SpellcasterMom/test/docs/Компактный терминал на ESP32_ инженерная презентация.png

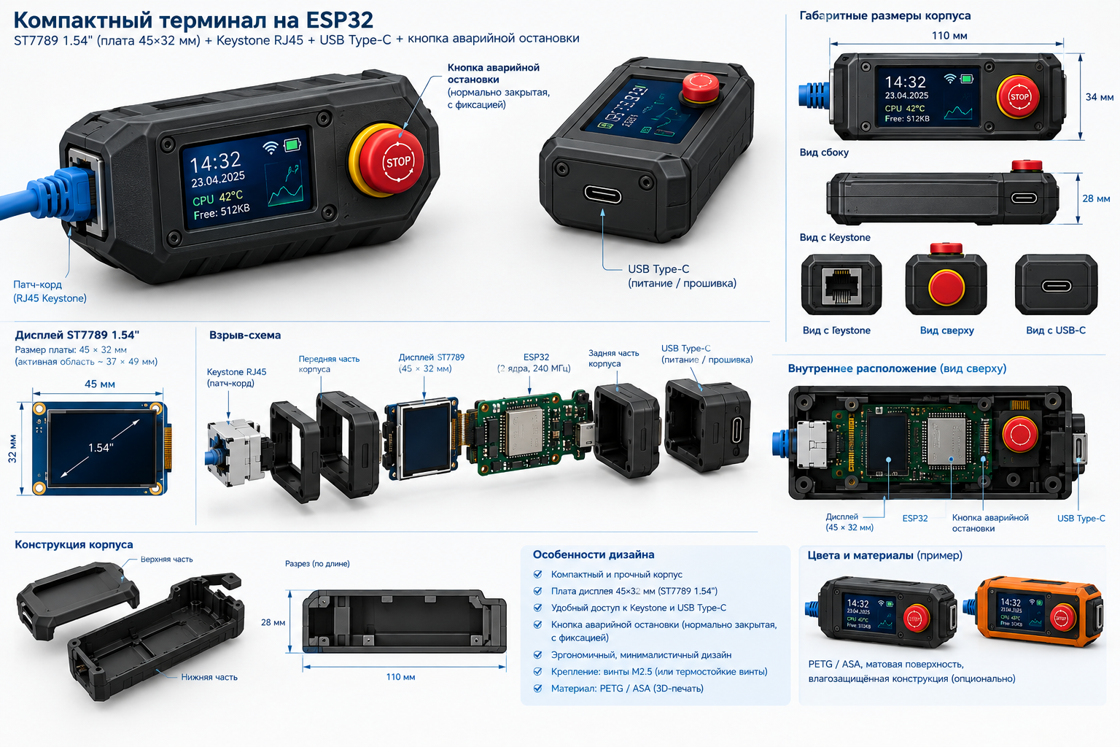
docs/Компактный терминал на ESP32_ инженерная презентация.png
