SpellcasterMom/test/agent.md

# agent.md — рабочие соглашения (проект CLAW, 6DOF)

## Гит
- Работа в ветках, в `master` только принятое на железе; слияние — по команде.
- Несколько машин пушат concurrently: всегда `fetch` перед `push`, чужие коммиты смотреть (`show`/`diff`), мёржить, не перетирать.
- Remote `github` (SpellcasterMom/test) — только по явной команде, иначе молчит.
- Коммиты короткие, по делу; `Last modify` в шапке каждого тронутого файла — обновлять.
- Бамп `FW_VERSION` всегда тянет `FW_VERSION_STR` (минорную тоже).

## Шапки файлов
- `Project / Codename: CLAW / Author / Alma Mater (два слова!) / Group / Mentor / Date / Last modify`.
- «Alma Mater» — раздельно, это латынь. Исключение — только если вуз официально пишет иначе.

## Зависимости
- **Adafruit — нет** (тяжёлые, Unified Sensor не тащим). Лёгкие (pololu, sparkfun) — только после проверки.
- API чужих либ сверять с исходниками до написания кода (адреса, `Wire.begin` внутри, залипающие статусы, unbounded циклы).
- При сомнениях — голые регистры через Wire (пример: `imu_logger.cpp`).

## I2C
- Шина общая (сервы + датчики): все транзакции под `i2cMutex`, только bounded ожидания (никаких `portMAX_DELAY` на шине), `Wire.setTimeout(20)`.
- Счётчики fails/recovers + самовосстановление (`Wire.end/begin` + переинит регистров).
- Физика: подтяжки 4.7к, шлейф ≤20 см, 400 кГц только на хорошей шине (иначе 100 кГц костылём с пометкой).

## Диагностика
- Boot-лог с маркерами; последняя строка = место останова.
- M115: RESIDUAL — истина; скрипты принимают `OK` и `OK:*`.
- Двойник `tools/twin/` предсказывает сверху, валидирован до 0.1° (трекинг-модель).
- Ворота 10 мм / 15° — святое; отказ лучше прыжка в мусор.

## Доки/тексты
- Формулы в MATH.md нумеруются сквозно, ссылки — по номерам.
- «расхождение», не «невязка»; «ограничение», не «рубеж».
- Дипломный стиль: формулы + «где ...» под каждой; читатель умный, но с проектом не знаком (§0).

## Статус: направления P1–P3 (ПАУЗА, продолжение отсюда)

- Ветка `fix-servo-invert-p1p2p3` влита в master (FW9/1.7, флаги F,T,F). Я на `fix-math-s6style`.
- Прошивка в контроллере НЕИЗВЕСТНА (достоверно шили FW8; шился ли FW9 — ?). Маршрут .2.56 мёртв — ждать новый IP.
- Зеркало: `servo=(min+max)−(q+off)`; знак: DH+ ⟺ (флаг ВЫКЛ∧прямое)∨(флаг ВКЛ∧зеркальное). M114 — эхо модели, не физика.
- M502-тесты (флаги T,F,T достоверны; эталоны: P1+15→(−18,+32) влево, P2+15→(−100,+30), P3+15→(−57,+32)): P1 DH−→железо прямое→флаг F; P2 DH−→зеркальное→флаг T; P3 только X, вертикали нет — СПОРНО (визуал 180°: ось неизвестна).
- Слова: CW/CCW сверху, вверх/вниз, на меня/от меня (точка −1000,0,0) — надёжно; влево/вправо, глубина — нет.
- Продолжение: 1) `M115` (FW:x.y!) → 2) `M502` → 3) `G28`+`M105` → 4) P3 ±15 с ОБОИМИ словами → 5) визуал креплений P1/P2 + ось 180° у P3 → 6) флаги → бамп FW → прошить → все DH+ → master. Boot-лог с миграцией — приложить.
