SpellcasterMom/test/docs/MATH.md

# Математика кинематики, планирования и ограничений
### Пояснительная записка (как в дипломе)

## 1. Введение

Объект проектирования — настольный шестиосевой манипулятор: основание с поворотной
башней, плечо, локоть и трёхосевой запястный узел с захватом.

Цель проекта показать умения и навыки разработки и проектирования, полученные во
время обучения в Севастопольском Государственном Университете.

Ввиду жестких ограничений по времени и финансам проект создан
исключительно для демонстрации работы шестиосевого манипулятора.

Электроника — ESP32,
приводы — 7 серво машинок управляемых через PCA9685 (6 осей + захват), обратная связь
по положению отсутствует (open loop по сервам — поэтому вся
точность обязана сходиться в расчёте, глава 3).

Прошивка построена на использовании подмножества G-code «фрезерного»
диалекта: `G0`/`G1` — движение кончика (TCP) в миллиметрах,
`M104` — прямые углы суставов, `M108` — захват в процентах,
`M115` — полная диагностика решения (цель, кандидаты, факт,
расхождения — главный инструмент отладки и приёмки).
Связь с управляющим устройством — по последовательному порту (USB-CDC/UART). 
Ориентация задаётся углами Эйлера ZYX $(A, B, C)$; внутри
расчёта эйлеров нет — только матрицы поворота (почему, см. §3.6).

Три сквозных принципа, на которых всё держится и которые надо учитывать:
1. **Математические углы.** Везде в расчёте используются «чистые» углы
   $q$: ноль — "красивая" поза (плечо вертикально), лимиты —
   симметричные. Перевод в физический мир серв (сдвиги нулей,
   инверсии, микросекунды ШИМ) — отдельная последняя ступень,
   глава 7. Путать эти два мира — источник половины исторических
   багов (см. §7 и §3.4).
2. **Честный отказ.** Неточного движения в прошивке нет как класса:
   любое движение либо сошлось ($\le$ 10 мм / 15°) и безопасно,
   либо не выполняется с диагностируемой причиной в `M115`.
   Пороги и их обоснование — §3.7, философия — §8.
3. **Двойник.** Параллельно с прошивкой есть набор программ `tools/twin/` —
   та же математика на Python (те же сиды, тот же DLS, те же
   пороги). Все числа в записке вида «двойник X — железо Y»
   получены прогоном одного и того же теста на прошивке и двойнике;
   расхождение в десятых — критерий «модель верна».

Система координат: **+X — вперёд, +Y — влево, +Z — вверх**.
Стол — плоскость XY ($z = 0$), origin — центр основания.
Углы суставов $q_1 \dots q_6$ — в градусах, «математические»
(нуль плеча $q_2 = 0$ — вертикаль вверх, см. §3.3).
Сустав 7 ($q_7$) — захват, градусы сервы $7 \dots 38$ (закрыт..открыт,
замер владельца 15.10.2026); проценты `M108` маппятся: $0\% \to 7°$,
$100\% \to 38°$.

Обозначения: $T_{0k}$ — однородная матрица $4 \times 4$ кадра $k$
в базе, $R_{0k}$ — её поворотный блок $3 \times 3$,
$p_k$ — позиция сустава $k$. $\operatorname{atan2}$ — везде
двухаргументный арктангенс (возвращает угол с учётом квадранта,
без разрывов на $\pm 90°$, в отличие от $\arctan$).

---

## Оглавление

- §1. Введение
- §2. Расчет прямой кинематики (FK): цепочка Денавита–Хартенберга
  - 2.1. Матрица однородного преобразования DH
  - 2.2. Параметры цепи (чертёж `docs/robot1.jpg`)
  - 2.3. Цепочка и TCP
- §3. Расчет обратной кинематики (IK): геометрия-сид + матричный DLS
  - 3.1. Этапы расчёта задачи обратной кинематики
  - 3.2. Перенос цели с TCP на запястье
  - 3.3. Геометрия руки: суставы $q_1, q_2, q_3$ (вывод)
  - 3.4. Зажатый сид и компенсация запястья
  - 3.5. Ориентация: суставы $q_4, q_5, q_6$ (сид)
  - 3.6. Численная доводка: Левенберг–Марквардт (DLS)
  - 3.7. Выбор решения: min-residual со штрафами
  - 3.8. Две метрики ориентации — не путать!
  - 3.9. Ворота на кандидате vs дрейф трекинга — не путать!
- §4. Декартово движение (G1/G0): прямая TCP + slerp
  - 4.1. Почему не joint-интерполяция
  - 4.2. Интерполяция позы: lerp + slerp (вывод)
  - 4.3. Трекинг и safety каждого шага
  - 4.4. Время и профиль скорости
- §5. Планировщик объезда (detour): две фазы
  - 5.1. Фаза 1 — via-точки у граней коробов (геометрия)
  - 5.2. Фаза 2 — RRT в joint-space (теория и параметры)
- §6. Проверка ограничений (safety): четыре ограничения
  - 6.1. Ограничение 1 — минимальная высота
  - 6.2. Ограничение 2 — короб workspace
  - 6.3. Ограничение 3 — цилиндр достижимости
  - 6.4. Ограничение 4 — запретные боксы
  - 6.5. Проверка траектории и плотность сэмплирования
  - 6.6. Самопересечения звеньев — капсулы (в работе)
- §7. Сервопривод: цепочка math → микросекунды
  - 7.1. Два мира: математика и железо
  - 7.2. Сдвиг нуля (offset) и таблица приводов
  - 7.3. Коррекция хода и инверсия направления
  - 7.4. Ограничение и ШИМ: разрешение тракта
  - 7.5. Захват P7 и сквозной пример
- §8. Валидация: двойник и железо
  - 8.1. Метод: предсказание — эксперимент — сравнение
  - 8.2. Нулевая поза и воспроизводимость
  - 8.3. Endpoint-демо и наклонный круг
  - 8.4. Отказы: честные и воспроизводимые
  - 8.5. Свип 168 точек с препятствиями
  - 8.6. Границы применимости и открытые пункты
- §9. IMU: фьюжн наклона, калибровка, логгер
  - 9.0. Кадры и единицы: что измеряем
  - 9.1. Комплементарный фьюжн
  - 9.2. Калибровка нуля гироскопа
  - 9.3. Кольцо последнего движения
  - 9.4. Калибровка монтажа (открытый пункт)

---

## 2. Расчет прямой кинематики (FK): цепочка Денавита–Хартенберга

### 2.1. Матрица однородного преобразования DH

Переход между соседними системами координат по соглашению
Денавита–Хартенберга задаётся композицией четырёх элементарных
движений: поворот на угол $\theta$ вокруг оси $Z$, сдвиг
на $d$ вдоль оси $Z$, сдвиг на $a$ вдоль оси $X$, поворот
на угол $\alpha$ вокруг оси $X$:

$$
T = \mathrm{Rot}_z(\theta)\,\mathrm{Tr}_z(d)\,
\mathrm{Tr}_x(a)\,\mathrm{Rot}_x(\alpha).
$$

Раскрытие произведения даёт формулу (1), реализованную
в коде как `FKSolver::dhTransform`:

$$
T(a, \alpha, d, \theta) = \begin{pmatrix}
\cos\theta & -\sin\theta\cos\alpha & \sin\theta\sin\alpha & a\cos\theta \\\\
\sin\theta & \cos\theta\cos\alpha & -\cos\theta\sin\alpha & a\sin\theta \\\\
0 & \sin\alpha & \cos\alpha & d \\\\
0 & 0 & 0 & 1
\end{pmatrix}
\tag{1}
$$

Полный угол каждого сустава: $\theta_i = q_i + \theta_{off,i}$,
где $\theta_{off}$ — заводской сдвиг нулевого положения
(например, $+90°$ у плеча, см. таблицу ниже).

### 2.2. Параметры цепи (чертёж `docs/robot1.jpg`)

| $i$ | $a$ | $\alpha$ | $d$ | $\theta_{off}$ | Назначение звена |
|---|---|---|---|---|---|
| 1 | 0 | +90° | 134 | 0 | база → плечо |
| 2 | 165 | 0 | 0 | +90° | плечо → локоть |
| 3 | 161 | 0 | 0 | 0 | локоть → J4 |
| 4 | 0 | −90° | 0 | −90° | J4 (оси J4/J5 пересекаются) |
| 5 | 53 | +90° | 54 | +90° | J5 → J6 |
| 6 | 0 | 0 | 27 | 0 | J6 → фланец |

Конструктивная особенность: запястье не является сферическим
(расстояние J4→фланец ≈ 107 мм по чертежу); сустав J6 —
вращение вокруг оси инструмента (экспериментально подтверждено:
поворот P6 вращает захват на месте, TCP неподвижен). Палец
захвата длиной $L = 105$ мм продолжает фланец (в DH: переход
J6→фланец 27 мм входит как параметр $d$ звена 6).

### 2.3. Цепочка и TCP

$$
T_{06} = T_1 T_2 \dots T_6, \qquad
\mathbf{n} = \text{третий столбец } R_{06}\ (\text{направление пальца}),
$$

$$
p_{TCP} = p_6 + L \cdot \mathbf{n}. \tag{2}
$$

где $p_{TCP}$ — позиция кончика пальца захвата (задаваемая
в G-code точка), $p_6$ — позиция фланца (конец цепочки, сустав 6),
$L = 105$ мм — длина пальца захвата, $\mathbf{n}$ — единичный
вектор вдоль пальца.

Направления осей суставов в нулевой конфигурации:
J1 — вдоль $Z$, J2 = J3 = J4 — вдоль $-Y$, J5 — вдоль $+Z$,
**J6 — вдоль $+X$**. Нулевая конфигурация $q = 0$:

$$
p_{TCP}(0) = (132,\, 53,\, 514),\quad \text{инструмент } +X.
$$

Контрольная подстановка: плечо вертикально при $q_2 = 0$,
поэтому цепочка J1(134) → +165 → +161 даёт высоту
$z = 134 + 165 + 161 = 460$ на оси; далее запястье со сдвигом
$d_5 = 54$ вдоль собственной оси и фланцем 27 мм выводит TCP в
$(132, 53, 514)$. Значение измерено линейкой на физическом
манипуляторе и принято за калибровочный эталон всей модели.

---

## 3. Расчет обратной кинематики (IK): геометрия-сид + матричный DLS

### 3.1. Этапы расчёта задачи обратной кинематики

Задача: по цели $(p^*, R^*)$ найти $q$ в лимитах
($\pm135°$ для всех суставов P1–P6), где $p^*$ — целевая позиция
кончика пальца (TCP) в миллиметрах $(x, y, z)$ в базовой системе
координат, $R^*$ — целевая матрица поворота инструмента $3 \times 3$
(куда смотрит палец и как он повёрнут вокруг своей оси),
$q = (q_1 \dots q_6)$ — искомые углы суставов в градусах.

Геометрия §3.2–§3.5 — это только **стартовые точки** (сиды):
приближённый аналитический ответ «куда примерно смотрит рука».
Точное решение наводит **матричная** доводка §3.6: внутри DLS
нет ни эйлеров, ни проекций $(r,s)$ — только FK-цепочка матриц,
целевая матрица $R^*$ и матрица ошибки $R_e = R^* R(q)^T$.
Геометрия быстро даёт глобальную структуру (ветвь локтя,
разворот базы), матрицы — точные миллиметры и градусы
с учётом несферического запястья.

### 3.2. Перенос цели с TCP на запястье

Геометрия двухзвенника решает позицию **запястья**, а пользователь
задаёт TCP, поэтому сначала:

$$
w = p^* - L \cdot \mathbf{n}^*, \qquad
\mathbf{n}^* = \text{3-й столбец } R^*. \tag{3}
$$

где $w$ — позиция запястья (то, что реально решает геометрия),
$\mathbf{n}^*$ — целевое направление пальца (третий столбец
целевой матрицы поворота $R^*$).

Без этой поправки ошибка была ≈ 20 мм (решали для запястья,
показывали TCP) — отловлено сравнением M114 с линейкой.

### 3.3. Геометрия руки: суставы $q_1, q_2, q_3$ (вывод)

**База.** Проекция цели на плоскость XY; угол —
однозначно через $\operatorname{atan2}$ (покрывает все 4 квадранта,
особенность только в точке $(0,0)$ — рука строго над осью):

$$
q_1 = \operatorname{atan2}(w_y, w_x). \tag{4}
$$

**Плоскость руки.** После поворота базы вся рука лежит
в вертикальной полуплоскости. Вводим координаты в ней
($d_0 = 134$ — высота плеча, $a_0 = 0$):

$$
r = \sqrt{w_x^2 + w_y^2} - a_0, \qquad
s = w_z - d_0, \qquad
\rho = \sqrt{r^2 + s^2}. \tag{5}
$$

**Достижимость.** Треугольник со сторонами $L_1 = 165$,
$L_2 = 161$ и $\rho$ существует тогда и только тогда, когда

$$
|L_1 - L_2| \le \rho \le L_1 + L_2
\quad\Longleftrightarrow\quad
4 \le \rho \le 326\ \text{мм}. \tag{6}
$$

Внутренняя граница 4 мм — почти вырожденный треугольник
(рука сложена в себя); внешняя 326 мм — полное вытяжение.
Вне кольца — геометрического решения нет (но сид всё равно
строится, см. §3.4).

**Локоть.** По теореме косинусов для угла при вершине локтя:

$$
\rho^2 = L_1^2 + L_2^2 - 2L_1L_2\cos(\pi - |q_3|)
= L_1^2 + L_2^2 + 2L_1L_2\cos q_3,
$$

откуда (знак минус — ветвь «elbow down», $q_3 < 0$):

$$
\cos q_3 = \frac{r^2 + s^2 - L_1^2 - L_2^2}{2L_1L_2},
\qquad q_3 = -\arccos(\cdot). \tag{7}
$$

Аргумент clamp'ится в $[-1, 1]$ от численного дребезга.

**Плечо.** Угол на цель минус внутренний угол треугольника.
Второе слагаемое (8) — та же формула через $\operatorname{atan2}$
(устойчива при $C \approx 0$, т.е. рука перпендикулярна плечу):

$$
q_2^{DH} = \operatorname{atan2}(s, r)
- \operatorname{atan2}\!\big(L_2 \sin q_3,\; L_1 + L_2 \cos q_3\big).
\tag{8}
$$

Здесь $C = L_1 + L_2\cos q_3$ — проекция двухзвенника
на ось руки, $S = L_2\sin q_3$ — поперечная. Геометрический
смысл: $\operatorname{atan2}(s,r)$ — направление на цель,
$\operatorname{atan2}(S,C)$ — поправка на излом в локте.

**Нуль плеча.** Геометрия считает от горизонтали DH-кадра,
а математический нуль — вертикаль:

$$
q_2 = q_2^{DH} - \theta_{off,2}, \qquad \theta_{off,2} = +90°.
\tag{9}
$$

Все три угла — в градусы ($q_1$ тоже: $\times 180/\pi$).

### 3.4. Зажатый сид и компенсация запястья

**Зажатый сид** (`solvePositionClamped`): вместо отказа при
$\rho$ вне кольца (6) точка $(r, s)$ радиально масштабируется
в кольцо $[|L_1-L_2|+\varepsilon, L_1+L_2-\varepsilon]$.
DLS получает старт рядом с целью, а не в произвольной
удалётненной точке. Двойник:
`solve_position(clamped)`.

**Компенсация несферического запястья** (`seedArm`): чистая
геометрия кладёт J4 в точку фланца $O_6$ — сид уходит мимо
на длину J4→O6 (≈ 107 мм). Fixed-point, 3 итерации:

$$
j^{(k+1)} = w - \big(O_6(q^{(k)}) - J_4(q^{(k)})\big),
\qquad j^{(0)} = w, \tag{10}
$$

где $j^{(k)}$ — цель $k$-й итерации (точка, в которую кладём J4),
$O_6(q)$ — позиция фланца при углах $q$, $J_4(q)$ — позиция
сустава J4 (конца двухзвенника) при тех же углах; разность
$O_6 - J_4$ — текущий вылет запястья, который вычитаем из цели.

каждая итерация — §3.3 на новой цели $j$ (строгий или зажатый
вариант). Смысл: требуем, чтобы именно J4 (конец двухзвенника),
а не фланец, лёг в цель с поправкой на вылет запястья.
Отображение сжимающее, пока запястье коротко против
$L_1 + L_2$ (107 против 326 — запас тройной), трёх итераций
хватает с запасом.

**Вторая ветвь** «elbow up»: $q_3 := -q_3$ (в градусах! для
$\sin/\cos$ — перевод в радианы; старая ошибка «градусы в sin»
давала неверное значение $q_2$ — отловлена ревью двойника):

$$
q_2^{up} = \operatorname{atan2}(s, r)
- \operatorname{atan2}\!\big(L_2\sin q_3^{up},\, L_1 + L_2\cos q_3^{up}\big)
- \theta_{off,2}, \tag{11}
$$

на той же компенсированной цели $j$.

### 3.5. Ориентация: суставы $q_4, q_5, q_6$ (сид)

$T_{03}$ — через общий FK-движок (учитывает $\theta_{off}$;
вручную собранные $T_{01}T_{12}T_{23}$ их игнорировали
и дублировали FK — устранено). Далее:

$$
R_{36} = R_{03}^T \cdot R^*, \qquad (R_{03}^{-1} = R_{03}^T).
\tag{12}
$$

Декомпозиция ZYX ($R = R_zR_yR_x$, вывод — приравниванием
элементов матрицы (16) поэлементно):

$$
q_4 = \arcsin(-R_{20}), \quad
q_5 = \operatorname{atan2}(R_{21}, R_{22}), \quad
q_6 = \operatorname{atan2}(R_{10}, R_{00}). \tag{13}
$$

Замок кардана ($|R_{20}| > 0.9999$, pitch ≈ ±90°): строки
$R_{21}, R_{22}$ и $R_{10}, R_{00}$ вырождаются (деления $0/0$
в пределе), поэтому одна степень свободы фиксируется
($q_6 := 0$), вторая доопределяется через surviving
$\operatorname{atan2}$. Решение существует, но не единственно —
для стартовой точки достаточно, точность наводит §3.6.

### 3.6. Численная доводка: Левенберг–Марквардт (DLS)

**Постановка.** Минимизируется взвешенная сумма квадратов
расхождения $\Phi(q) = \frac{1}{2}\|e(q)\|^2$, где $e \in \mathbb{R}^6$
(половина компонент — миллиметры позиции, половина —
«градусы × вес» ориентации, см. (15); множитель $\frac12$
убирается при дифференцировании). Метод Ньютона для суммы
квадратов (Гаусс–Ньютон) линеаризует расхождение вокруг текущей
точки, $e(q + \Delta q) \approx e + J\Delta q$, и решает
нормальную систему $J^TJ\,\Delta q = -J^Te$.
Чистый метод Гаусса–Ньютона отказывает двояко: во-первых,
квадратичная модель достоверна лишь вблизи текущей точки,
и полный ньютоновский шаг регулярно перелетает через минимум;
во-вторых, у кинематических сингулярностей (суставы на одной
линии, рука в полном вытягивании) якобиан вырождается
и нормальная система не имеет устойчивого решения.
Оба отказа лечатся демпфированием Левенберга–Марквардта —
штрафом $\lambda^2\|\Delta q\|^2$ за длину шага:

$$
(JJ^T + \lambda^2 I)\, y = e, \qquad \Delta q = -J^T y,
\tag{14}
$$

где $J$ — якобиан $6 \times 6$ ($\partial e_i / \partial q_j$,
см. (16)), $\lambda$ — демпфирование (больше — мельче и осторожнее
шаг), $I$ — единичная матрица, $y$ — вспомогательный вектор
(решение линейной системы), $\Delta q$ — шаг по суставам в радианах.

эквивалентная форма через $JJ^T$ ($6 \times 6$ вместо $J^TJ$ —
та же размерность здесь; эквивалентность — тождество проталкивания
$(J^TJ + \lambda^2I)^{-1}J^T = J^T(JJ^T + \lambda^2I)^{-1}$,
выбрана форма с взвешенными строками расхождения). Предельные режимы
показывают смысл $\lambda$ как интерполяции между методами:
при $\lambda \to 0$ — шаг Гаусса–Ньютона (быстрая сходимость
вблизи цели), при $\lambda \to \infty$ — шаг градиентного спуска
$\Delta q \approx -\frac{1}{\lambda^2}J^Te$ (короткий и безопасный
вдали от цели). Адаптация $\lambda$ (расписание ниже) перемещается
между режимами автоматически.

Расписание $\lambda$ (параметры кода `NLS_LAMBDA = 0.3` старт):
успешная итерация — $\lambda \times 0{.}5$ (пол $10^{-3}$,
дальше только точнее); неуспешная — $\lambda \times 4$
(потолок $10^4$); 15 неуспехов подряд — останов (точка признана
безнадёжной для данного сида, возвращается лучшее найденное).
Смысл чисел: множитель 4 быстро душит расходящийся шаг,
а 15 застоев отделяют «медленно, но идёт» от «стоит на месте».

**Вектор расхождения.** Позиция — напрямую в миллиметрах:

$$
e_{1..3} = p^* - p(q).
$$

Ориентация — axis-angle ошибки с весом $W = 30$:

$$
R_e = R^* R(q)^T, \quad
\theta_e = \arccos\!\left(\tfrac{\operatorname{tr} R_e - 1}{2}\right),
\tag{15}
$$

$$
e_{4..6} = W \cdot \theta_e \cdot \mathbf{u}, \quad
(R_e - R_e^T)^\vee = 2\sin\theta_e \, \mathbf{u}.
$$

Вывод оси: для любого поворота $R(\mathbf{u}, \theta)$ верно
$R - R^T = 2\sin\theta\,[\mathbf{u}]_\times$, компоненты
кососимметричной части — это $(2\sin\theta\,u_x,
2\sin\theta\,u_y, 2\sin\theta\,u_z)$, т.е. $a_x = R_{21}-R_{12}$
и т.д. Нормировка $a/\|a\|$ даёт $\mathbf{u}$, домножение
на $\theta_e$ — вектор $\theta_e\mathbf{u}$.

Почему вес 30: $1° = 0.0175$ рад $\times 30 \approx 0{.}52$
«условных мм» — градус ориентации стоит полмиллиметра позиции
(комментарий в коде: «1° ≈ 0.5 усл.мм»). Баланс подобран так,
чтобы DLS не жертвовал сантиметрами ради градуса и наоборот.

Почему axis-angle, а не разность эйлеров: эйлерова разность
имеет разрывы свёртки $\pm180°$ (прыжок метрики при непрерывном
движении → ложный всплеск якобиана → «большой градиент»).
Хуже того, свёртка через синус ($0{.}5\sum\mathrm{cross}$)
при $\theta_e \to 180°$ показывает **ноль** и тянет решатель
к ложному минимуму «вверх ногами». Axis-angle непрерывен
всюду, кроме точки $\theta_e = \pi$ (там ось вырождена —
закрыта запасной осью $X$: приближённо, но сохраняет градиент
и не даёт ложный ноль»).

**Якобиан** — численный: столбец $j$ —

$$
J_{ij} = \frac{e_i(q + \delta \mathbf{b}_j) - e_i(q)}{\delta},
\qquad \delta = 10^{-4}\ \text{рад}. \tag{16}
$$

где $\mathbf{b}_j$ — $j$-й базисный вектор (единица в позиции $j$,
нули иначе: возмущаем только сустав $j$), $\delta$ — шаг численного
дифференцирования в радианах.

Цена итерации: 7 вычислений $e$ (база + 6 возмущений),
каждое — полный FK, плюс решение системы $6 \times 6$ методом
Гаусса (~$6^3/3$ операций). Итого worst case: ~700 FK-вычислений
и 100 решений СЛАУ на доводку — единицы миллисекунд на ESP32,
т.е. метод укладывается в такт интерполятора 20 мс с запасом.
Аналитический якобиан ($J_v$ через
$z_{k-1} \times (p - p_{k-1})$) был бы в 7 раз дешевле,
но численный не расходится с FK по определению —
осознанная плата за неубиваемость (и она же даёт
зеркало 1:1 с двойником).

**Знак минус** в (14) обязателен: минимизируется
$\|e + J\Delta q\|^2 + \lambda^2\|\Delta q\|^2$, т.е.
$(J^TJ + \lambda^2I)\Delta q = -J^Te$. Без минуса — подъём
вместо спуска: все шаги бракуются line search и итогом
всегда остаётся сид (реальный отловленный баг, M115
показывал `seed = best` во всех строках).

**Active-set на лимитах.** Сустав, стоящий на лимите
($\pm\varepsilon = 10^{-4}$) и толкающий наружу, исключается
из задачи (обнуляется столбец $J$), направление пересчитывается
(до 6 раундов). Иначе зажатое направление душит спуск
по свободным суставам: проекция градиента на допустимый
ортант — классика constrained optimization, здесь —
напрямую, без QP-солвера (6 суставов позволяют).

**Line search.** Backtracking: полный шаг, половинки, …
до 10 попыток — берётся первый, строго уменьшивший $\|e\|$.
Иначе $\lambda \times 4$ (потолок $10^4$), после 15 застоев —
стоп. При успехе $\lambda \times 0{.}5$ (пол $10^{-3}$).
Ограничение шага: $|\Delta q_k| \le 0{.}2$ рад/итерацию.

**Возврат.** Лучшее $q$ за все итерации (не последнее —
при несходимости последнее может быть хуже). Пробные точки
дополнительно зажимаются в лимиты сервоприводов (выход
за пределы физически невозможен даже промежуточно).
Допуски: 1 мм / 1°, лимит 100 итераций. Захват ($q_7$) не трогается.

**Чтение сходимости по M115 (разбор живого примера).**
Диагностика сида: `seed=107.6mm/98.5deg` (расхождение
старта) → `dq0` (норма первого шага) → `n1` (расхождение после
него) → `fail/53it` (итог). Эталонная расшифровка на строке
T1 [0] (`seed=101.7/79.0, dq0=0.486, n1=121.1, fail/50it`):
норма первого шага 0.486 рад — здоровый начальный шаг
(не ноль — градиент есть, не единица — без перелёта);
$n_1 = 121.1 > seed = 101.7$ — полный шаг Гаусса–Ньютона
перелетел (классика), backtracking его уполовинил,
$\lambda$ выросла; дальше — 50 итераций шлифовки,
сошедшихся не в допуски, но в лучшее найденное.
По этой цепочке видно, где умерла сходимость:
`seed = best` во всех строках — нулевой прогресс
(подпись отменённого минуса — регрессионный маркер,
см. выше); `n1 < seed`, но `fail` — прогресс был,
но допуски не взяты (точка на грани достижимости).

### 3.7. Выбор решения: min-residual со штрафами

Кандидаты (до 4): elbow down/up + «нули» (сильная ветвь
верхней полусферы; для цели «нули» — 0 итераций) + доводка
от текущей позы (трекинг при стриминге: DLS из current
сходится за ~2 итерации — двойник 40/40 из ±10°).

Каждая оценивается честным FK (`diagEvalSol`): $dPos$ —
евклидово до TCP (мм), $dOri$ — **угол между осями инструмента**
(см. §3.8), $safe$ — `checkAllLinks`, $minZ$ — минимум $z$
суставов J2..J6 (без J0/J1: база и плечо всегда высоко,
признак низко висящей ветви несут локоть и ниже).

Чистый минимум расхождения не годится: он выбирает самую точную
ветвь, не глядя, как рука туда попадёт, — отсюда перебросы
на 250° ради долей миллиметра и любовь к низким скрюченным
конфигурациям. Поэтому к точности добавляются два штрафа —
за дальность прыжка и за низость ветви:

Оценка:

$$
\mathrm{score} = dPos + dOri + 0{.}02 \cdot \Delta q_{max} + hPen,
\tag{17}
$$

$$
hPen = \min\!\big(0{.}15 \cdot \max(0, 150 - z_{min}),\; 15\big),
$$

- $\Delta q_{max}$ — максимальный прыжок сустава от текущей
  позы; коэффициент $0{.}02$ — это штраф за дальность прыжка
  (continuity-штраф: прыжок 50° окупается лишь
  при +1 мм/1° точности, потому что каждый градус прыжка —
  это риск хлыста и лишнее время хода; чистый min-residual выбирал ветвь
  в 250° ради 0.3 мм — резкие перебросы без необходимости,
  отловлено двойником на круге);
- $hPen$ — высотный штраф (штраф за низость ветви: ниже $z = 150$
  предпочитаем верхние   ветви, потому что верхняя конфигурация
  дальше от стола, колонны и собственных деталей — небольшой
  проигрыш в точности окупается запасом безопасности, тогда как
  столкновение недопустимо ни при какой точности);
  низко висящая ветвь с локтем на $z = 17$ проигрывает высокой
  ветви; срезка 15 делает честно-низкую работу нейтральной
  (штраф у всех максимальный и одинаковый — решает расхождение).

Из опыта отладки: «первый безопасный» систематически брал
худший вариант (M115: [0] 2.7 мм/23.8° вместо [1] 2.2 мм/0.0°) —
поэтому полный перебор с оценкой, а не выход по первому годному.

**Порог годности** (ворота движения):

$$
dPos \le 10\ \text{мм} \quad \text{и} \quad dOri \le 20°.
\tag{18}
$$

Лучший безопасный кандидат хуже порога — уже не заданное
движение (например, 127 мм мимо из-за отбраковки точных,
но опасных). Отказ `ERROR: No accurate safe IK` с лучшим
достигнутым расхождением. Рабочие ходы идут с $dPos < 1$ мм
(двойник + железо). Философия: лучше честно стоять,
чем выполнять недостоверное движение.

### 3.8. Две метрики ориентации — не путать!

Внутри DLS (§3.6) минимизируется **полное** axis-angle-расхождение
(15) — все три вращательные степени, включая roll вокруг
пальца. А в отборе (17), пороге (18) и M115 $dOri$ — **угол
между осями инструмента**:

$$
dOri = \arccos(\mathbf{n}(q) \cdot \mathbf{n}^*).
\tag{19}
$$

Обоснование: ось пальца — то, что ставит точку и сверлит;
roll вокруг неё обычно не критичен (P6 крутит захват
на месте). DLS при этом всё равно тянет полную ориентацию,
так что расхождение метрик — только в воротах, не в движении.
Для задач, где roll важен (захват плоского предмета),
ворота (18) надо ужесточать отдельно — открытый пункт.

### 3.9. Ворота на кандидате vs дрейф трекинга — не путать!

Ворота (18) проверяются на **кандидате** (решение IK для конца),
а едет декарт трекингом по шагам — конечный факт может уплыть
дальше кандидата. Живой кейс: точки 17/18 наклонного круга —
кандидат прошёл (≤15°), факт 19.0/19.2°. Это не баг ворот,
это их граница: ворота гарантируют качество старта решения,
а не финиша трекинга. Диагностика честная в обе стороны:
`RESIDUAL` показывает факт, `INTERP: NONE no motion (refused)`
после отказа — что прошлого следа не осталось (раньше M115
показывал INTERP прошлого удачного хода — починено).

---

## 4. Декартово движение (G1/G0): прямая TCP + slerp

### 4.1. Почему не joint-интерполяция

Линейное движение в суставах ($q(t) = q_0 + t(q_1 - q_0)$)
даёт дугу TCP в декартовых координатах — для прямолинейных
операций (сварка, вставка, проход над столом) неприменимо.
Поэтому задаётся обратное: прямая фиксируется в декарте,
а углы суставов на каждом шаге восстанавливаются
IK-трекингом (§4.3).

### 4.2. Интерполяция позы: lerp + slerp (вывод)

Позиция — линейная с профилем $e(t)$ (§4.4):

$$
p(t) = p_0 + e(t)\,(p_1 - p_0). \tag{20}
$$

где $p_0$, $p_1$ — стартовая и целевая позиции TCP (мм),
$t \in [0, 1]$ — безразмерное время шага, $e(t)$ — профиль
скорости (0 → 1, см. (25) в §4.4).

Ориентация — slerp (spherical linear interpolation):
поворот с постоянной угловой скоростью от стартовой матрицы
$R_0$ к целевой $R_1$. Относительный поворот между ними:

$$
R_d = R_0^T R_1, \quad
\theta = \arccos\!\left(\tfrac{\operatorname{tr} R_d - 1}{2}\right),
\tag{21}
$$

где $R_d$ — относительный поворот (величина доворота
и его направление от старта к цели), $\theta$ — его угол,
$\operatorname{tr}$ — след матрицы (сумма диагонали).
Ось $\mathbf{u}$ извлекается из кососимметричной части
тем же выделением оси, что в (15). Тогда:

$$
R(t) = R_0 \cdot \mathrm{Rot}(\mathbf{u},\, \theta \cdot e(t)).
\tag{22}
$$

где $\mathrm{Rot}(\mathbf{u}, \alpha)$ — поворот на угол $\alpha$
вокруг единичной оси $\mathbf{u}$ (формула Родрига (23) ниже).

Постоянство угловой скорости следует из конструкции:
угол от $R_0$ до $R(t)$ равен $\theta \cdot e(t)$ — при линейном
$e(t) = t$ движение равномерно, $\dot{\phi} = \theta/T$.
Матрица поворота вокруг оси задаётся формулой Родрига (23).
Вывод формулы: разложение экспоненты генератора поворота
$R = e^{\phi[\mathbf{u}]_\times}$ в ряд с учётом тождества
$[\mathbf{u}]_\times^3 = -[\mathbf{u}]_\times$ даёт
$R = I + \sin\phi\,[\mathbf{u}]_\times
+ (1 - \cos\phi)\,[\mathbf{u}]_\times^2$.
Покомпонентно ($c = \cos a$, $s = \sin a$, $a = \theta e(t)$ —
текущий угол доворота, $(x, y, z)$ — компоненты единичной оси
$\mathbf{u}$):

$$
\mathrm{Rot} = \begin{pmatrix}
c+x^2(1-c) & xy(1-c)-zs & xz(1-c)+ys \\\\
yx(1-c)+zs & c+y^2(1-c) & yz(1-c)-xs \\\\
zx(1-c)-ys & zy(1-c)+xs & c+z^2(1-c)
\end{pmatrix}
\tag{23}
$$

— ровно эта матрица собирается в коде из $ca, sa, x, y, z$.

Вырождение $\theta \approx 180°$: ось, извлекаемая
из $(R_d - R_d^T)$, обращается в нуль. Резервный вариант —
столбец максимальной диагонали $(R_d + I)/2$: для поворота
на $\pi$ справедливо $R_d + I = 2\mathbf{u}\mathbf{u}^T$,
т.е. диагональные элементы равны $2u_i^2$, а внедиагональные —
$2u_iu_j$. Вычисляется $\max(xx, yy, zz)$, ось восстанавливается
с корректным знаком через смешанные элементы. Без этой ветви
разворот «через спину» приводил к неопределённости оси (NaN)
и останову движения.

Матрица цели шага $R_t$ (из slerp (22)) передаётся
**напрямую** в матричный доводчик `refineSolutionM` —
промежуточного перевода в углы Эйлера нет. Это осознанно:
углы Эйлера $(A, B, C)$ имеют разрыв свёртки на $\pm180°$ —
значения $+179°$ и $-179°$ физически различаются на $2°$,
а численно — на $358°$. Линейная интерполяция самих углов
(от $A_0$ к $A_1$ напрямую числами) в такой ситуации повела бы
инструмент длинным путём через весь оборот либо дала скачок.
У матриц поворота разрыва нет (пространство поворотов непрерывно),
поэтому slerp всегда идёт короткой дугой и скачкообразных
изменений ориентации не возникает.

Углы Эйлера вычисляются один раз на шаг — и только потому,
что их требует интерфейс резервной геометрии `solveAll`:
на вход она принимает структуру `Pose` (позиция + тройка
эйлеров $A, B, C$). Это однократное преобразование матрица→эйлеры
безвредно: выбор среди кандидатов `solveAll` делается
по дистанции в пространстве суставов до $q_{prev}$
(углов предыдущего шага, в градусах суставов), а не по
близости эйлеровых троек, — поэтому артефакты свёртки
на выбор повлиять не могут в принципе.

Замечание о терминах (важно не путать): тройка $(A, B, C)$ —
это желаемая ориентация **инструмента целиком** (куда смотрит
палец и как он повёрнут вокруг своей оси), а не углы запястья.
Углы суставов запястья $q_4, q_5, q_6$ — это результат
разложения (§3.5): ответ на вопрос «как выставить суставы»,
а не постановка задачи.

Вырожденный случай: $\|p_1 - p_0\| < 0{.}5$ мм и $\theta < 0{.}5°$ —
движение отсутствует, сразу успех (защита от дрожания при
потоковой подаче мелких шагов).

### 4.3. Трекинг и safety каждого шага

Каждый декартов шаг — это IK **от предыдущего** $q$ (тёплый старт
метода Ньютона: сходимость за ~2 итерации, поскольку шаг мал
и стартовая точка уже находится в бассейне притяжения)
плюс проверка `checkAllLinks` (§6).
При срыве — останов на последнем корректном шаге. Команда M112,
поступившая в Serial посреди цикла, прерывает движение немедленно
(проверка в каждой итерации шага).

Грубая end-IK для оценки времени: из двух вариантов
{трекинг-refine, геометрия solveAll} берётся ближайший
к текущей конфигурации — автономный refine иногда уходит
в дальнюю ветвь и завышает время в разы (рука после этого
движется медленно, хотя геометрически путь рядом).

### 4.4. Время и профиль скорости

Длительность движения определяется самым медленным суставом:

$$
T = \max_{i=1..7} \frac{|q_i^{goal} - q_i^{start}|}{\omega_i}
\cdot \frac{100}{F}, \tag{24}
$$

$\omega_{1..3} = 45°/\text{с}$ (дефолт; $F$ — подача G-кода
в процентах, $F = 100$ — полная). Число шагов:
$N = T / 20\,\text{мс}$ (`STEP_INTERVAL_MS = 20`;
порог страгивания `MIN_STEP_DEG = 0{.}1°` — меньшие смещения
не исполняются).

Профиль — квадратичный ease-in-out:

$$
e(t) = \begin{cases}
2t^2, & t < 0{.}5, \\\\
1 - \dfrac{(2 - 2t)^2}{2}, & t \ge 0{.}5,
\end{cases}
\qquad e(0) = 0,\ e(1) = 1. \tag{25}
$$

Скорость $\dot{e}(t) = 4t$ / $4(1-t)$: старт и финиш
с нулевой скоростью (без рывка), максимум $2$ в середине —
при том же $T$ движение в 1.5 раза быстрее равномерного
($\int_0^1 e = 0{.}5$ в обоих случаях, но ease-in-out
концентрирует скорость в середине пути). Ускорение
кусочно-постоянно и равно $\pm4/T^2$ (разрыв ускорения —
только в точке $t = 0{.}5$; при наших скоростях допустимо,
механика сервоприводов дополнительно сглаживает профиль).

---

## 5. Планировщик объезда (detour): две фазы

Задача планировщика — соединить стартовую конфигурацию $q_{start}$
с целевой $q_{goal}$ цепочкой промежуточных вейпоинтов
$w_1 \dots w_m = q_{goal}$, каждое ребро которой безопасно
(проверяется §6), а инструмент при этом не проходит сквозь
запретные боксы. Архитектура двухфазная по экономическим
соображениям: сначала вычислительно недорогая геометрическая
фаза (десятки операций, закрывает типовой случай «столб
посередине»), и только если её недостаточно — затратная
сэмплинговая фаза в пространстве суставов. Исполнение цепочки — через
`moveToDetour` (каждый лег — движение §4). Зеркало алгоритма:
`tools/twin/detour.py` — те же этапы, те же пороги.

### 5.1. Фаза 1 — via-точки у граней коробов (геометрия)

Поводом для объезда служит пересечение отрезка TCP
старт→цель с активным боксом $(x_{1,2}, y_{1,2}, z_{1,2})$.
Пересечение детектируется прямолинейно — 21 равномерной пробой
$p(t) = p_0 + t(p^* - p_0)$ с тестом попадания (29) в каждой.
Если пересечения нет, фаза завершается пустой (объезжать нечего).
Иначе для каждого задетого бокса строится 7 кандидатов в обход:
шесть отступов от граней на `DET_CLEAR = 30` мм
($x_1 - 30$, $x_2 + 30$, $y_1 - 30$, $y_2 + 30$,
$z_1 - 30$, $z_2 + 30$ — по остальным осям берётся центр бокса)
плюс середина исходного отрезка (на случай, когда бокс лишь
«проколот» отрезком, а рядом свободно).

Каждый кандидат проходит тройной фильтр (все условия обязательны):
во-первых, точка обязана лежать вне **всех** активных боксов —
иначе объезд одного препятствия упрётся в соседнее;
во-вторых, IK-точность $dPos \le 5$ мм (`DET_VIA_DPOS`) —
via обязана быть точнее порога движения (18), иначе её
собственная ошибка съест запас точности всего пути;
в-третьих, `checkAllLinks` для конфигурации via чист (§6)
и ребро старт→via проходит `checkTrajectory` (10 проб,
`DET_RRT_EDGE`). Лимит фазы — 8 via-точек (`vias[8]`);
на практике хватает одной-двух.

### 5.2. Фаза 2 — RRT в joint-space (теория и параметры)

Прежде чем строить дерево, проверяется быстрый путь —
ребро старт→цель напрямую (`checkTrajectory`, 20 проб).
Он свободен в подавляющем большинстве движений (порядка 95%),
и тогда планировщик завершается сразу, без сэмплинга.

В оставшихся случаях строится RRT (Rapidly-exploring Random Tree)
в пространстве суставных углов $\mathbb{R}^6$. Поиск ведётся
именно в joint-space, а не в декарте, по соображениям стоимости:
проверка ребра — это готовый быстрый `checkAllLinks` (§6),
тогда как декартово ребро требовало бы IK на каждой пробе
(вычислительно затратно, плюс разрывы ветвей при смене
конфигурации).
Метрика дерева — евклидова в градусах $\mathbb{R}^6$;
это осознанное упрощение (градус базы даёт большее смещение
TCP, чем градус запястья), достаточное для поиска прохода —
оптимизация длины пути отдана сглаживанию ниже
(см. абзац «Сглаживание»).

Параметры роста (`detour_planner.cpp`) подобраны под ESP32:
потолок дерева — 120 узлов (`DET_RRT_NODES`), память статическая
($120 \times 7$ чисел с плавающей точкой плюс родители —
единицы килобайт, динамического выделения нет);
шаг роста — 30° (`DET_RRT_STEP`), новый узел откладывается
от ближайшего к случайной пробе по формуле
$q_{near} + (q_{rnd} - q_{near}) \cdot \min(1, 30/\|d\|)$
с зажимом в лимиты сервоприводов;
смещение к цели (goal bias) 30% — каждая третья проба
подменяется самой целью, что ускоряет сходимость в разы
против чистого равномерного сэмплинга;
генератор — LCG (линейный конгруэнтный генератор:
следующее псевдослучайное число получается из предыдущего
по формуле $x_{n+1} = 1664525\,x_n + 1013904223$)
с фиксированным сидом 12345, т.е. дерево **детерминировано** —
повтор даёт то же дерево (воспроизводимость для диплома
и отладки; оборотная сторона — зацикливание на одном
и том же неуспехе лечится сменой сида).
Ребро принимается в дерево, только если узел чист
по `checkAllLinks` и ребро от родителя проходит
`checkTrajectory` (10 проб); стыковка с целью проверяется
каждую 4-ю итерацию плюс финальной попыткой из ближайшего
к цели узла.

Теоретическое свойство метода (для записки): RRT
**вероятностно полон** — при числе узлов, стремящемся
к бесконечности, вероятность найти проход (если он существует)
стремится к единице. При нашем потолке 120 узлов практическое
прочтение скромнее: простой обход будет найден, сложную щель
метод может не найти — этот случай покрывает честный отказ
(§3.7, ворота (18)).

**Сглаживание.** Сырая цепочка «родитель→потомок»,
извлечённая из дерева, имеет пилообразную форму, поэтому
применяется жадное спрямление срезами: от текущего узла
цепочки выбирается самый дальний узел, достижимый
проверенным ребром (`checkTrajectory`, 10 проб), и далее —
от него. Сложность процедуры — $O(m^2)$ проверок рёбер
при длине цепочки $m$ (цепочки короткие — не критично),
а результат — почти минимальная по числу хопов цепочка
в построенном дереве (не глобальный оптимум,
но гладкий путь без пилы).

**Усечение и возврат.** Хвост цепочки — всегда проверенная
цель. Если цепочка целиком не помещается в выходной буфер
`wps[cap]`, стартовая точка пропускается: оборванная цепочка
без цели хуже отказа (исполнение остановилось бы
в промежуточной точке без команды). Возврат 0 означает
«обхода нет» и превращается выше в честный отказ из §3.7.

В M115 исполнение видно как `INTERP: DET n` ($n$ — число
вейпоинтов), `WPS nwp=N [...]`, `minZ=...`.

---

## 6. Проверка ограничений (safety): четыре ограничения

Для заданной конфигурации $q$ прямая кинематика даёт позиции
всех суставов, и каждое звено рассматривается как отрезок
$A \to B$ от сустава $i$ к суставу $i+1$. Проверяются звенья
с индексами 1..6, плюс виртуальное 7-е звено (J6→TCP — палец
захвата). Звено 0 (J0→J1, колонна основания) исключено сознательно:
оба его конца зафиксированы всегда, поэтому отрезок постоянен
и проверять его нечего; попутно это экономит примерно седьмую
часть времени safety-проверок и исключает ложные срабатывания
на неподвижной базе. Каждое проверяемое звено сэмплируется
в 6 равноотстоящих точках ($t = 0, 0{.}2, \dots, 1$ вдоль отрезка
по формуле линейной интерполяции), и каждая точка проходит
четыре ограничения (26)–(29) ниже. Первая же нарушенная проверка
фиксируется как причина (`lastError` → поле `FAIL` в M115
и строка состояния дисплея), остальные не проверяются.

### 6.1. Ограничение 1 — минимальная высота

$$
p_z \ge zMin_i, \tag{26}
$$

$zMin$ задаётся индивидуально для каждого звена (значения по
умолчанию: база и плечо — 0, остальным — 25 мм над столом).
История значения показательна: исходные 10 мм не обеспечивали
зазора предплечья со столом при вытянутых позах (G0 X250 Y-250 Z100),
поэтому порог повышен до 25 мм. Настраивается командой M420
(`M420 L1 Z=30` — звену 1 минимум 30 мм). Назначение ограничения —
защита от столкновения со столом, наиболее вероятного
препятствия: проверка прямая (сравнение одной координаты)
и неоспоримая.

### 6.2. Ограничение 2 — короб workspace

$$
x \in [-560, 560],\quad y \in [-560, 560],\quad
z \in [0, 700], \tag{27}
$$

$z_{min} = 0$ соответствует уровню стола. Численные границы —
не произвольные, а измеренные: двойник прогнал 4000 случайных
конфигураций и зафиксировал экстремумы ($\max R_{xy} = 539$,
$\max|X/Y| = 525$, $\max Z = 667$), короб взят с запасом поверх.
Прежние границы 250/400 происходили из неверной геометрической
модели и браковали даже нулевую позу (TCP при $z = 514$
оказывался вне короба) — поучительный пример того, как ошибка
модели превращается в систематический ложный отказ.

### 6.3. Ограничение 3 — цилиндр достижимости

$$
\mathrm{minReach} \le \sqrt{x^2+y^2} \le \mathrm{maxReach},
\qquad \text{дефолт } [0,\, 560]\ \text{мм} \tag{28}
$$

(560 = истинный вылет ≈ 539 + запас). Внешняя граница
продублирована здесь в декартовых координатах: это то же
кольцо достижимости (6), но выраженное через проверяемую точку,
а не через решение треугольника. Внутренняя граница (если её
поднять с нуля) служит грубой защитой от складывания руки
в себя — цилиндр вокруг оси основания, внутрь которого
звеньям заходить запрещено. Проверка выполняется дважды:
для точек вдоль звеньев и отдельно для самих суставов J1..J6
в `checkAllLinks` (сустав вне цилиндра бракует конфигурацию
сразу, без сэмплирования звена).

### 6.4. Ограничение 4 — запретные боксы

$$
x_1 \le x \le x_2 \;\land\;
y_1 \le y \le y_2 \;\land\;
z_1 \le z \le z_2 \tag{29}
$$

Тест представляет собой строгое произведение интервалов
(порядок границ при вводе значения не имеет: команда M410
упорядочивает их автоматически). Допускается до 10 зон,
набор сохраняется в EEPROM и переживает перезагрузку;
просмотр — командой M417.

**Конструктив колонны** — зона 0, присутствующая по умолчанию:
бокс $[-65, 65]^2 \times [0, 180]$ с маской пропуска
`skipLinks = 0x07` (биты 0,1,2: звенья стоек не проверяются
против зоны, частью которой являются по построению).
Необходимость маски принципиальна: без неё плечо, стоящее
на колонне, постоянно фиксировалось бы как столкновение
с самой колонной — ложный отказ на любом движении.
Управление маской — команда M116 (установка/снятие битов),
действующая маска видна в M115.

### 6.5. Проверка траектории и плотность сэмплирования

`checkTrajectory(q_a, q_b, N)`: линейная интерполяция
в пространстве суставов ($N = 20$ по умолчанию, $10$ в RRT)
с вызовом `checkAllLinks` в каждой промежуточной пробе.
Ограничение метода, существенное для записки: дискретное
сэмплирование принципиально не замечает препятствия тоньше
шага дискретизации (звено 165 мм при 5 интервалах даёт
33 мм между соседними пробами на звено; тонкая стенка бокса
может оказаться целиком между пробами $t_k$ и $t_{k+1}$).
Компенсирующие факторы: боксы по построению объёмны
(не плоскости); траекторные пробы добавляют ещё 20 сечений
поверх внутризвенных; критичный конструктив окружён запасом
30 мм (`DET_CLEAR`). Полноценной непрерывной проверки
столкновений (continuous collision detection) нет —
открытый пункт (см. техдолг самоколлизий в TODO);
развитием темы является капсульная модель §6.6.

### 6.6. Самопересечения звеньев — попарная дистанция (реализовано)

Статус: реализовано в `checkLinkDistances` (`safety_checker`), параметр
`minLinkDistance` (по умолчанию 20 мм). Защита от самопересечения
(кисти/предплечья с плечом/локтем): звенья моделируются отрезками
J0→J1→…→J6→TCP, виртуальное 7-е звено — отрезок J6→TCP (палец).
Проверяются все пары звёвен $(i, j)$ с $j > i+1$ (соседние делят сустав —
пропуск; базовая колонна звено 0 — по соглашению не проверяется).
Расстояние между отрезками считается аналитически
(`distSegmentSegment2`, ближайшие точки на отрезках; сравнение в
квадратах, sqrt — только для текста ошибки). Порог:
`minLinkDistance`, задаётся в `LinkSafety`, значение по умолчанию 20 мм,
0 = выключено.

Порядок монитор→запрет в зависимости от режима движения:
- **IK-путь (G0/G1):** `checkAllLinks && checkLinkDistances` — при
  нарушении порога жёсткий отказ (`lastError` с парой звеньев,
  `FAIL` в M115, движение не начинается).
- **Ручное управление (M104 / DIRECT_MODE):** жёсткие проверки safety
  (Z, рабочая зона, радиус, запретные зоны) блокируют как прежде;
  самопересечение — **только предупреждение** (`WARN: Self-collision risk`
  в Serial), движение не блокируется.

Ограничение метода: дискретное сэмплирование траектории
(`checkTrajectory`, 20 пробы) не замечает самопересечение между прбами;
continuous collision detection не реализован — открытый пункт.

---

## 7. Сервопривод: цепочка math → микросекунды

### 7.1. Два мира: математика и железо

Во всей математике (FK, IK, safety, дисплей, DLS) живёт
**математический** угол $q_{math}$: нуль — красивая поза
(плечо вертикально), лимиты — симметричные относительно нуля.
Физическая серва про этот нуль ничего не знает: у неё свой
диапазон вала, своё направление вращения и свой масштаб
импульсов. Разделение строгое: вся «грязь» железа изолирована
в одной функции `ServoController::setAngle`, а хранилище углов
`currentAngles` содержит всегда math (без offset и коррекции).
Следствие для диплома: FK, IK, safety, дисплей и DLS работают
в «чистой» системе координат и про железо не знают вообще;
компенсация люфта редукторов живёт отдельно, в интерполяторе
(`backlash_compensator`), а не в цепочке преобразования угла.

### 7.2. Сдвиг нуля (offset) и таблица приводов

Нуль математики отображается в середину хода сервы — тогда запас
хода в обе стороны максимален. Преобразование:

$$
\phi = q_{math} + \theta_{off}, \tag{30}
$$

где $\phi$ — угол вала сервы (градусы физического поворота),
$q_{math}$ — математический угол из IK/интерполятора (градусы),
$\theta_{off}$ — заводской сдвиг нуля для данного сустава (градусы).
Таблица приводов (заводские данные + `DEFAULT_SERVO_CONFIG`):

| Сустав | Серва | Физ. диапазон | $\theta_{off}$ | Скорость |
|---|---|---|---|---|
| P1–P6 | 270° (20/70/70 кг) | $[0, 270]$ | $135°$ | $45°$/с |
| P7 (захват) | $7 \dots 38°$ (MG90S, закрыт..открыт) | $[7, 38]$ | $7°$ | $90°$/с |

Так, $q_{math} = 0$ даёт $\phi = 135°$ (P1–P6);
у P7 нуль math вне диапазона — home закрыт ($7°$).

### 7.3. Коррекция хода и инверсия направления

Редукторы экземпляров различаются, поэтому после сдвига
применяется калибровочный множитель: $\phi := \phi \cdot
(correction/100)$, где $correction = 100$ означает отсутствие
коррекции (значение $105$ растягивает ход на $5\%$). Параметр
хранится в конфигурации сервы и правится M-кодом калибровки.

Зеркально установленные сервы (вал смотрит в противоположную
сторону) требуют обращения направления. Обращение выполняется
зеркалом относительно **центра** серво-диапазона, а не сменой
знака: $\phi := (\phi_{min}+\phi_{max}) - \phi$, где границы —
математические лимиты, смещённые на offset. Наивный вариант
$-\phi$ с последующим clamp ошибочен: для P1 ($q = 0$)
он даёт $-135°$, что clamp режет в $0$ вместо $135°$,
и края $\pm135°$ аналогично схлопываются в нуль
(баг был, отловлен симуляцией всех 7 серв × оба флага:
монотонность, центр, границы). При корректном зеркале центр
стоит, края меняются местами (P1: $0 \to 135$,
$+135 \to 0$, $-135 \to 270$). Предварительные флаги по первым
M502-тестам направлений и осмотру посадок: P1 — прямая,
P2 — зеркальная, P3 — прямая (разворот P3 на $180°$ —
вокруг собственной оси, направление сохраняет).
Статус: вопрос открыт, разбираемся отдельно (см. TODO).

### 7.4. Ограничение и ШИМ: разрешение тракта

Угол ограничивается серво-диапазоном (границы math, смещённые
на offset — проверка, что команда физически исполнима),
затем линейно отображается в длительность импульса:

$$
U = U_{min} + \frac{(\phi - \phi_{min})(U_{max} - U_{min})}
{\phi_{max} - \phi_{min}}, \tag{31}
$$

где $U$ — длительность импульса (мкс), $U_{min} = 500$,
$U_{max} = 2500$, $\phi_{min}, \phi_{max}$ — границы
серво-диапазона (градусы). Драйвер PCA9685 (библиотека janelia)
принимает микросекунды напрямую, пересчёт в тики не нужен.
Разрешающая способность тракта: полный ход $2000$ мкс
на $270°$ даёт $2000/270 \approx 7{.}4$ мкс/градус, а 12-битный
ШИМ PCA9685 квантует с шагом $\approx 1{.}1$ мкс — запас
по квантованию примерно семикратный, дискретность незаметна.
Кадр сервоприводов — стандартные $50$ Гц (`setToServoFrequency`).

### 7.5. Захват P7 и сквозной пример

P7 особенный: math-диапазон $7 \dots 38$ — это градусы сервы
($\theta_{off} = 0$; закрыт $7°$, открыт $38°$ — замер владельца),
а проценты `M108`/`G0-J` маппятся: `M108 S=95` — это $95\%$,
math-угол $7 + 0.31 \cdot 95 = 36.45°$. Раствор губок
в миллиметрах определяется дальше рычагами захвата
и требует отдельной калибровки (открытый пункт).

Сквозной числовой пример (P1, $q_{math} = +30$, без коррекции,
без инверсии): сдвиг даёт $\phi = 165°$; clamp $[0, 270]$
пропускает; ШИМ $U = 500 + 165 \cdot 2000/270 = 1722$ мкс.
Зеркальный вариант (P2, те же $+30°$): $\phi = 165°$,
зеркало $(0+270) - 165 = 105°$, ШИМ
$U = 500 + 105 \cdot 2000/270 = 1278$ мкс — то же командное
значение ведёт зеркальную серву в симметричную точку,
что и проверяется M502-тестами направлений на железе.

---

## 8. Валидация: двойник и железо

### 8.1. Метод: предсказание — эксперимент — сравнение

Проверка идёт тройками: модель предсказывает число, железо даёт
число, сравниваем. Предсказывает двойник `tools/twin/` — та же
математика на Python (тот же DLS с теми же константами
$\lambda = 0.3$, $\delta = 10^{-4}$, те же сиды, те же ворота
10 мм / 15°): `fk.py`, `ik.py`/`solve.py`, `detour.py`, свипы.
Честные границы метода: двойник зеркалит **математику**
(кинематику, выбор, ворота), но не механику — люфты редукторов,
провисание звеньев под нагрузкой, динамику сервоприводов
и время он не моделирует. Поэтому совпадение в десятых —
критерий «модель верна», а расхождение в единицах —
сигнал смотреть механику, а не формулы. Метрики сравнения:
$dPos$/$dOri$ факта против предсказания, номер выбранной ветви,
факт отказа против прогноза отказа.

### 8.2. Нулевая поза и воспроизводимость

Якорь всей калибровки — нули: $q = 0$ даёт
$p_{TCP} = (132, 53, 514)$, инструмент +X. Проверено рулеткой
на железе (допуск ±2–3 мм — люфт редукторов и погрешность
замера, не модели). Детерминизм решателя: цель T1 (200, 200, 200)
в разные дни даёт побайтово тот же ответ (0.5/12.2°, ветвь [0],
сустав P4 на ограничении +90°) — в решателе нет случайности,
повторяемость полная.

### 8.3. Endpoint-демо и наклонный круг

Endpoint-демо (12 шагов стоящего TCP с доворотом инструмента):
все шаги в допусках, двойник предсказал каждый. Наклонный круг
r=100 (24 точки, инструмент строго +X): двойник предсказал
проход, железо прошло — но с находкой: на дуге 14–21 ориентация
деградирует 4.1° → 19.3° (трекинг держит ветвь, запястье подходит
к лимитам), три отказа (точки 16/19/20) и два прохода за воротами
(17/18, факт 19.0/19.2° при кандидате ≤15° — см. §3.9).
Вывод задачей: tilt-профиль (свои A/B/C на каждую точку,
подобраны трекинг-моделью). Прогноз модели: 0 отказов, пик 9.4°;
железо: **24/24 OK, пик 0.3°**. Модель даёт верхнюю оценку
(у прошивки полный набор кандидатов против жадного грида
модели), железо лучше — допустимое направление ошибки.
Побочный результат: трекинг-модель двойника (доводка
от предыдущей позы, как прошивка) совпала с железом
до 0.1° на всех 24 точках — валидированный предиктор
поведения (предсказывает не только факт, но и отказы:
5 прогнозных против 3+2 фактических).

### 8.4. Отказы: честные и воспроизводимые

Точка (100, 100, 100)+X: шотган 60 случайных сидов, лучший
2.2 мм / 15.5° без сходимости — недостижима физически
(локоть складывается за лимит ±135° при ориентации +X),
прошивка и двойник отказывают согласованно. Стена
«едет/отказ» для низких близких точек локализована:
(150, 150, 150) проходит (0.6/6.3°), (120, 120, 120)
отказывает (2.2/16.5°) — переход в полосе ~30 мм.
Принцип, подтверждённый всеми отказами: неточного движения
нет как класса — либо в воротах, либо стояние с причиной
в `failReason`, никогда — уход в неверную позу.

### 8.5. Свип 168 точек с препятствиями

Цилиндрическая сетка (12 углов × 5 радиусов × 5 высот)
с двумя ящиками-препятствиями (только рантайм, ребут смывает):
слой z=40 мёртв (2/44 — локоть не складывается на высоте 40 мм),
z=140 пограничный (26/61 — режет в основном ориентация),
z=240 рабочий (36/60). Принятых решений под столом — **ноль**
(уходящие вниз ветви находятся решателем и режутся safety —
проверено перебором выбранных кандидатов, а не слов).
Планировщик объезда сработал вживую: `WPS: 3` с верхней точкой
(35.9, 288.1, 338.2) — перелёт через ящик. Побочный приём,
доказанный на цели W1: та же цель из окрестности ветви [1]
даёт `CHOSEN [1]` 0.1/0.1 вместо 0.2/4.3 через [0] —
предпозиционирование (подход рядом + точный ход) как штатная
техника взятия точной ветви.

### 8.6. Границы применимости и открытые пункты

Модель не покрывает: динамику сервоприводов (считаем мгновенным
исполнением углов), люфты (компенсация M400 задаётся руками —
измерение гироскопом в TODO), провисание под нагрузкой,
точность энкодеров (их нет — open loop, вся точность обязана
сходиться в расчёте, см. §0). Открыто на момент записки:
рулетка дальних точек (физический вердикт DH и пальцу),
статистика T2/T3, направления P5/P6 (картирование джогами
с рулеткой/M114 — протокол: M502-якорь флагов, G28, джог ±15°,
сравнение знака с моделью).

**Методологический итог** (для заключения записки):
система построена на принципе отказа от выполнения
недостоверного движения: четыре независимых ограничения
(§3.7, §4.3, §5.2, §6) гарантируют, что любое движение
либо точно ($\le$ 10 мм / 15°) и безопасно, либо
не выполняется с диагностируемой причиной в M115.

---

## 9. IMU: фьюжн наклона, калибровка, логгер

Датчик BMI160 (гироскоп + акселерометр в одном чипе, та же I2C):
опрашивается задачей Core 1 на 200 Гц голыми регистрами
(сторонние либы под RTOS чудили — unbounded циклы и повторный
`Wire.begin`, выкинуты). Применение: сверка ориентации с FK,
guard соударений, АЧХ/люфты (TODO, пункты в–е).

### 9.0. Кадры и единицы: что измеряем

Датчик живёт в **своей** системе координат $S$ (оси нарисованы
на плате BMI160), робот — в базовой $B$ (+X вперёд, +Y влево,
+Z вверх). Связывает их матрица монтажа $R_{mount}$ (как плата
прикручена к звену). Пока считаем оси совпадающими, честная
калибровка $R_{mount}$ — открытый пункт §9.4: без неё tilt —
это наклон платы, а не звена.

Сырые отсчёты — целые counts: акселерометр int16 (знак по направлению
оси), гироскоп int16 (знак по правилу правого винта вокруг оси).
Перевод в физику — умножением на масштаб из даташита:

- акселерометр: $a[\text{мг}] = counts \times 3.902$ (режим full-res
  при range 16g; без full-res было бы 10 бит и 31.2 мг/LSB —
  ловушка, в которую чуть не попались: масштаб проверен
  железом, $a_z = 256 \Rightarrow 0.999g$);
- гироскоп: $\omega[\text{mdps}] = counts \times 8.75$ (range 250 dps).

### 9.1. Комплементарный фьюжн

Задача: угол наклона без дрейфа. Гироскоп даёт угловую скорость:
угол — её интеграл, а интеграл копирует ошибку нуля (дрейф).
Акселерометр даёт абсолют (проекция гравитации $g$ на оси),
но только в покое — в движении к гравитации примешивается
ускорение руки. Решение — взаимодополняющие фильтры:
Гироскоп ведёт в короткую (интегрирование), акселерометр тянет
к абсолюту в долгую (поправка). Наклон по акселерометру —
из геометрии проекции: крен — арктангенс боковой
составляющей на вертикальную, тангаж — продольной
на модуль горизонтальной проекции:

$$
roll_{acc} = \operatorname{atan2}(a_y, a_z), \qquad
pitch_{acc} = \operatorname{atan2}(-a_x, \sqrt{a_y^2 + a_z^2}).
\tag{33}
$$

где $a_x, a_y, a_z$ — ускорение в милли-g (знаки: ось смотрит
вверх — плюс; минус у $a_x$ — чтобы нос вниз давал плюс
тангажа, как принято). Слияние с проинтегрированным гироскопом:

$$
tilt = \alpha \cdot (tilt + \omega \cdot dt) + (1 - \alpha) \cdot tilt_{acc},
\tag{32}
$$

где $tilt$ — оценка наклона (град, хранится между тиками),
$\omega$ — угловая скорость гироскопа за вычетом bias (град/с),
$tilt_{acc}$ — наклон по акселерометру (35) (град),
$dt = 0.005$ с (тик 200 Гц), $\alpha = 0.99$.
Вес связан с постоянной времени $\tau = \alpha \cdot dt / (1-\alpha)
\approx 0.5$ с: возмущения быстрее полусекунды отрабатывает
гироскоп, медленнее — подтягивает акселерометр. Зачем вообще акселерометр:
без него ошибка нуля $b$ интегрируется в уход

$$
e(t) = b \cdot t,
\tag{34}
$$

где $e$ — накопленная ошибка угла, $b$ — bias (типично 0.15 dps:
за минуту стояния убежит на 9° — поэтому фьюжн обязателен,
а не опционален). Замена на EKF — внутри одной функции
`imuFuse()`, остальное (кольцо, M119, guard) не заметит.

### 9.2. Калибровка нуля гироскопа

Нуль плывёт с температурой — калибруемся каждый boot,
в RAM (не в EEPROM). Рука стоит в home (поза не важна:
гироскоп меряет угловую скорость, в покое она нуль
в любой позе), отстойка механики 1.5 с, дальше среднее:

$$
bias = \frac{1}{N}\sum_{k=21}^{N+20} g_k, \qquad N = 400,
\tag{35}
$$

где $g_k$ — сырые counts гироскопа, первые 20 сэмплов мимо
(переходный после включения). Замеренные bias живого экземпляра:
−0.04…−0.26 dps (стабильны от boot к boot); единицы dps —
признак того, что руку тронули во время `CALIB`. Почему не храним
в EEPROM: нуль плывёт с температурой (десятки mdps на градус
у MEMS), вчерашний bias сегодня врёт — калибруемся каждый раз.

### 9.3. Кольцо последнего движения

Пока интерполятор в движении (`isMoving`), каждый тик пишется
сэмпл; сброс — только при паузе между движениями > 1 с
(вейпоинты одного G0 идут вплотную и запись не рвут);
первый сэмпл метится стартом, хопы вейпоинтов — флагом.
Объём при 200 Гц (замерено ~166 Гц из-за contention с сервами):

$$
1024 \times 18\,\text{Б} \approx 18\,\text{КБ} \approx 5\,\text{с записи},
\tag{36}
$$

где сэмпл — `millis` + 6×int16 counts + флаги (f=1 старт,
f=2 вейпоинт). Раскладка сэмпла (18 байт, порядок как в дампе):

| Поле | Тип | Что означает |
|---|---|---|
| `t` | uint32 | `millis()` взятия (единая шкала с прошивкой — синхронизация с траекторией бесплатна) |
| `ax ay az` | int16 ×3 | акселерометр, counts (знак по оси) |
| `gx gy gz` | int16 ×3 | гироскоп, counts, bias НЕ вычтен (вычитает хост по `#BIAS`) |
| `f` | uint16 | 0 = обычный, 1 = первый сэмпл записи, 2 = хоп вейпоинта внутри одного G0 |

В кольце сырые counts; перевод в единицы —
на хосте по `#SCALE`-строке дампа (акселерометр 3.902 мг/LSB —
full-res 16g, без него было бы 31 мг; гироскоп 8.75 mdps/LSB).
Пики за движение считаются на лету (для будущего guard'а):
максимум модуля ускорения (в g) и максимум джерка —
скорости изменения ускорения:

$$
jerk = \frac{|a_t - a_{t-1}|}{\Delta t},
\tag{37}
$$

где $a$ — вектор ускорения (g), $\Delta t = 0.005$ с.
Замерено: покой — 1.03g / 7.4 g/s (пол: гравитация + шум);
взмах рукой — 3.35g / 468 g/s. Отсюда сразу видно, почему
черновой порог удара 2.5g неприменим (ручной взмах его
пробивает): порог калибруется по реальным ходам руки,
а не по рукам. Выдача: `M119` (живые + пики + счётчики шины)
и `M119 S=1 [D=n]` (дамп `#IMU` + `OK`; децимация D —
каждый N-й; полный дамп ~60 КБ: ~0.6 с на 921600,
~5 с на 115200 — поэтому бодрейт и поднимали).
Шина общая с сервами: все транзакции под `i2cMutex`,
только bounded ожидания (никаких `portMAX_DELAY` на шине),
счётчики fails/recovers и самовосстановление
(`Wire.end/begin` + переинит регистров).

### 9.4. Калибровка монтажа (открытый пункт)

Всё выше — в кадре платы $S$. Чтобы tilt стал углом звена,
нужна матрица монтажа $R_{mount}$ (как плата прикручена).
Калибровка — по известным позам: ставим руку в 2–3 точные
позиции (нули + наклоны), читаем tilt платы и ориентацию
звена из FK, решаем $R_{mount}$ ортогональным Прокрустом
(минимум $\|R_{mount} R_{FK} - R_{IMU}\|_F$). Пока не сделано:
tilt из `M119` — это наклон платы; на фланец переносится
вручную. Сюда же ляжет 9-DOF yaw по магнитометру, когда
до него дойдёт очередь.
