SpellcasterMom/test/docs/FLOW.md

# Как работает прошивка 6DOF — блок-схемы

Рамка: `+X` вперёд, `+Y` влево, `+Z` вверх. Стол = XY (`z=0`).
Порог годности IK: **10 мм / 15°**. Палец захвата 105 мм.

## 1. Тракт команды G0 (декарт)

```mermaid
flowchart TD
    S["Serial: G0 X.. Y.. Z.. A.. B.. C.. J.. F.."] --> P["GCodeParser<br/>params + флаги hasPosition/hasGripper"]
    P --> D["Диспетчер COMMANDS[]<br/>имя → handler"]
    D --> H["handleG0 / handleG1"]
    H --> ARC["Подъём-дуга: отрезок старт→цель<br/>+ синус-горб h=120, n=24"]
    ARC --> SOL["solve_all на каждом сэмпле<br/>2 гео-сида + нули → refine DLS"]
    SOL --> TH{"dPos ≤ 10 мм<br/>и dOri ≤ 15°?"}
    TH -- "нет" --> FAIL["ERROR: No accurate safe IK<br/>best dPos/dOri в M115"]
    TH -- "да" --> SF["SafetyChecker<br/>короб, zMin звеньев, бокс колонны"]
    SF -- "нарушение" --> FAIL
    SF -- "чисто" --> DET["DetourPlanner<br/>плохие сэмплы → WPS nwp"]
    DET --> MOV["Interpolator.moveToDetour<br/>lerp + slerp, IK на каждом шаге"]
    MOV --> SRV["ServoController.setAngle<br/>math → ШИМ → PCA9685"]
    SRV --> OK["OK + M115: INTERP DET nwp/minZ/WPS"]

    H -. "M104 P7=.." .-> DIR["moveTo напрямую<br/>без IK"]
    DIR --> SRV
    H -. "M108 S=.." .-> GR["Сустав 6 = S%<br/>через interpolator"]
    GR --> SRV
```

Параллельно крутится задача дисплея: TCP XYZ + Roll/Pitch/Yaw, ABS над PCA,
последняя команда в статус-баре. Диагностика — всегда `M115`.

## 2. Ядро IK: solve_all + refine

```mermaid
flowchart TD
    T["Цель: TCP + Эйлер A/B/C"] --> W["Точка запястья<br/>TCP − toolDir × 105"]
    W --> SEED["Сиды: локоть вниз / локоть вверх<br/>+ нули (верхняя полусфера)"]
    SEED --> GEO["Геометрия плеча: q1,q2,q3<br/>по треугольнику 165/161"]
    GEO --> WR["Ориентация: q4,q5,q6<br/>R36 = R03ᵀ × R06 → разложение"]
    WR --> DLS["refine: DLS-итерации<br/>clamp ±135°"]
    DLS --> FK["FK-проверка: dPos + ось-ошибка"]
    FK --> SORT["Сортировка по min-residual<br/>+ штраф за дальность от текущей позы"]
    SORT --> BEST["Лучшее решение → порог 10/15"]
```

## 3. Отказ — это штатно

Неточного решения НЕТ в прошивке специально: лучше честный
`ERROR` + цифры в M115, чем прыжок в мусор. Частые причины:

- точка слишком близко к телу (локоть складывается за ±135°);
- середина дуги проходит через бокс колонны `[-65,65]²×[0,180]`;
- ориентация по умолчанию `+X (90,0,90)` не вытягивается — задать A/B/C явно.

## 4. Блендинг G1 (флаг Q1, без останова на стыке)

Одиночный `G1` тормозит в конце (`easeInOut` → 0). Для непрерывного
движения (круг из 24 точек) все точки кроме последней шлются с `Q1`:
отрезок не тормозит в конце, следующий стартует с ходу (трапеция
с косинусными рампами 15%, стык C1-непрерывен по скорости).

Правила:

- `G1 ... Q1` = «в конце не останавливаться»; без Q — стоп как раньше.
- Первый отрезок цепочки — только из близкой позы: декартов трекинг
  не стартует через reconfig >45°/шаг (сложенный парк в 70–200° от
  любого сида — `ik-lost` на первом шаге). Вход — joint-путём
  (`G28 H1` → `G28`, штатный путь каждого boot), дальше декарт.
- Стартовый `solveAll` + диагностика сидов пропускаются только внутри
  цепочки (прошлый `G1(Q1)` доехал). Первый отрезок валидируется полностью.
- Оценка времени отрезка в цепочке — урезанным бюджетом (5 ит., только
  для темпа): полная оценка стоит ~0.2с счёта с удержанной позой и
  убивала бы блендинг. На точность не влияет — движет трекинг (25 ит.).
- Честность та же: safety каждого шага, срыв трекинга >45°, а ворота
  10мм/15° проверяются пост-гейтом после отрезка (`ERROR: chain residual
  too big` + разрыв цепочки). `M112`, `moveTo` (G0/M104/G28/jog) и любой
  отказ цепочку рвут — следующий G1 снова со всеми проверками.
- В метке `CART` (M115) видно `chain` + факт темпа `maxStep/avgStep` мс.
- `M115`-диагностика по точкам с блендингом несовместима (нужна
  устоявшаяся поза): `demo_circle.py` в `log`-режиме Q1 не ставит.

## 5. Поток M450 (планирование отдельно, исполнение отдельно)

Одиночные `G1` останавливаются на стыках (ease + предвычисление каждой
точки прямо перед движением). Поток убирает остановки полностью:
планировщик (core0Task) считает IK заранее в кольцо на 180 точек,
исполнитель (своя задача, Core1) дренирует его строгим кадансом 20мс.

- `M450 S1` — открыть: следующие `G1` (только IK) копятся без движения.
  `OK` = «принято и провалидировано» (те же solveAll + ворота 10/15 +
  safety; непрерывность считается от прошлой спланированной точки).
  Кольцо полное — `OK` придерживается до слота (снифф `M112`, колпак
  60с): хост тем же ожиданием сам тормозится. Чанки прошивке не нужны —
  шлите весь маршрут одним потоком.
- `M450 S0` — барьер: докачать, исполнить всё без остановок, встать.
  Блокирует до конца дрена (со сниффом `M112`).
- `M450 S2` — сбросить без движения (идемпотентно).
- Голод исполнителя — hold-and-resume (поза держится сама ШИМом,
  счётчик `starved` + `holdsMs` в M115, разгон по докачке).
- Отказ точки = `ERROR` + сброс потока; `G0/M104/G28/M108` и jog при
  открытом/исполняемом потоке запрещены (`ERROR`); `M112` — стоп +
  сброс всегда. Без потока G1 едет как раньше (стоп-профиль).
- Ядра: исполнитель + IMU на Core1 (приор. 2/2, кооперативно: оба
  висят на delay — вытеснений нет); всё остальное (парсер, дисплей,
  пульт) — Core0. I2C один, мьютекс как был. E-STOP — через прерывание,
  от ядер не зависит.
- В рантайме IK-доводки нет осознанно: replay joint-поз детерминирован,
  перемерять нечего; safety каждой точки оставлена (дешёвая, каданс цел).
  Ворота 10/15 — на планировании каждой точки.
- M115: `STREAM: state/depth/maxDepth/starved/holdsMs/maxStep` +
  таблица авто-чанков `CHUNKS: n worst done/active/dropped` (чанк = 60
  точек, для учёта; границы на движение не влияют).
- Гироскоп пишется весь поток целиком: IMU-логгер пишет пока
  `isMoving()` (исполнитель держит флаг весь дрен, включая holds),
   кольцо 4096 сэмплов ≈ 20 с — длинные потоки влезают полностью; разбор связки
  «движение-гиро» — `M119 S=1` после потока.
- Метки в кольце (`f=`): бит0 старт записи, бит1 вейпоинт потока
   (каждый поп исполнителя), бит2 вход в hold, бит3 вычисленная
   декартова траектория (нет — заданные суставы). Потоки длиннее ~20 с держат
   лишь хвост — полная длина только живым режимом `M119 S=2`
  (тот же формат строкой сразу, только при движении; тоггл/`M112`).
