SpellcasterMom/test/prompts/presentation_gamma.md

# Промт: презентация дипломного проекта CLAW в Gamma

> Как пользоваться (пайплайн, не пропускать шаги):
>
> 1. Скопируйте блок «ТЕКСТ ДЛЯ GAMMA» ниже в Gamma (Create with AI → Paste text).
> 2. Сгенерируйте колоду на 12–14 слайдов, русский язык.
> 3. Экспортируйте в PPTX.
> 4. Примените официальный шаблон СевГУ (ссылка в блоке 1) как тему оформления.
> 5. Пройдите чеклист ручной доводки (блок 5) — без него на защиту нельзя.
>
> Важно: формулы Gamma рисует плохо — их в слайды не тащим.
> Математика живёт в раздаточном `docs/MATH.docx` и на постере,
> на слайдах только итоги цифрами.

---

## Блок 1. Бренд СевГУ (откуда брать, не выдумывать)

- Официальный шаблон презентации (PPTX):
  `https://www.sevsu.ru/upload/iblock/68d/z7jmp0dq0k8xekmfxg298bmri3a4q44c/shablon_present_sevsu.pptx`
- Логотип (SVG):
  `https://www.sevsu.ru/local/templates/sevgu/static/img/content/logo-footer.svg`
- Цвета, шрифты, плашки, отступы — извлечь строго из официального
  шаблона выше (в открытом машиночитаемом виде брендбука нет —
  ничего от себя не придумывать).
- Обязательно: титульный слайд и финальный слайд — с символикой
  университета (логотип + полное название:
  «Севастопольский государственный университет»).
- Автор: Лайков Владимир В., группа УТС/б-23-1-о,
  руководитель: Липко И.Ю. Проект: CLAW.

## Блок 2. Фактура проекта (нейронке — только эти факты, без галлюцинаций)

- Объект: настольный 6-осевой манипулятор CLAW (дипломный проект).
- Железо: ESP32 (2 ядра), сервы 7 шт через PCA9685
  (P1–P3: 270°, ±135°; P4–P6: 180°, ±90°; P7 захват 7–38°),
  IMU BMI160 (гироскоп + акселерометр), дисплей ST7789, пульт-джоггер.
- Кинематика: таблица Денавита–Хартенберга (звенья 134/165/161/0/53+54/27 мм,
  палец захвата 105 мм, запястье НЕ сферическое); нули дают TCP (132, 53, 514).
- Обратная кинематика: геометрические сиды + доводка Левенберга–Марквардта
  по полной цепочке; выбор min-residual со штрафами (непрерывность + высота).
- Ворота годности: 10 мм / 15°. Хуже — честный отказ с причиной, а не движение в мусор.
- Планировщик объезда запретных зон (via-точки + RRT), телеметрия IMU (M119).
- Валидация двойником (Python-зеркало прошивки), цифры:
  точка T1 (200,200,200) — 0.5 мм / 12.2°;
  наклонный круг r=100 — 24/24 без отказов, пик 0.3°;
  свип 168 точек с препятствиями — принято 67, решений под столом ноль;
  недоступные точки отбиваются честно (пример: 2.2 мм / 16.5° — отказ).

## Блок 3. ТЕКСТ ДЛЯ GAMMA (копировать целиком)

```text
Сделай презентацию дипломного проекта на русском языке, 12–14 слайдов,
технический стиль вуза, без клипарта и стоковых картинок роботов.
Тема: 6-осевой настольный манипулятор CLAW (контроллер на ESP32).

Структура (держи точно, к каждому слайду 2–4 тезиса + заметки докладчику):
1. Титул: название, автор Лайков В.В., группа УТС/б-23-1-о,
   руководитель Липко И.Ю., Севастопольский государственный университет.
2. Цель работы: рабочий манипулятор + честная математика вместо магии.
3. Железо: ESP32, 7 серв через PCA9685, IMU BMI160, дисплей, пульт.
4. Прямая кинематика: цепочка Денавита–Хартенберга, нули (132, 53, 514).
5. Обратная кинематика: сиды + Левенберг–Марквардт, min-residual со штрафами.
6. Ворота 10 мм / 15°: хуже — отказ с причиной, а не движение в мусор.
7. Планировщик объезда запретных зон.
8. Дисплей, команды, телеметрия IMU.
9. Двойник на Python: зеркало прошивки для офлайн-проверок.
10. Эксперименты (таблица): T1 0.5/12.2, круг 24/24 пик 0.3°,
    свип 168 точек, честные отказы.
11. Выводы: что работает, что измерено, что дальше (самоколлизии, BMI160).
12. Спасибо за внимание. Вопросы.

Хронометраж всей защиты ~8 минут (≈40 секунд на слайд + запас).
```

## Блок 4. Требования к стилю (дописать в Gamma при генерации, если умеет)

- Строго русский язык, термины как в блоке 2 (TCP, DLS, RRT, ворота — без перевода).
- Каждый слайд с цифрами: только цифры из блока 2, ничего округлённого «на глаз».
- Никаких выдуманных графиков/процентов/«улучшений в N раз».
- Место под 4 вставки пометить плейсхолдерами: [ЧЕРТЁЖ], [ФОТО РУКИ],
  [КУСОК M115], [БЛОК-СХЕМА].

## Блок 5. Чеклист ручной доводки (обязательно после экспорта в PPTX)

- [ ] Применена тема из официального `shablon_present_sevsu.pptx`.
- [ ] Вставлен чертёж `docs/robot1.jpg` (слайд FK).
- [ ] Вставлено фото руки (слайд железо).
- [ ] Вставлен кусок реального M115 (слайд эксперименты).
- [ ] Вставлена блок-схема тракта G0 (слайд планировщик/IK).
- [ ] Каждая цифра сверена с репозиторием (M115-логи, MATH.md).
- [ ] Шрифты/поля/нумерация — по требованиям нормоконтроля.
- [ ] Прогон вслух ≤ 8 минут.
