SpellcasterMom/test/cad/dex_down.stl

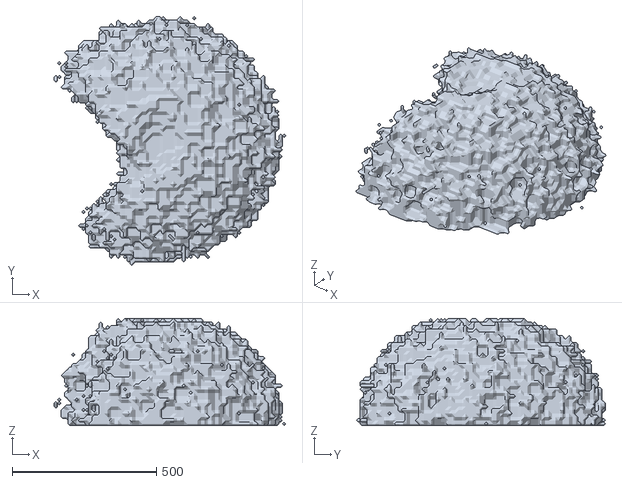
[picture p3: CAD file, 2026-10-02]
cad/dex_down.stl
804.0 x 864.0 x 372.0
