SpellcasterMom/test/cad/Models/robot-base.stp

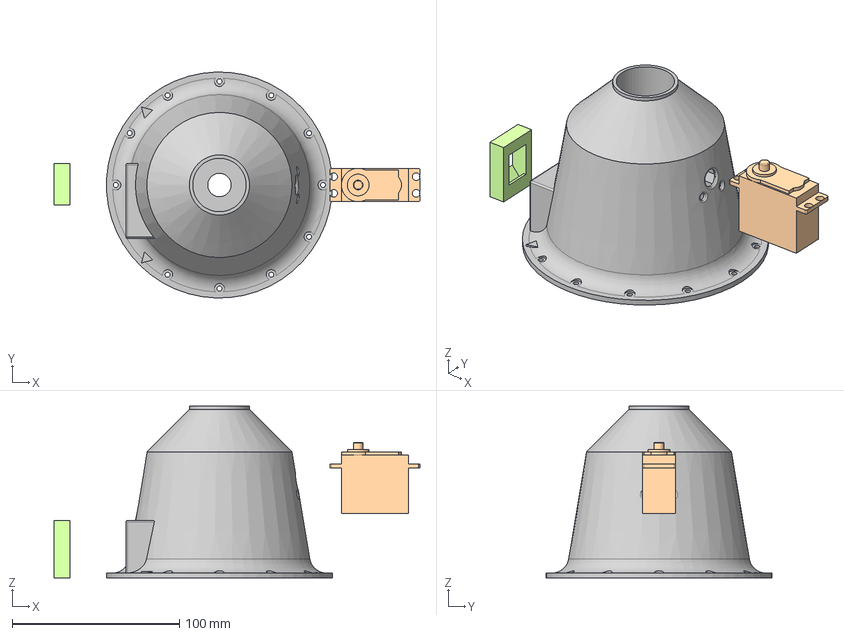
[picture p4: CAD file, 2026-10-07]
cad/Models/robot-base.stp
219.0 x 135.2 x 102.9 mm
Keystone Slot
