SpellcasterMom/test/cad/dex_x.stl

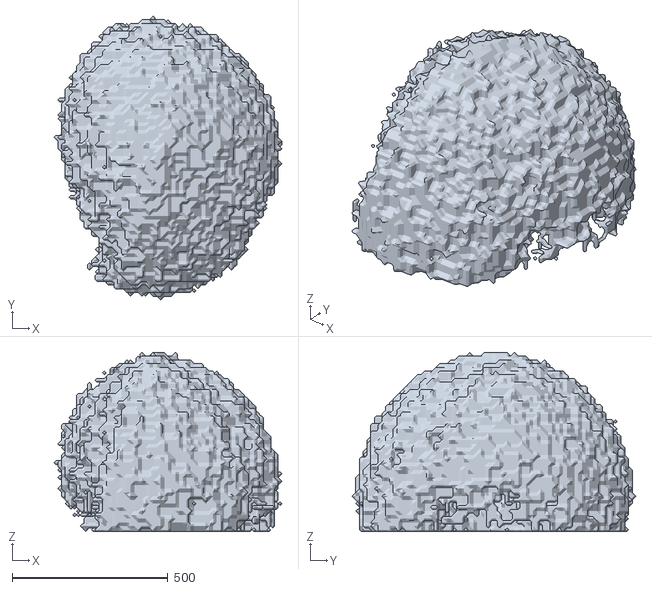
[picture p5: CAD file, 2026-10-02]
cad/dex_x.stl
732.0 x 912.0 x 576.0
