SpellcasterMom/test/cad/Models/drivebig.stp

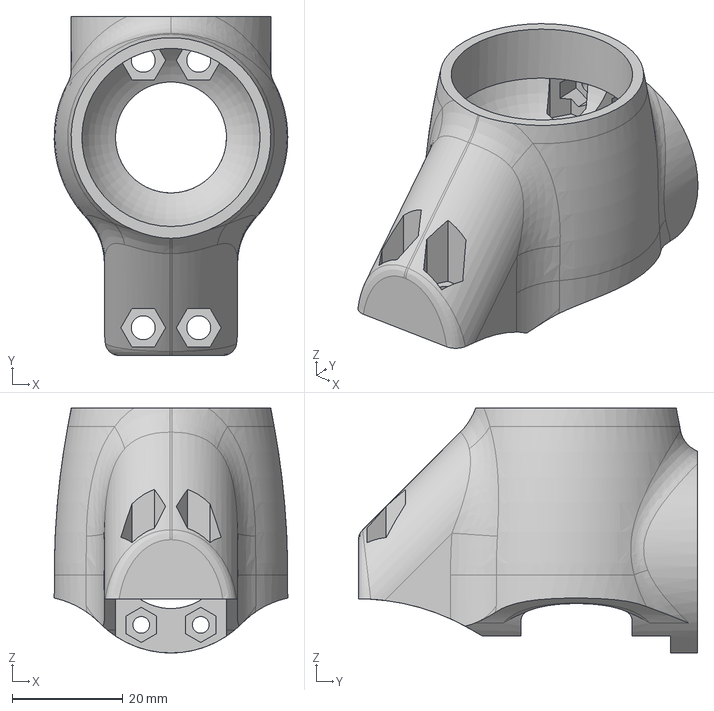
[picture p6: CAD file, 2026-10-07]
cad/Models/drivebig.stp
42.1 x 61.1 x 44.1 mm
