SpellcasterMom/test/cad/base_column.stl

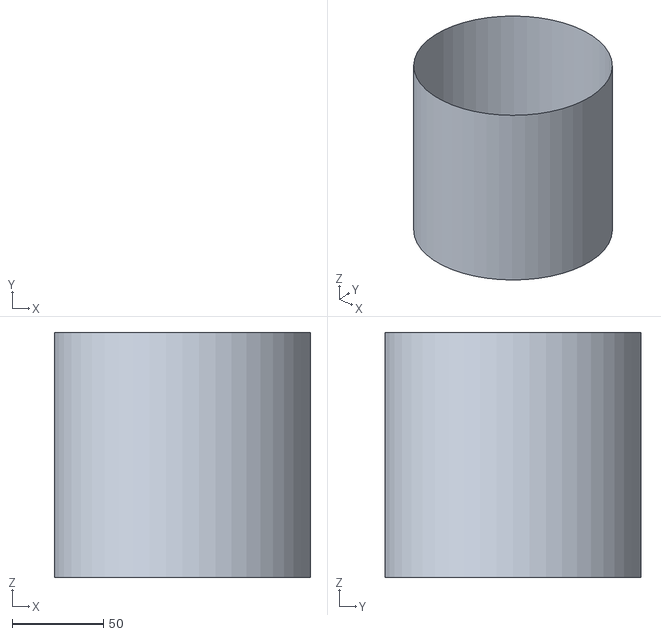
[picture p7: CAD file, 2026-10-02]
cad/base_column.stl
140.0 x 140.0 x 134.0
