SpellcasterMom/test/cad/Models/drivebig_rotor.stp

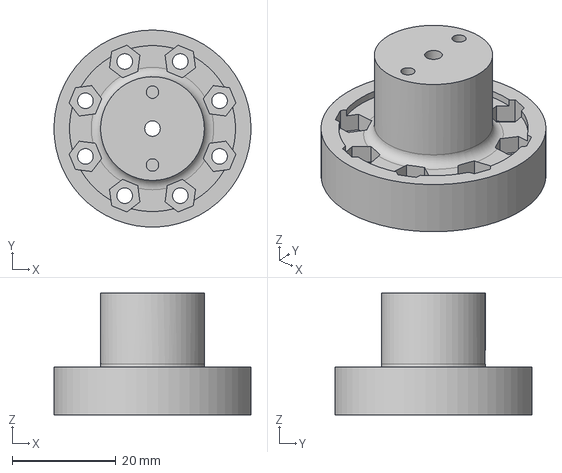
[picture p8: CAD file, 2026-10-07]
cad/Models/drivebig_rotor.stp
38.0 x 38.0 x 23.5 mm
