SpellcasterMom/test/cad/Models/drivesmall.stp

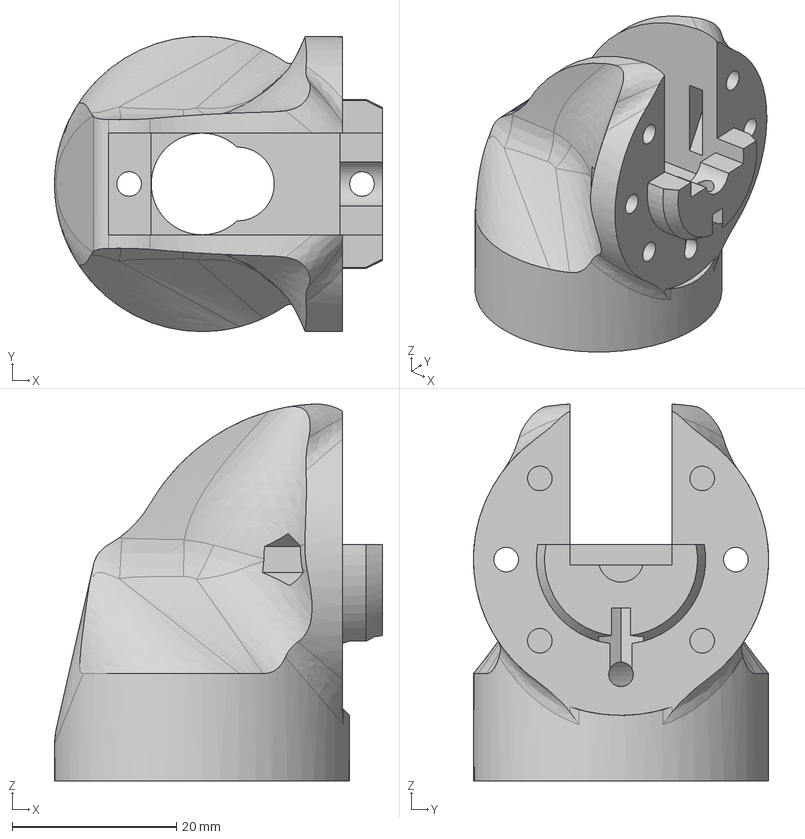
[picture p9: CAD file, 2026-10-07]
cad/Models/drivesmall.stp
40.0 x 36.0 x 46.0 mm
