SpellcasterMom/test/cad/reach.stl

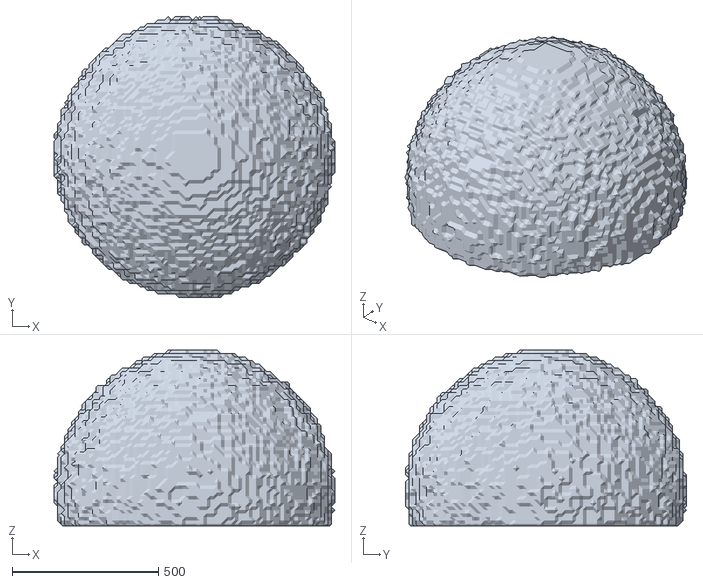
[picture p10: CAD file, 2026-10-02]
cad/reach.stl
960.0 x 960.0 x 600.0
