SpellcasterMom/test/cad/Models/drivesmall_rotor.stp

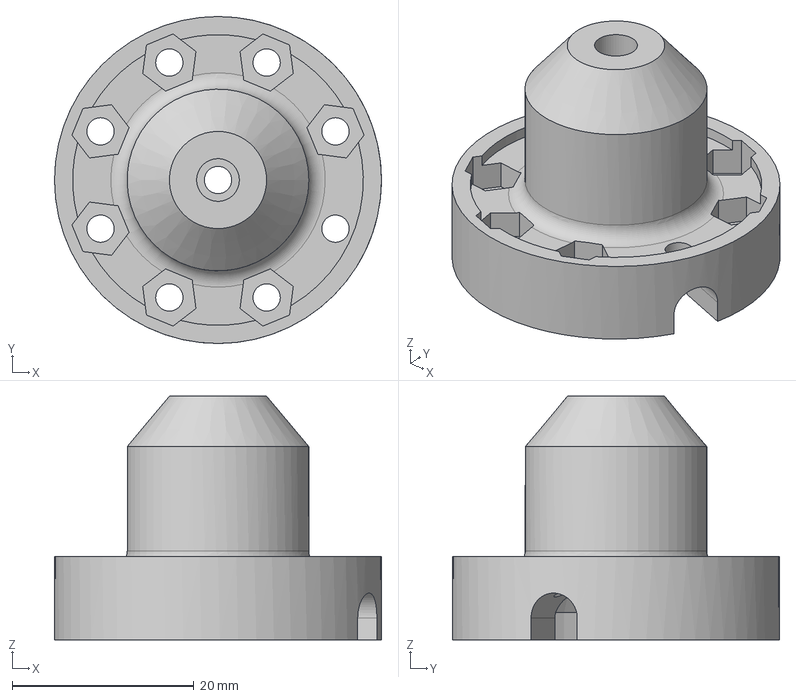
[picture p11: CAD file, 2026-10-07]
cad/Models/drivesmall_rotor.stp
36.0 x 36.0 x 26.8 mm
