SpellcasterMom/test/cad/Models/connector_straight_shift.stp

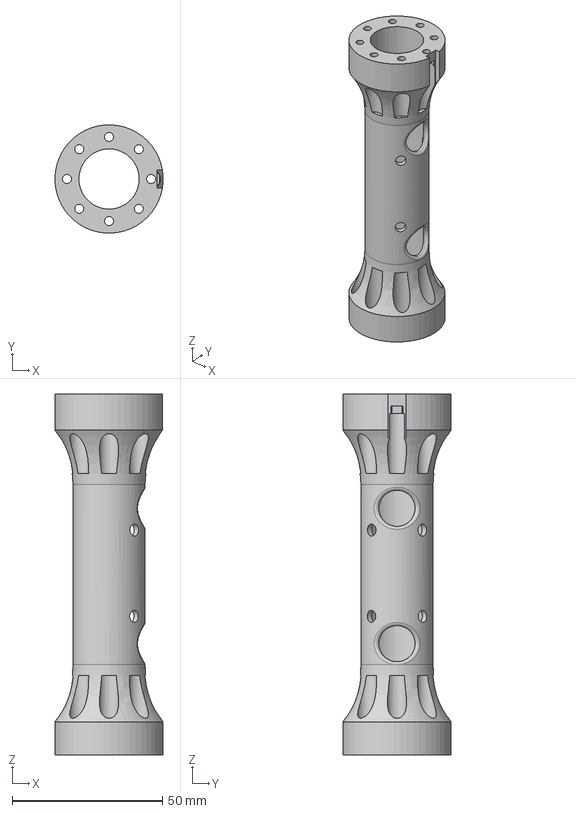
[picture p12: CAD file, 2026-10-07]
cad/Models/connector_straight_shift.stp
36.0 x 36.0 x 120.0 mm
