SpellcasterMom/test/cad/Models/connector_corner.stp

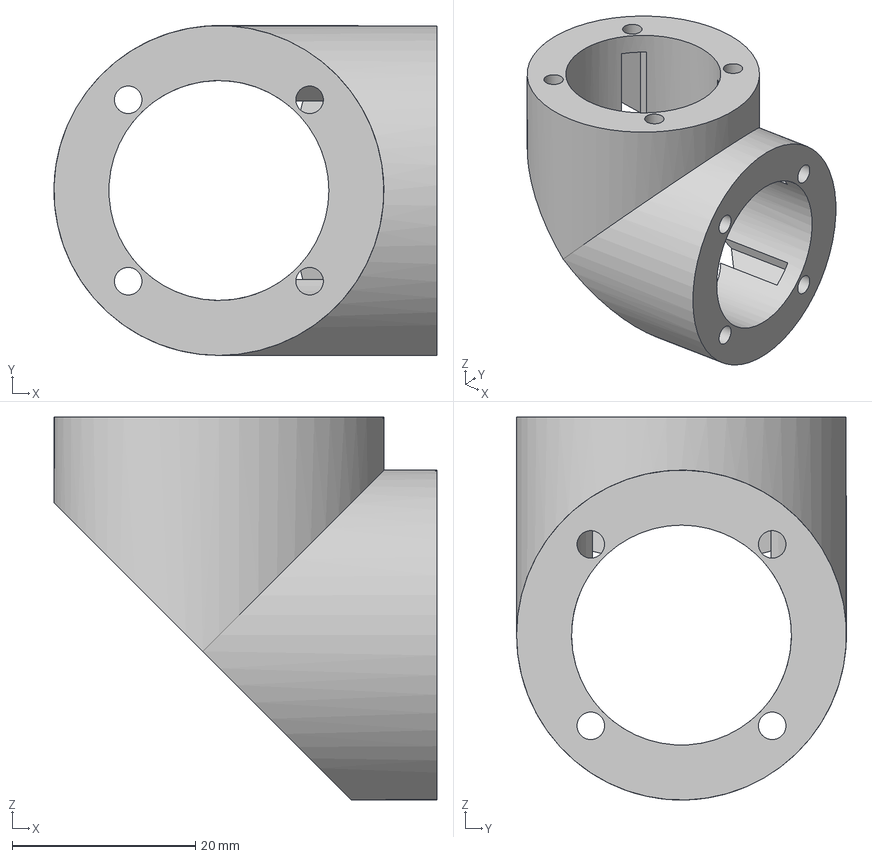
[picture p13: CAD file, 2026-10-07]
cad/Models/connector_corner.stp
41.8 x 36.0 x 41.8 mm
