SpellcasterMom/test/cad/Models/connector_straight.stp

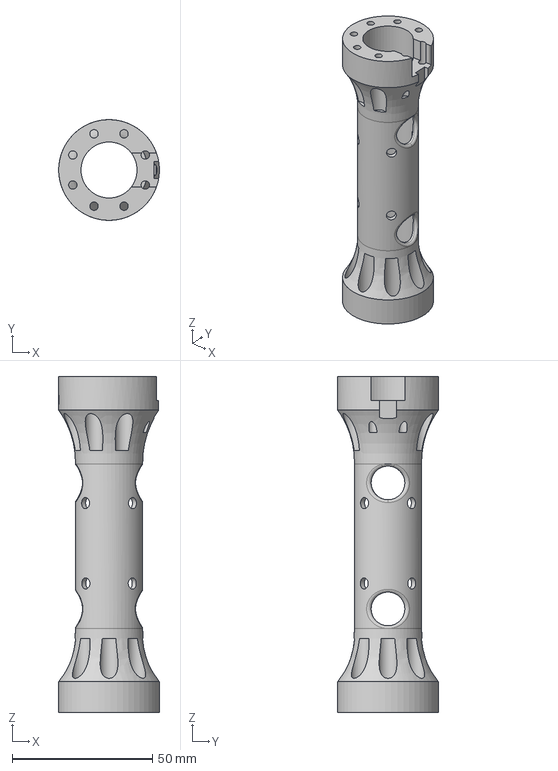
[picture p14: CAD file, 2026-10-07]
cad/Models/connector_straight.stp
36.0 x 36.0 x 120.0 mm
