SpellcasterMom/test/cad/Models/base_rotor.stp

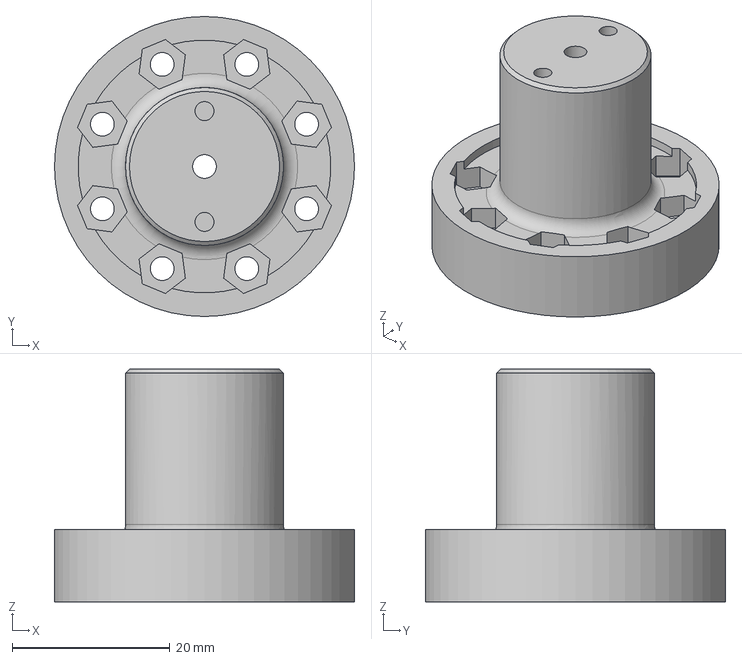
[picture p15: CAD file, 2026-10-07]
cad/Models/base_rotor.stp
38.0 x 38.0 x 29.5 mm
