SpellcasterMom/test/(list of files, cad)

Other CAD files:
cad/Models/base_rotor.stl
cad/Models/connector_corner.stl
cad/Models/connector_straight.stl
cad/Models/connector_straight_shift.stl
cad/Models/drivebig.stl
cad/Models/drivebig_rotor.stl
cad/Models/drivesmall.stl
cad/Models/drivesmall_rotor.stl
cad/Models/robot-base.stl
