SpellcasterMom/test/TODO.md

# TODO / история проекта (хронология)

## Кинематика и модель
- M115 KIN-DIAG (цель/кандидаты/факт/расхождение), M417, G28
  и boot-синхронизация интерполятора, вертикальный ноль
  плеча (thetaOff J2=+90).
- DLS-доводка IK (знак −Jᵀy, line search, active-set),
  min-residual, лимиты 30°/с P1–P3.
- Двойник `tools/twin/` (FK/DLS/`solve()` 1:1):
  фит DH отброшен (вырождение), DH выведена
  руками из robot1.
- DH-v2: J6 = roll инструмента (железо: P6 крутит
  захват на месте), палец 105 = захват. Нули FK точные.
- Сиды с компенсацией запястья + нули + от текущей позы;
  continuity-биас и высотный штраф в выборе; порог 10/15.

## Движение и safety
- M104 через интерполятор; зажим целей в лимиты в `moveTo`;
  все движения (G0/M104/G28) через интерполятор.
- Декартов G1 (`moveToPose`): lerp + slerp, IK на шаге,
  трекинг,   safety каждого шага; ядро DLS матричное
  (`refineSolutionM`).
- Рабочий G91 + поосевое удержание; отказ при плохой
  расхождении вместо прыжка в мусор.
- Safety-короб под истинные габариты; zMin 10; конструктив
  колонны −65..65/0..180 по умолчанию (EEPROM, проверка
  на старте); дефолтная ориентация +X.
- Home = все нули; FW-версия в EEPROM + авто-миграция.

## Железо и библиотеки
- Дисплей ST7789 → LovyanGFX (DMA, поворот, инверсия);
  статус-бар (ABS/REL, команда), анти-мерцание; TFT_eSPI
  parked (не завёлся текст).
- Сервы PCA9685: Adafruit → janelia-arduino (микросекунды);
  слепок старого в `servo-adafruit-old`. P1–P3 45°/с.
- Ручной пульт: штурвал + NEXT (P1–P7) + E-STOP
  (отдельный пин, всегда вооружён).

## Документация и порядок
- README: справочник команд, распиновка, M115-легенда,
  приёмка, FAQ, ветки; DH-таблица; «расхождение» вместо
  «расхождения»; строки ≤60.
- `KINEMATICS.md` (ветка `ref-kinematics-math`), чертёж
  `docs/robot1.jpg`, `cad/` (STEP-каталог, reach/dex STL,
  колонна базы), двойник в `tools/`.
- Дисциплина: работа в ветках, в `master` только принятое
  на железе; `kinematics-freeze-v1` — эталон расчёта.

## Открыто
- Рулетка нулей и дальних точек (физ. вердикт DH/пальцу).
- T2/T3 статистика; край (340,−80,120) — вне декстерусности.
- Направления P5/P6 ±10° против прогноза (флаги инверсии).
- Замер диаметра колонны базы (сейчас оценка R=70).
- ТЕХДОЛГ самоколлизии: проверяются только стол/короб/зоны,
  звено-звено и звеносерва (напр. запястье в серву P2) не
  контролируются. Вход: сферы с размерами на чертеже robot1,
  затем габариты из CAD. План: капсулы звеньев + сферы серв,
  `checkSelfCollision(q)` в `checkAllLinks()`, M-код радиусов
  с EEPROM-persist, зеркало в двойнике; реакция — объезд через
   планировщик, отказ только если обхода нет.
- ТЕХДОЛГ IMU (модуль BMI160; TODO(bmi160): ниже — факты сняты с GY-80,
  сверить с даташитом BMI160 по ходу драйвера. Было: гиро L3G4200D 0x69,
  аксель ADXL345 0x53, магнит HMC5883L 0x1E, баро BMP180 0x77 —
  конфликтов с PCA9685 0x40 нет; шина GPIO21/22 общая): (а) IMU на фланце — сверка ориентации
  с FK (`src/imu_sensor.*`, комплементарный фильтр, калибровка
  монтажа в EEPROM, M119-телеметрия, расхождение в M115);
  (б) IMU-guard соударений — триггер удара (|a|>~2.5g, 30мс)
  + триггер упора (moving, а jerk~0, таймаут ~1с), blanking
  старт/стоп 100мс, реакция по тракту M112, обучение порога
  по пикам демо, arm/disarm M-кодом; лёгкие касания физикой
  не ловятся (нет токов моторов). Было бонусом GY-80 (нет в BMI160):
  магнитометр HMC5883L даёт абсолютный yaw — возможен полный 9-DOF фьюжн
   без дрейфа гироскопа; баро BMP180 для руки бесполезен.
  (в) IMU-логгер последнего движения для хоста: кольцевой буфер
  1024×16Б=16КБ статически (millis uint32 + 6×int16), запись
  старт/стоп движения, `M119` — живые+пики, `M119 DUMP [D=n]` —
  строки `#IMU t=.. ax=.. ay=.. az=.. gx=.. gy=.. gz=..` + `OK`;
  опрос IMU + фильтр на Core 1, реакция guard через sharedState
  в цикл шага Core 0 (~20–50мс удар→стоп), I2C под мьютексом
  (Wire общий с PCA9685); формат пакетов — текст.
  (г) Поднять Serial 115200→921600 (×8, CP2102/CH340 тянут):
  `SERIAL_BAUD` в config.h + main.cpp:1605 и :35, platformio.ini
  monitor_speed, tools/demo.py|demo_endpoint.py|demo_circle.py
  (BAUD константы); дамп 1024 → ~0.6с; мусор boot-ROM при ребуте —
   косметика; делать синхронно с обеих сторон.
   (г1) Проводка BMI160 (факт 05.10 снят с GY-80: 50см + подтяжки 11к = клин шины,
  без модуля всё летает): шлейф SDA/SCL/GND/3V3 ≤20см (как у PCA),
  подтяжки 4.7к на 3V3, после этого вернуть I2C 400 кГц (сейчас 100 кГц
  костылём в servo init + recoverBus).
  (д) Резонансы — ПОСЛЕ полной сборки руки (пока не собрана):
  tap-тест (щелчок по звену → собственная частота + затухание),
  sweep подач с FFT на хосте → АЧХ «скорость → вибрация»
  (данные — из логгера (в)); подавление: input shaping ZV/ZVD
  в интерполяторе, таблица запретных подач, S-кривая вместо
  квадратичного ease-in-out (у него излом ускорения в t=0.5).
  Без измеренных частот не давить.
  (е) Замер люфтов гироскопом: сустав туда-обратно малым шагом
  (M104, медленно), потеря движения на реверсе по гиро/фьюжну =
  люфт сустава; сверить с ручными M400 и подставить измеренные.
  Метод: двигать только один сустав, читать проекцию гиро на его ось.
