SpellcasterMom/test/src/config.h

/**
 * Project     : 6DOF arm
 * Codename    : CLAW
 * Author      : Vladimir V. Laykov aka Yago
 * Alma Mater  : Sevastopol State University
 * Group       : УТС/б-23-1-о
 * Mentor      : Lipko I.Y.
 * Date        : 2026-09-18
 * Last modify : 2026-10-07
 */

/**
 * @file config.h
 * @brief Конфигурация робота-манипулятора 6DOF
 *
 * Содержит все параметры hardware:
 * - Длины звеньев и DH-параметры
 * - Конфигурация сервоприводов
 * - Ограничения рабочей зоны
 * - Параметры безопасности
 * - Настройки движения
 *
 * =====================================================================
 * ВАЖНО (Last modify: 2026-09-25):
 * =====================================================================
 * В ServoConfig добавлено поле homeOffset — сдвиг между математическим
 * углом (q_math, из IK) и физическим углом сервы (servoAngle).
 *
 *   servoAngle = q_math + homeOffset
 *
 * Для P1–P6 (сервы 270°) homeOffset = 135° — при q_math = 0 серва стоит
 * в середине хода.
 * Для P7 (gripper)  homeOffset =   0°.
 *
 * minAngle/maxAngle остаются в МАТЕМАТИЧЕСКОМ диапазоне
 * (-135..+135 для P1–P6, 7..38 для P7) —
 * их использует safety. ServoController сам прибавляет homeOffset
 * перед конвертацией в PWM.
 */

#pragma once

#include <cstdint>

// ====================================================================
// Версия прошивки
// ====================================================================
// Пишется в EEPROM при каждом сохранении. На boot версия из EEPROM
// сравнивается с FW_VERSION: несовпадение (новая прошивка / пустая /
// битая) = заводские настройки + сохранить + ребут (см. setup()).
// Правило: любое изменение дефолтов (DH, палец, лимиты, home) = +1.
// FW_VERSION_STR — человекочитаемая, для M115/boot-лога.
// ====================================================================
#define FW_VERSION 20
#define FW_VERSION_STR "2.4"
// Минор: метка вида движения f.3 (декарт/суставы).
// Минор: P7 min/max 0/100 → 7/38 + IMU-кольцо ×2 слота — миграция обновит.
// Мажор: ServoConfig.backlashCompensation int16→float (раскладка blob
// сменилась; миграция сбросит в заводские — люфты там всё равно не жили).
// Аппаратная ревизия (руками при смене железа; показывает `?`).
#define HW_VERSION_STR "1.3"

// Скорость Serial (прошивка + монитор + все хост-скрипты синхронно!).
// 921600: дамп IMU 1024 строки ~0.6с вместо ~5с на 115200.
// CP2102/CH340 тянут штатно. Мусор boot-ROM при ребуте — косметика.
#define SERIAL_BAUD 921600

// ====================================================================
// Пины и шины: ВСЯ разводка — только здесь
// ====================================================================
// Смена платы/переразводка = править этот блок, код не трогаем.
// I2C общая: PCA9685 (сервы) + BMI160 (IMU); поднимает servoCtrl.init(),
// чинит imuLogger.recoverBus() — обе берут пины/частоту отсюда.
#define I2C_SDA_PIN 21
#define I2C_SCL_PIN 22
#define I2C_CLOCK_HZ 400000  // вернули с 100 кГц: провода 5 см, голый транспорт
#define I2C_TIMEOUT_MS 20    // все транзакции bounded: зависшая шина не вешает задачу
// Дисплей ST7789 по SPI (см. display_ui.h): VSPI-родные MOSI=23/SCLK=18.
#define DISP_SPI_SCLK_PIN 18
#define DISP_SPI_MOSI_PIN 23
#define DISP_PIN_DC 2
#define DISP_PIN_CS 5
#define DISP_PIN_RST 4

// ====================================================================
// Длины звеньев (мм)
// ====================================================================
// L0 = 134 мм — высота базы (от стола до оси J2), чертёж robot1
// L1 = 165 мм — плечо (J2 → J3)
// L2 = 161 мм — предплечье (J3 → J4)
// L3 = 54 мм  — запястье, сегмент вдоль руки (J4 → J5)
// L4 = 53 мм  — запястье, боковой сдвиг (J5 → J6)
// L5 = 27 мм  — запястье, вылет фланца (J6 → фланец)
const int LINK_LENGTHS[] = {134, 165, 161, 54, 53, 27};

// ====================================================================
// Параметры захвата
// ====================================================================
// Кинематическая длина пальца: от фланца O6 (сустав 6 = фланец (27,53,514)
// в нулях) до TCP. Ровно длина захвата по чертежу robot1: 105 мм.
// (Ось J6 идёт вдоль инструмента, поэтому J6→фланец 27 мм сидит в DH
// как d звена 6, а не в пальце.) Команда G0 задаёт TCP (кончик захвата).
const float GRIPPER_FINGER_LENGTH = 105.0;  // мм

// ====================================================================
// DH-параметры (Denavit-Hartenberg)
// ====================================================================
// Формат: {a (мм), alpha (градусы), d (мм), theta_offset (градусы)}
//
// a     — расстояние вдоль оси X (длина звена)
// alpha — угол поворота вокруг оси X (наклон следующей оси)
// d     — расстояние вдоль оси Z (высота звена)
// theta — смещение угла поворота вокруг оси Z
//
// Матрица DH-преобразования:
// T = [ct   -st*ca    st*sa    a*ct ]
//     [st    ct*ca   -ct*sa    a*st ]
//     [0     sa       ca       d    ]
//     [0     0        0        1    ]
// где ct=cos(θ), st=sin(θ), ca=cos(α), sa=sin(α)
// Выведены из чертежа robot1 + физика железа (нулевая поза = вертикальная рука):
//   J2=(0,0,134) J3=(0,0,299) J4=(0,0,460) J5=(0,0,514) J6=(0,53,514)
//   фланец=(27,53,514) TCP=(132,53,514) инструмент=+X.
// Оси нулей: J1=Z, J2=J3=J4=-Y, J5=+Z, J6=+X (J6 = roll вокруг инструмента!).
// J4/J5 пересекаются в J4 (a=0); 54 мм сидит в d звена 5; 27 мм — в d звена 6.
// v2: J6 вдоль инструмента (железо: P6 крутит захват вокруг его оси,
// v1 ошибочно клала J6 вертикально — TCP описывал дугу). FK нулей точен,
// P6=±любой: TCP стоит (132,53,514).
// NOTE: знаки q5/q6 и инверсии серв P5–P6 проверить на железе (jog ±10°).
const float DH_PARAMS[6][4] = {
    {0,     90,  134,  0},    // Joint 1: база (вращение вокруг Z)
    {165,    0,    0,  90},   // Joint 2: плечо (наклон), ноль = ВЕРТИКАЛЬ
    {161,    0,    0,   0},   // Joint 3: локоть (наклон)
    {0,    -90,    0, -90},   // Joint 4: запястье pitch (оси J4/J5 пересекаются)
    {53,    90,   54,  90},   // Joint 5: запястье (J5 → J6 = 53 мм, +54 вдоль Z)
    {0,      0,   27,   0},   // Joint 6: roll фланца (J6 → фланец = 27 мм вдоль +X)
};
// NOTE: theta_offset J2 = +90°: математический ноль плеча — вертикаль вверх
// (железо: серва 270° в середине 135° = рука вверх). Без этого ноль модели
// (горизонт, вылет 415мм) не совпадал с нулём железа.

// ====================================================================
// Конфигурация сервопривода
// ====================================================================
// Описывает характеристики одного сервопривода:
// - Диапазон углов (math) и PWM
// - Корректировка и компенсация люфта
// - Инверсия направления вращения
// - Домашний сдвиг (math → servo)
struct ServoConfig {
    uint8_t  id;                          // ID сервопривода (0-6)
    int16_t  minAngle;                    // минимальный MATH-угол (градусы)
    int16_t  maxAngle;                    // максимальный MATH-угол (градусы)
    uint16_t minPWM;                      // минимальный PWM (мкс)
    uint16_t maxPWM;                      // максимальный PWM (мкс)
    uint16_t maxAngularSpeed;             // максимальная скорость (градусы/с)
    float    correctionFactor;            // корректировка (100.0 = без коррекции)
    float    backlashCompensation;        // компенсация люфта (float! дроби 0.5 влезут; было int16 — резало)
    bool     isInverted;                  // инверсия направления вращения
    int16_t  homeOffset;                  // ← НОВОЕ: math→servo (135° / 90° / 0°)
    uint8_t  directionCorrection[2];      // корректировка [CW, CCW] (для будущего)
};

// ====================================================================
// Ограничения рабочей зоны (мм)
// ====================================================================
// Определяет прямоугольную область, в которой рука может работать:
// - X: ±250 мм от центра базы
// - Y: ±250 мм от центра базы
// - Z: от 20 мм (2 см от стола) до 400 мм
struct WorkspaceLimits {
    float xMin, xMax;  // границы по X
    float yMin, yMax;  // границы по Y
    float zMin, zMax;  // границы по Z (zMin = высота стола + запас)
};

const WorkspaceLimits WORKSPACE = {
    .xMin = -560, .xMax = 560,
    .yMin = -560, .yMax = 560,
    .zMin = 0,     .zMax = 700,    // Z min = 0 (уровень стола)
};
// Прямоугольник = истинные габариты по чертежу robot1 (двойник, 4000 сэмплов):
// maxR_xy=539, max|X/Y|=525, maxZ=667. Старый 250/400 жал под неверную геометрию
// и браковал даже нули (TCP z=514).

// ====================================================================
// Параметры безопасности звеньев (мм)
// ====================================================================
// Определяет ограничения для каждого звена робота:
// - zMin[i] — минимальная высота для звена i (защита от столкновения со столом)
// - maxReach — максимальный радиус вытягивания
// - minReach — минимальный радиус (защита от слишком близкого расположения к оси базы)
// - minLinkDistance — минимальный зазор между непротиворечащими звеньями
//                     (защита от самопересечения кисти с плечом/локтем)
struct LinkSafety {
    float zMin[6];          // минимальная Z для каждого из 6 звеньев
    float maxReach;         // максимальный радиус (мм)
    float minReach;         // минимальный радиус (мм)
    float minLinkDistance;  // мин. зазор между звеньями (мм), 0 = выключено
};

const LinkSafety DEFAULT_LINK_SAFETY = {
    .zMin = {0, 0, 25, 25, 25, 25},       // база и плечо на уровне стола; остальным 25 мм над столом (было 10 — браковало не, но было мало для зазора предплечья со столом)
    .maxReach = 560,                        // истинный вылет ~539 + запас
    .minReach = 0,                          // минимальный радиус не ограничен
    .minLinkDistance = 20.0f,               // защита от самопересечения кисти с плечом/локтем
};

// ====================================================================
// Запретная зона
// ====================================================================
// Прямоугольная область, в которую рука НЕ ДОЛЖНА входить.
// Используется для защиты от столкновений с объектами на столе.
struct ForbiddenZone {
    float xMin, xMax;  // границы по X
    float yMin, yMax;  // границы по Y
    float zMin, zMax;  // границы по Z
    bool  active;      // активна ли зона
    uint8_t skipLinks; // битмаска звеньев, НЕ проверяемых на эту зону
                       // (бит i = звено i не проверяется: статика/конструктив
                       // живёт внутри по построению, проверять бессмысленно)
};

// Максимальное количество запретных зон
const int MAX_FORBIDDEN_ZONES = 10;

// Конструктив: колонна базы как запретная зона по умолчанию.
// Параллелепипед X/Y ±65 (квадрат 130, центр в 0), Z 0..180,
// грани по координатным плоскостям. Рука не должна входить в железо.
// Проверяется на старте: если такой зоны нет — добавляется и сохраняется.
// Маска: звенья 0,1,2 не проверяются (идея: статика и начало локтя живут
// внутри по построению — считать их столкновение со столом бессмысленно).
const ForbiddenZone DEFAULT_CONSTRUCT_ZONE = {-65, 65, -65, 65, 0, 180, true, 0x07};

// ====================================================================
// Полная конфигурация манипулятора
// ====================================================================
// Содержит все настройки робота:
// - Конфигурации всех 7 сервоприводов
// - Ограничения рабочей зоны
// - Параметры безопасности
// - Запретные зоны
// - Длина пальцев захвата
struct ManipulatorConfig {
    ServoConfig    servos[7];                        // конфигурации сервоприводов
    WorkspaceLimits workspace;                       // ограничения рабочей зоны
    LinkSafety     linkSafety;                       // параметры безопасности звеньев
    ForbiddenZone  forbiddenZones[MAX_FORBIDDEN_ZONES]; // запретные зоны
    int            forbiddenZoneCount;               // количество активных запретных зон
    float          fingerLength;                     // длина пальцев захвата (мм)
};

// ====================================================================
// Конфигурация сервоприводов по умолчанию
// ====================================================================
// Параметры для каждого из 7 сервоприводов:
//   ID: 0-5 = суставы, 6 = захват
//   minAngle/maxAngle — MATH-диапазон (то, что видят FK/IK/safety)
//   homeOffset — сдвиг math → servo (135° для всех 270°-серв)
//
//   При q_math = 0 физический угол сервы = homeOffset.
//   Для P1–P6 (270°): 0 → 135° (середина)
//   Для P7 (gripper): 0 →   0° (math = servo; закрыт 7°, открыт 38° — замер владельца)
const ServoConfig DEFAULT_SERVO_CONFIG[7] = {
    // id, minA, maxA, minPWM, maxPWM, speed, correction, backlash, inverted, homeOffset, {CW, CCW}
    {0, -135, 135,  500, 2500, 45, 100, 2, false, 135, {0, 0}},   // Base         math 0 → servo 135 (прямая: M502-тест DH− при T)
    {1, -135, 135,  500, 2500, 45, 100, 1, true, 135, {0, 0}},   // Shoulder     math 0 → servo 135 (зеркальная: M502-тест DH− при F)
    {2, -135, 135,  500, 2500, 45, 100, 2, false, 135, {0, 0}},   // Elbow        math 0 → servo 135 (прямая: визуально 180° вокруг оси + M502-тест)
    {3, -135, 135,  500, 2500, 60, 100, 1, true,  135, {0, 0}},   // Wrist pitch  math 0 → servo 135 (зеркальная: P4-тест ±30 с −1000)
    {4, -135, 135,  500, 2500, 60, 100, 1, false, 135, {0, 0}},   // Wrist roll   math 0 → servo 135
    {5, -135, 135,  500, 2500, 60, 100, 1, false, 135, {0, 0}},   // Wrist yaw    math 0 → servo 135
    {6,    7,  38,  500, 2500,  90, 100, 0, false,   0, {0, 0}},   // Gripper      закрыт 7°, открыт 38° (замер владельца), без offset
};

// Ход захвата, градусы сервы (замер владельца 15.10.2026).
// Проценты M108/G0-J переводятся сюда хелперами ниже (интерфейс остался 0..100).
#define GRIP_CLOSED_DEG 7.0f    // закрыт
#define GRIP_OPEN_DEG 20.0f     // открыт (20°)
inline float gripperPctToAngle(float pct) {
    if (pct < 0.0f) pct = 0.0f;
    if (pct > 100.0f) pct = 100.0f;
    return GRIP_CLOSED_DEG + (GRIP_OPEN_DEG - GRIP_CLOSED_DEG) * (pct / 100.0f);
}
inline float gripperAngleToPct(float angle) {
    float pct = (angle - GRIP_CLOSED_DEG) / (GRIP_OPEN_DEG - GRIP_CLOSED_DEG) * 100.0f;
    if (pct < 0.0f) pct = 0.0f;
    if (pct > 100.0f) pct = 100.0f;
    return pct;
}

// ====================================================================
// Конфигурация по умолчанию
// ====================================================================
// Содержит все дефолтные параметры для первого запуска.
// После калибровки сохраняется в EEPROM (M500) и загружается при старте (M501).
const ManipulatorConfig DEFAULT_CONFIG = {
    .servos = {
        DEFAULT_SERVO_CONFIG[0],
        DEFAULT_SERVO_CONFIG[1],
        DEFAULT_SERVO_CONFIG[2],
        DEFAULT_SERVO_CONFIG[3],
        DEFAULT_SERVO_CONFIG[4],
        DEFAULT_SERVO_CONFIG[5],
        DEFAULT_SERVO_CONFIG[6],
    },
    .workspace = WORKSPACE,
    .linkSafety = DEFAULT_LINK_SAFETY,
    .forbiddenZones = {DEFAULT_CONSTRUCT_ZONE},
    .forbiddenZoneCount = 1,
    .fingerLength = GRIPPER_FINGER_LENGTH,
};

// ====================================================================
// Домашняя позиция (градусы, МАТЕМАТИЧЕСКИЕ q_math, не серво)
// ====================================================================
// Домашняя позиция: ВСЕ СЕРВЫ В 0 (вертикальная рука, инструмент +X,
// TCP=(132,53,514)). Старая сложенная {0,-30,-135,...} была под неверную
// геометрию. Сохраняется в EEPROM командой M111.
//
// ВАЖНО: углы здесь МАТЕМАТИЧЕСКИЕ (q_math), ноль плеча = вертикаль.
// При q_math = 0 серва встанет на homeOffset (135° для всех суставов P1–P6).
const float DEFAULT_HOME_ANGLES[7] = {0, 0, 0, 0, 0, 0, 7};

// Парковочная поза (сложенная, для ночи и перевозки). Углы от владельца:
// P1=35 P2=-120 P3=135 P4=100 P5=-130 P6=0 P7=7 (текущие с железа).
// P3=135 на лимите, но clamp держит.
// Конвенция: перед выключением — G28 H1; старт всегда едет парк→home,
// считая, что рука ночевала в парке (см. setup()).
const float DEFAULT_PARK_ANGLES[7] = {35, -120, 135, 100, -130, 0, 7};

// ====================================================================
// Параметры движения
// ====================================================================
// STEP_INTERVAL_MS — интервал между шагами интерполяции (мс).
//   Чем меньше → плавнее движение, но больше нагрузка на процессор.
//   Рекомендуется: 15-25 мс.
//
// MIN_STEP_DEG — минимальный шаг (градусы).
//   Если изменение угла меньше этого значения, движение не выполняется.
//   Защита от "дрожания" при очень малых перемещениях.
//
// DEFAULT_FEEDRATE — скорость перемещения по умолчанию (мм/с).
//   Используется если G-код не содержит параметр F.
const float STEP_INTERVAL_MS     = 20.0;   // интервал шага (мс)
const float MIN_STEP_DEG         = 0.1;    // минимальный шаг (градусы)
const float DEFAULT_FEEDRATE     = 500.0;  // скорость по умолчанию (мм/с)

// ====================================================================
// Дефолтная ориентация инструмента для G0/G1 без A/B/C
// ====================================================================
// Палец горизонтально вперёд (+X) — продолжение позы нулей:
//   A=90, B=0, C=90  →  toolDir = (1, 0, 0) (эйлеры нулевой позы, двойник).
// Старый дефолт A=-90 (палец +Y) при 132-мм пальце уводил O6 далеко вбок
// (O6 до 410 мм от плеча при лимите модели 326) — REL-шаги от нулей
// не сходились даже на 3 мм. С +X запястье почти прямое: макс. вылет
// и лучшая обусловленность DLS по всему верху workspace.
const float DEFAULT_ORI_A = 90.0;   // roll (градусы)
const float DEFAULT_ORI_B = 0.0;    // pitch (градусы)
const float DEFAULT_ORI_C = 90.0;   // yaw (градусы)
