SpellcasterMom/test/src/safety_checker.cpp

/**
 * Project     : 6DOF arm
 * Codename    : CLAW
 * Author      : Vladimir V. Laykov aka Yago
 * Alma Mater  : Sevastopol State University
 * Group       : УТС/б-23-1-о
 * Mentor      : Lipko I.Y.
 * Date        : 2026-09-18
 * Last modify : 2026-10-01
 */

#include "safety_checker.h"
#include <cmath>

/**
 * @brief Конструктор по умолчанию.
 *
 * Инициализирует проверку безопасности с параметрами по умолчанию из конфигурации:
 * - DEFAULT_LINK_SAFETY: безопасные расстояния для звеньев
 * - WORKSPACE: границы рабочей области
 * - GRIPPER_FINGER_LENGTH: длина пальца захватчика
 * Количество запрещенных зон устанавливается в 0, проверки включены.
 */
SafetyChecker::SafetyChecker()
    : linkSafety(DEFAULT_LINK_SAFETY),
      workspace(WORKSPACE),
      zoneCount(0),
      enabled(true),
      fingerLength(GRIPPER_FINGER_LENGTH) {}

/**
 * @brief Установка конфигурации безопасности.
 * Заменяет текущие параметры безопасности звеньев и границы рабочей области.
 */
void SafetyChecker::setConfig(const LinkSafety &ls, const WorkspaceLimits &ws) {
    linkSafety = ls;
    workspace = ws;
}

/**
 * @brief Установка минимальной высоты стола (общий Z минимум).
 * Это предотвращает столкновение любых частей робота со столом.
 */
void SafetyChecker::setTableZMin(float zMin) {
    workspace.zMin = zMin;
}

/**
 * @brief Установка максимального радиуса дотягивания.
 * Определяет максимальное расстояние от вертикальной оси основания (ось Z)
 * до любой точки робота. Защита от чрезмерного вытягивания.
 */
void SafetyChecker::setMaxReach(float maxR) {
    linkSafety.maxReach = maxR;
}

/**
 * @brief Установка минимального радиуса дотягивания.
 * Определяет минимальное расстояние от вертикальной оси основания.
 * Защита от слишком близкого расположения к основанию (самопересечение).
 */
void SafetyChecker::setMinReach(float minR) {
    linkSafety.minReach = minR;
}

/**
 * @brief Установка минимальной высоты Z для конкретного звена.
 * Каждое звено может иметь свой порог минимальной высоты для
 * предотвращения столкновения с препятствиями на рабочей поверхности.
 * Допустимые индексы: 0-5 (6 основных звеньев).
 */
void SafetyChecker::setLinkZMin(int link, float zMin) {
    if (link >= 0 && link < 6) {
        linkSafety.zMin[link] = zMin;
    }
}

/**
 * @brief Установка длины пальца захватчика.
 * Используется для проверки безопасности виртуального 7-го звена (палец).
 */
void SafetyChecker::setFingerLength(float len) {
    fingerLength = len;
    fkSolver.setFingerLength(len);
}

void SafetyChecker::setDHParams(const float dh[6][4]) {
    fkSolver.setDHParams(dh);
}

/**
 * @brief Добавление запрещенной зоны (прямоугольный параллелепипед).
 * Координаты границ автоматически сортируются (min/max), поэтому
 * порядок подачи x1/x2, y1/y2, z1/z2 не важен.
 * Максимальное количество зон: MAX_FORBIDDEN_ZONES.
 */
void SafetyChecker::addForbiddenZone(float x1, float x2, float y1, float y2,
                                      float z1, float z2, uint8_t skipMask) {
    if (zoneCount >= MAX_FORBIDDEN_ZONES) return;
    zones[zoneCount] = {
        .xMin = fmin(x1, x2), .xMax = fmax(x1, x2),
        .yMin = fmin(y1, y2), .yMax = fmax(y1, y2),
        .zMin = fmin(z1, z2), .zMax = fmax(z1, z2),
        .active = true,
        .skipLinks = skipMask,   // M410: 0 (все звенья); конструктив несёт свою
    };
    zoneCount++;
}

/**
 * @brief Очистка всех запрещенных зон.
 * Устанавливает счетчик зон в 0, фактически деактивируя все зоны.
 */
void SafetyChecker::clearForbiddenZones() {
    zoneCount = 0;
}

/**
 * @brief Включение/отключение проверок безопасности.
 * При отключении все методы проверки (checkPosition, checkAllLinks,
 * checkTrajectory) будут безусловно возвращать true.
 */
void SafetyChecker::enable(bool en) {
    enabled = en;
}

bool SafetyChecker::isEnabled() const {
    return enabled;
}

String SafetyChecker::getLastError() const {
    return lastError;
}

int SafetyChecker::getZoneCount() const {
    return zoneCount;
}

bool SafetyChecker::getForbiddenZone(int index, float &x1, float &x2, float &y1, float &y2, float &z1, float &z2, bool &active) const {
    if (index < 0 || index >= MAX_FORBIDDEN_ZONES) return false;
    x1 = zones[index].xMin;
    x2 = zones[index].xMax;
    y1 = zones[index].yMin;
    y2 = zones[index].yMax;
    z1 = zones[index].zMin;
    z2 = zones[index].zMax;
    active = zones[index].active;
    return true;
}

/**
 * @brief Проверка попадания точки в рабочую область.
 * Рабочая область определяется прямоугольным параллелепипедом
 * с границами: x ∈ [xMin, xMax], y ∈ [yMin, yMax], z ∈ [zMin, zMax].
 */
bool SafetyChecker::insideWorkspace(const Vec3 &p) const {
    return (p.x >= workspace.xMin && p.x <= workspace.xMax &&
            p.y >= workspace.yMin && p.y <= workspace.yMax &&
            p.z >= workspace.zMin && p.z <= workspace.zMax);
}

/**
 * @brief Проверка попадания точки в запрещенную зону.
 * Перебирает все активные запрещенные зоны. Если точка попадает
 * внутрь хотя бы одной зоны (все 6 координат в пределах), возвращает true.
 * Неактивные зоны пропускаются. Звено linkIdx>=0 пропускает зоны,
 * в чьей маске skipLinks стоит его бит (статика/конструктив).
 */
bool SafetyChecker::insideForbiddenZone(const Vec3 &p, int linkIdx) const {
    for (int i = 0; i < zoneCount; i++) {
        if (!zones[i].active) continue;
        if (linkIdx >= 0 && (zones[i].skipLinks & (1 << linkIdx))) continue;
        if (p.x >= zones[i].xMin && p.x <= zones[i].xMax &&
            p.y >= zones[i].yMin && p.y <= zones[i].yMax &&
            p.z >= zones[i].zMin && p.z <= zones[i].zMax) {
            return true;
        }
    }
    return false;
}

/**
 * @brief Линейная интерполяция точки на отрезке.
 * Формула: result = a + (b - a) * t
 * При t=0 возвращает точку a, при t=1 — точку b.
 */
Vec3 SafetyChecker::sampleOnLink(const Vec3 &a, const Vec3 &b, float t) const {
    return a + (b - a) * t;
}

float SafetyChecker::distSegmentSegment2(const Vec3 &p0, const Vec3 &p1,
                                         const Vec3 &q0, const Vec3 &q1) {
    Vec3 d1 = p1 - p0;
    Vec3 d2 = q1 - q0;
    Vec3 r = p0 - q0;
    float a = d1.x * d1.x + d1.y * d1.y + d1.z * d1.z;
    float e = d2.x * d2.x + d2.y * d2.y + d2.z * d2.z;
    float f = d2.x * r.x + d2.y * r.y + d2.z * r.z;
    const float kEps = 1e-6f;
    float s, t;
    if (a < kEps) {
        s = 0.0f;
        t = (e < EPS) ? 0.0f : constrain(f / e, 0.0f, 1.0f);
    } else {
        float c = d1.x * r.x + d1.y * r.y + d1.z * r.z;
            if (e < kEps) {
            t = 0.0f;
            s = constrain(-c / a, 0.0f, 1.0f);
        } else {
            float b = d1.x * d2.x + d1.y * d2.y + d1.z * d2.z;
            float denom = a * e - b * b;
            if (denom < 1e-6f) {
                s = 0.0f;
                t = constrain(f / e, 0.0f, 1.0f);
            } else {
                s = constrain((b * f - c * e) / denom, 0.0f, 1.0f);
                t = (b * s + f) / e;
                if (t < 0.0f) {
                    t = 0.0f;
                    s = constrain(-c / a, 0.0f, 1.0f);
                } else if (t > 1.0f) {
                    t = 1.0f;
                    s = constrain((b - c) / a, 0.0f, 1.0f);
                }
            }
        }
    }
    Vec3 c1 = p0 + d1 * s;
    Vec3 c2 = q0 + d2 * t;
    Vec3 diff = c1 - c2;
    return diff.x * diff.x + diff.y * diff.y + diff.z * diff.z;
}

/**
 * @brief Проверка безопасности одного звена.
 *
 * Метод сэмплирует 5 точек равномерно вдоль звена (от jointA до jointB)
 * и для каждой точки выполняет комплексную проверку:
 *
 * 1. Минимальная высота Z: для каждого звена задается свой порог zMin.
 *    Для виртуального 7-го звена (палец) используется zMin звена 5.
 *    Это предотвращает столкновение звена с рабочей поверхностью.
 *
 * 2. Границы рабочей области: точка должна находиться внутри
 *    прямоугольной области workspace.
 *
 * 3. Цилиндрический радиус дотягивания (reach):
 *    - maxReach: максимальное расстояние от оси Z основания (защита от перерастяжения)
 *    - minReach: минимальное расстояние от оси Z основания (защита от самопересечения)
 *    Радиус вычисляется как sqrt(x² + y²) — расстояние в плоскости XY.
 *
 * 4. Запрещенные зоны: точка не должна попадать в ранее определенные зоны.
 *
 * Если хотя бы одна проверка не проходит, метод возвращает false
 * и записывает описание ошибки в lastError.
 */
bool SafetyChecker::checkLinkSafety(const Vec3 &jointA, const Vec3 &jointB, int linkIdx) {
    if (linkIdx < 0 || linkIdx >= MAX_LINKS) return true;

    // Для виртуального 7-го звена (палец захватчика) используем zMin звена 5,
    // так как палец является продолжением последнего реального звена
    float zMin = (linkIdx < 6) ? linkSafety.zMin[linkIdx] : linkSafety.zMin[5];

    // Количество точек для сэмплирования вдоль звена
    const int SAMPLES = 5;
    // Квадраты порогов: в горячем пути сравниваем reach2 без sqrt
    // (sqrt — только в редкой ветке отказа, для текста ошибки).
    const float maxR2 = linkSafety.maxReach * linkSafety.maxReach;
    const float minR2 = linkSafety.minReach * linkSafety.minReach;
    for (int s = 0; s <= SAMPLES; s++) {
        float t = (float)s / SAMPLES;
        Vec3 point = sampleOnLink(jointA, jointB, t);

        // Проверка 1: минимальная высота Z для данного звена
        if (point.z < zMin) {
            lastError = "Link " + String(linkIdx) +
                        " Z=" + String(point.z, 1) + " < Z_MIN=" + String(zMin, 1);
            return false;
        }

        // Проверка 2: границы рабочей области
        if (!insideWorkspace(point)) {
            lastError = "Link " + String(linkIdx) +
                        " outside workspace at (" + String(point.x, 1) + ", " +
                        String(point.y, 1) + ", " + String(point.z, 1) + ")";
            return false;
        }

        // Проверка 3: цилиндрический радиус дотягивания (расстояние от оси Z основания)
        // Сравнение в квадратах — без sqrt; корень только для текста отказа.
        const float reach2 = point.x * point.x + point.y * point.y;
        if (reach2 > maxR2) {
            float reachXY = sqrt(reach2);
            lastError = "Link " + String(linkIdx) +
                        " reach=" + String(reachXY, 1) + " > MAX=" + String(linkSafety.maxReach, 1);
            return false;
        }
        if (reach2 < minR2) {
            float reachXY = sqrt(reach2);
            lastError = "Link " + String(linkIdx) +
                        " reach=" + String(reachXY, 1) + " < MIN=" + String(linkSafety.minReach, 1);
            return false;
        }

        // Проверка 4: запрещенные зоны (с маской звена: статика/конструктив
        // внутри по построению — их столкновение не считаем).
        if (insideForbiddenZone(point, linkIdx)) {
            lastError = "Link " + String(linkIdx) +
                        " in forbidden zone at (" + String(point.x, 1) + ", " +
                        String(point.y, 1) + ", " + String(point.z, 1) + ")";
            return false;
        }
    }

    return true;
}

/**
 * @brief Проверка позиции конечного эффектора.
 * Проверяет только попадание заданной точки в рабочую область
 * и отсутствие в запрещенных зонах. Не проверяет звенья —
 * для этого предназначен метод checkAllLinks().
 * Если проверки отключены (enabled=false), всегда возвращает true.
 */
bool SafetyChecker::checkPosition(const Vec3 &pos) const {
    if (!enabled) return true;

    if (!insideWorkspace(pos)) {
        return false;
    }

    if (insideForbiddenZone(pos)) {
        return false;
    }

    return true;
}

/**
 * @brief Проверка безопасности всех звеньев для заданной конфигурации.
 *
 * Последовательно выполняет:
 *
 * 1. Прямая кинематика: вычисляет позиции всех 7 сочленений (6 реальных + TCP)
 *    с помощью FKSolver.
 *
 * 2. Проверка радиуса дотягивания для каждого сочленения (индексы 1-6):
 *    Каждое сочленение должно находиться в пределах [minReach, maxReach]
 *    от оси Z основания.
 *
 * 3. Проверка 6 основных звеньев (индексы 0-5):
 *    Для каждого звена (от сочленения i до i+1) вызывается checkLinkSafety(),
 *    которая сэмплирует 5 точек и проверяет Z минимум, границы, радиус и запрещенные зоны.
 *
 * 4. Проверка виртуального 7-го звена (палец захватчика):
 *    Звено от 6-го сочленения до TCP (Tool Center Point).
 *    Палец также должен быть безопасен по всем параметрам.
 *
 * @param q Массив углов 6 сочленений (в градусах)
 * @return true если все звенья безопасны
 */
bool SafetyChecker::checkAllLinks(const float q[6]) {
    if (!enabled) return true;

    // Однопроходная FK: joints + TCP за 6 трансформов
    // (раньше getAllJointPositions + getEndEffector считали цепочку дважды).
    Vec3 joints[7];
    Vec3 tcp, fdir;
    Mat4 T06;
    fkSolver.getPose(q, joints, tcp, fdir, T06);
    (void)fdir;
    (void)T06;

    // Проверка каждого звена, КРОМЕ нулевого (J0→J1 — статическая колонна:
    // оба конца зафиксированы всегда, считать её столкновение со столом
    // бессмысленно; заодно ~1/7 времени safety и никаких ложных FAIL'ов базы).
    // Проверка радиуса для сочленений (1-6) ниже — без изменений.
    // Квадраты порогов: в горячем пути без sqrt, корень — только в текст отказа.
    const float maxR2 = linkSafety.maxReach * linkSafety.maxReach;
    const float minR2 = linkSafety.minReach * linkSafety.minReach;
    for (int i = 1; i <= 6; i++) {
        const float reach2 = joints[i].x * joints[i].x + joints[i].y * joints[i].y;
        if (reach2 > maxR2) {
            float reachXY = sqrt(reach2);
            lastError = "Joint " + String(i) + " reach=" + String(reachXY, 1) +
                        " > MAX=" + String(linkSafety.maxReach, 1);
            return false;
        }
        if (reach2 < minR2) {
            float reachXY = sqrt(reach2);
            lastError = "Joint " + String(i) + " reach=" + String(reachXY, 1) +
                        " < MIN=" + String(linkSafety.minReach, 1);
            return false;
        }
    }

    // Проверка звеньев 1..6 (нулевое J0→J1 — статическая колонна базы:
    // оба конца зафиксированы, столкновение считать бессмысленно).
    // Каждое звено проверяется по 5 точкам на Z минимум, границы, радиус и запрещенные зоны
    for (int i = 1; i < 6; i++) {
        if (!checkLinkSafety(joints[i], joints[i + 1], i)) {
            return false;
        }
    }

    // Проверка виртуального 7-го звена: палец захватчика (от 6-го сочленения до TCP)
    // tcp уже из getPose выше — повторного FK нет.
    if (!checkLinkSafety(joints[6], tcp, 6)) {
        return false;
    }

    return true;
}

bool SafetyChecker::checkLinkDistances(const float q[6]) {
    float minDist = linkSafety.minLinkDistance;
    if (minDist <= 0.0f) return true;  // защита выключена

    float minDist2 = minDist * minDist;

    Vec3 joints[7];
    Vec3 tcp, fdir;
    Mat4 T06;
    fkSolver.getPose(q, joints, tcp, fdir, T06);
    (void)fdir;
    (void)T06;

    // Энпоинты звеньев: link k (3..5) = joints[k]→joints[k+1], link 6 = joints[6]→tcp.
    // Самопересечение возможно только в запястье (ссылки 3..6). Плечо/локоть
    // (ссылки 1..2) не пересекутся ни с чем по построению — не проверяем.
    struct LinkSeg { int idx; Vec3 a, b; };
    LinkSeg links[4];
    int linkCount = 0;
    for (int k = 3; k <= 6; k++) {
        LinkSeg ls;
        ls.idx = k;
        if (k <= 5) {
            ls.a = joints[k];
            ls.b = joints[k + 1];
        } else {
            ls.a = joints[6];
            ls.b = tcp;
        }
        links[linkCount++] = ls;
    }

    for (int i = 0; i < linkCount; i++) {
        for (int j = i + 1; j < linkCount; j++) {
            // Соседние звенья делят сустав (индексы подряд) — пропускаем.
            if (links[j].idx == links[i].idx + 1) continue;
            float d2 = distSegmentSegment2(links[i].a, links[i].b, links[j].a, links[j].b);
            if (d2 < minDist2) {
                float d = sqrt(d2);
                lastError = "Self-collision: link " + String(links[i].idx) +
                            " <-> link " + String(links[j].idx) +
                            " dist=" + String(d, 1) + "mm < " + String(minDist, 1) + "mm";
                return false;
            }
        }
    }

    return true;
}

/**
 * @brief Проверка безопасной траектории между двумя конфигурациями.
 *
 * Линейно интерполирует углы сочленений между qStart и qEnd
 * и проверяет безопасность всего манипулятора в каждом промежуточном шаге.
 *
 * Алгоритм:
 * 1. Делит траекторию на steps промежуточных шагов (по умолчанию 20)
 * 2. Для каждого шага вычисляет углы: q = qStart + (qEnd - qStart) * t
 * 3. Вызывает checkAllLinks(q) для проверки безопасности в этой точке
 * 4. Если хотя бы одна точка небезопасна — возвращает false
 *
 * Это гарантирует, что между безопасными начальной и конечной позициями
 * нет столкновений на промежуточных этапах движения.
 *
 * @param qStart Начальные углы (6 сочленений)
 * @param qEnd Конечные углы (6 сочленений)
 * @param steps Количество промежуточных шагов (по умолчанию 20)
 * @return true если вся траектория безопасна
 */
bool SafetyChecker::checkTrajectory(const float qStart[6], const float qEnd[6], int steps) {
    if (!enabled) return true;

    for (int step = 0; step <= steps; step++) {
        float t = (float)step / steps;
        float q[6];

        // Линейная интерполяция углов для текущего шага
        for (int i = 0; i < 6; i++) {
            q[i] = qStart[i] + (qEnd[i] - qStart[i]) * t;
        }

        // Проверка всех звеньев для текущей промежуточной конфигурации
        if (!checkAllLinks(q)) {
            lastError = "Collision at step " + String(step) + "/" + String(steps) +
                        ": " + lastError;
            return false;
        }
    }

    return true;
}
