SpellcasterMom/test/src/commands.h

/**
 * Project     : 6DOF arm
 * Codename    : CLAW
 * Author      : Vladimir V. Laykov aka Yago
 * Alma Mater  : Sevastopol State University
 * Group       : УТС/б-23-1-о
 * Mentor      : Lipko I.Y.
 * Date        : 2026-09-18
 * Last modify : 2026-10-05
 */

#pragma once

#include "types.h"

// ===== Предварительные объявления обработчиков команд =====
// Каждая команда G-кода или M-кода имеет свою функцию-обработчик,
// которая вызывается при распознавании команды в строке G-кода.
// Все обработчики принимают структуру GCodeCommand с разобранными параметрами.
void handleG0(GCodeCommand &cmd);
void handleG1(GCodeCommand &cmd);
void handleG28(GCodeCommand &cmd);
void handleG90(GCodeCommand &cmd);
void handleG91(GCodeCommand &cmd);

void handleM104(GCodeCommand &cmd);
void handleM105(GCodeCommand &cmd);
void handleM108(GCodeCommand &cmd);
void handleM119(GCodeCommand &cmd);
void handleM114(GCodeCommand &cmd);
void handleM115(GCodeCommand &cmd);
void handleM112(GCodeCommand &cmd);

void handleM400(GCodeCommand &cmd);
void handleM410(GCodeCommand &cmd);
void handleM411(GCodeCommand &cmd);
void handleM412(GCodeCommand &cmd);
void handleM413(GCodeCommand &cmd);
void handleM414(GCodeCommand &cmd);
void handleM415(GCodeCommand &cmd);
void handleM416(GCodeCommand &cmd);
void handleM417(GCodeCommand &cmd);

void handleM420(GCodeCommand &cmd);
void handleM425(GCodeCommand &cmd);
void handleM426(GCodeCommand &cmd);

void handleM430(GCodeCommand &cmd);

void handleM450(GCodeCommand &cmd);

void handleM500(GCodeCommand &cmd);
void handleM501(GCodeCommand &cmd);
void handleM502(GCodeCommand &cmd);

void handleM111(GCodeCommand &cmd);

void handleHelp(GCodeCommand &cmd);

// ===== Таблица команд =====
// Массив CommandDef, содержащий все поддерживаемые команды контроллера.
// Каждый элемент массива описывает одну команду:
//   - name:             строковое имя команды (например "G0", "M104", "?")
//   - description:      краткое описание команды (выводится в справке)
//   - params:           массив ожидаемых параметров команды (см. ниже)
//   - paramCount:       количество параметров в массиве params
//   - handler:          указатель на функцию-обработчик, которая будет вызвана
//                       при выполнении этой команды
//
// Структура параметра (CommandParam) содержит:
//   - letter:           буква параметра (X, Y, Z, F, P, S, L, R и т.д.)
//   - type:             тип значения: PARAM_FLOAT (вещественное) или PARAM_INT (целое)
//   - required:         обязательность: 0 = необязательный, -1 = обязательный
//   - defaultValue:     значение по умолчанию (используется, если параметр не указан)
//
// Пример разбора строки: "G1 X100 Y50 F500"
//   - Команда: G1
//   - Параметры: X=100.0, Y=50.0, F=500.0 (остальные берут значения по умолчанию)
//
// Указатель handler работает следующим образом:
//   парсер G-кода находит команду по имени в таблице COMMANDS[],
//   извлекает параметры из строки, заполняет структуру GCodeCommand,
//   затем вызывает handler(cmd) — функцию-обработчик этой команды.
const CommandDef COMMANDS[] = {
    // ================================================================
    // G-команды (гравировочные/геометрические команды)
    // Используются для управления движением робота-манипулятора.
    // G0  — быстрое перемещение (без контроля скорости)
    // G1  — линейное перемещение с заданной подачей (feedrate)
    // G28 — возврат в домашнюю позицию (хоминг) или парковка
    // G90 — абсолютная система координат (все координаты от нуля)
    // G91 — относительная система координат (координаты от текущей позиции)
    // ================================================================
    {
        .name = "G0",
        .description = "Move to position (IK/Direct/Mixed)",
        // Параметры G0:
        //   X, Y, Z — целевая позиция в декартовых координатах ( мм)
        //   A, B, C — углы ориентации (градусы): A = roll, B = pitch, C = yaw
        //   J       — номер промежуточной точки для смешанного движения (joint/linear)
        //   P       — номер промежуточной точки (обязательный для смешанного режима)
        .params = {
            {'X', PARAM_FLOAT, 0, 0.0},
            {'Y', PARAM_FLOAT, 0, 0.0},
            {'Z', PARAM_FLOAT, 0, 0.0},
            {'A', PARAM_FLOAT, 0, 0.0},
            {'B', PARAM_FLOAT, 0, 0.0},
            {'C', PARAM_FLOAT, 0, 0.0},
            {'J', PARAM_FLOAT, 0, 0.0},
            {'P', PARAM_FLOAT, -1, 0.0},
        },
        .paramCount = 8,
        .handler = handleG0,
    },
    {
        .name = "G1",
        .description = "Move with feedrate",
        // Параметры G1:
        //   X, Y, Z — целевая позиция (мм)
        //   A, B, C — углы ориентации (градусы)
        //   J       — номер промежуточной точки
        //   F       — скорость подачи (мм/мин), по умолчанию 500.0
        //   P       — номер промежуточной точки (обязательный для смешанного режима)
        //   Q       — блендинг цепочки: Q1 = в конце НЕ тормозить (следующий G1
        //             продолжит движение; см. FLOW.md). Без Q — стоп как раньше.
        .params = {
            {'X', PARAM_FLOAT, 0, 0.0},
            {'Y', PARAM_FLOAT, 0, 0.0},
            {'Z', PARAM_FLOAT, 0, 0.0},
            {'A', PARAM_FLOAT, 0, 0.0},
            {'B', PARAM_FLOAT, 0, 0.0},
            {'C', PARAM_FLOAT, 0, 0.0},
            {'J', PARAM_FLOAT, 0, 0.0},
            {'F', PARAM_FLOAT, 0, 500.0},
            {'P', PARAM_FLOAT, -1, 0.0},
            {'Q', PARAM_FLOAT, 0, 0.0},
        },
        .paramCount = 10,
        .handler = handleG1,
    },
    {
        .name = "G28",
        .description = "Home (G28) or Park (G28 H1) — fold into compact position",
        // Параметры G28:
        //   H — режим: 0 = хоминг (возврат в нулевые углы), 1 = парковка (сложение в компактную позицию)
        .params = {
            {'H', PARAM_INT, 0, 0},
        },
        .paramCount = 1,
        .handler = handleG28,
    },
    {
        .name = "G90",
        .description = "Absolute positioning mode",
        // G90 не имеет параметров. Переключает контроллер в абсолютный режим координат.
        // Все последующие координаты в G0/G1 будут интерпретироваться как абсолютные
        // (относительно нулевой точки рабочего пространства).
        .params = {},
        .paramCount = 0,
        .handler = handleG90,
    },
    {
        .name = "G91",
        .description = "Relative positioning mode",
        // G91 не имеет параметров. Переключает контроллер в относительный режим координат.
        // Все последующие координаты в G0/G1 будут интерпретироваться как приращения
        // относительно текущей позиции.
        .params = {},
        .paramCount = 0,
        .handler = handleG91,
    },

    // ================================================================
    // M-команды: Управление сервоприводами
    // Команды для прямого управления серводвигателями и получения
    // информации об их текущем состоянии.
    // ================================================================
    {
        .name = "M104",
        .description = "Set servo angle: M104 P1=90",
        // Параметры M104:
        //   P — номер сервопривода (обязательный, начинается с 1)
        //       Пример: M104 P1=90 — установить сервопривод 1 в угол 90°
        .params = {
            {'P', PARAM_FLOAT, -1, 0.0},
        },
        .paramCount = 1,
        .handler = handleM104,
    },
    {
        .name = "M105",
        .description = "Report current servo angles",
        // M105 не имеет параметров. Запрашивает и выводит текущие углы всех сервоприводов.
        .params = {},
        .paramCount = 0,
        .handler = handleM105,
    },
    {
        .name = "M108",
        .description = "Set gripper: M108 S=50 (percent 0-100) [T=sec]",
        // Параметры M108:
        //   S — открытие захвата в процентах (0=закрыт, 100=открыт)
        //   T — время движения в секундах (0.5–3.0), опционально
        //       Пример: M108 S=75 T=2 — открыть на 75% за 2 секунды
        .params = {
            {'S', PARAM_FLOAT, -1, 50.0},
            {'T', PARAM_FLOAT, 0, 0.0},
        },
        .paramCount = 2,
        .handler = handleM108,
    },
    {
        .name = "M119",
        .description = "IMU telemetry: M119 [S=1 dump] [S=2 live] [D=4 decimate]",
        // Параметры M119:
        //   без параметров — живые значения (наклон, counts, bias, пики);
        //   S=1 — дамп кольца последнего движения (#IMU строки + OK);
        //   S=2 — живой поток #IMU (тоггл; только при движении; M112 гасит);
        //   D=N — печатать каждый N-й сэмпл (быстрее).
        //       Пример: M119 S=1 D=4 — дамп с децимацией 4
        .params = {
            {'S', PARAM_FLOAT, -1, 0.0},
            {'D', PARAM_FLOAT, -1, 1.0},
        },
        .paramCount = 2,
        .handler = handleM119,
    },
    {
        .name = "M114",
        .description = "Report current position (FK)",
        // M114 не имеет параметров. Вычисляет прямую кинематику (FK)
        // и выводит текущую позицию-endeffector в декартовых координатах (X, Y, Z, A, B, C).
        .params = {},
        .paramCount = 0,
        .handler = handleM114,
    },
    {
        .name = "M115",
        .description = "Kinematics diagnostics: M115 [S=1]",
        // M115 выводит журнал последнего движения для разбора кинематики:
        // цель (TARGET), кандидаты IK (SOLS), выбранное решение (CHOSEN),
        // фактическое положение (ACTUAL) и расхождение (RESIDUAL).
        // Параметр S=1 — полные цепочки J0..J6 для всех кандидатов.
        .params = {
            {'S', PARAM_INT, 0, 0},
        },
        .paramCount = 1,
        .handler = handleM115,
    },
    {
        .name = "M112",
        .description = "Emergency stop",
        // M112 не имеет параметров. Аварийная остановка — немедленно отключает
        // все сервоприводы и останавливает любое выполняющееся движение.
        .params = {},
        .paramCount = 0,
        .handler = handleM112,
    },

    // ================================================================
    // M-команды: Калибровка
    // Команды для настройки и калибровки робота.
    // ================================================================
    {
        .name = "M111",
        .description = "Save current angles as HOME",
        // M111 не имеет параметров. Сохраняет текущие углы сервоприводов
        // как домашнюю (нулевую) позицию. Используется при калибровке робота.
        .params = {},
        .paramCount = 0,
        .handler = handleM111,
    },

    // ================================================================
    // M-команды: Люфт (Backlash)
    // Команды для компенсации механического люфта в передачах сервоприводов.
    // ================================================================
    {
        .name = "M400",
        .description = "Backlash: M400 [P1=1.5 ..] (merge, no args = print)",
        // Параметры M400:
        //   без параметров — печать текущих; заданные мержатся в текущие
        //   (незаданные НЕ затираются) + зеркало в config для M500.
        //   P — номер сервопривода (обязательный)
        //       Пример: M400 P1=1.5 — установить люфт 1.5° для сервопривода 1
        .params = {
            {'P', PARAM_FLOAT, -1, 0.0},
        },
        .paramCount = 1,
        .handler = handleM400,
    },

    // ================================================================
    // M-команды: Ограничения рабочего пространства
    // Команды для установки геометрических ограничений, предотвращающих
    // движение робота за пределы безопасной зоны.
    // ================================================================
    {
        .name = "M410",
        .description = "Set forbidden zone: M410 X1=0 X2=200 Y1=-50 Y2=50 Z1=0 Z2=50",
        // Параметры M410:
        //   X — X1 (min X), Y — X2 (max X), Z — Y1 (min Y)
        //   A — Y2 (max Y), B — Z1 (min Z), C — Z2 (max Z)
        .params = {
            {'X', PARAM_FLOAT, 0, 0.0},
            {'Y', PARAM_FLOAT, 0, 0.0},
            {'Z', PARAM_FLOAT, 0, 0.0},
            {'A', PARAM_FLOAT, 0, 0.0},
            {'B', PARAM_FLOAT, 0, 0.0},
            {'C', PARAM_FLOAT, 0, 0.0},
        },
        .paramCount = 6,
        .handler = handleM410,
    },
    {
        .name = "M411",
        .description = "Set table Z min: M411 Z0=50",
        // Параметры M411:
        //   Z — минимальная высота стола по оси Z (мм), по умолчанию 50.0
        // Используется для предотвращения столкновения инструмента со столом.
        .params = {
            {'Z', PARAM_FLOAT, 0, 50.0},
        },
        .paramCount = 1,
        .handler = handleM411,
    },
    {
        .name = "M412",
        .description = "Set max reach: M412 R=395",
        // Параметры M412:
        //   R — максимальная reachable (достижимая) длина (мм), по умолчанию 300.0
        // Определяет максимальное расстояние от основания, на которое может
        // выдвинуться робот.
        .params = {
            {'R', PARAM_FLOAT, 0, 300.0},
        },
        .paramCount = 1,
        .handler = handleM412,
    },
    {
        .name = "M413",
        .description = "Set min reach: M413 R=50",
        // Параметры M413:
        //   R — минимальная reachable (достижимая) длина (мм), по умолчанию 50.0
        // Определяет минимальное расстояние от основания, необходимое для работы.
        .params = {
            {'R', PARAM_FLOAT, 0, 50.0},
        },
        .paramCount = 1,
        .handler = handleM413,
    },
    {
        .name = "M414",
        .description = "Set gripper finger length: M414 L=50",
        // Параметры M414:
        //   L — длина пальцев захвата (мм), по умолчанию 50.0
        // Используется для корректного расчета кинематики с учетом длины захвата.
        .params = {
            {'L', PARAM_FLOAT, 0, 50.0},
        },
        .paramCount = 1,
        .handler = handleM414,
    },
    {
        .name = "M415",
        .description = "Disable safety checks",
        // M415 не имеет параметров. Отключает все проверки безопасности
        // (ограничения рабочего пространства, запретные зоны и т.д.).
        // ВНИМАНИЕ: использовать с осторожностью!
        .params = {},
        .paramCount = 0,
        .handler = handleM415,
    },
    {
        .name = "M416",
        .description = "Enable safety checks",
        // M416 не имеет параметров. Включает все проверки безопасности.
        // Рекомендуется использовать после M415 или при первом запуске.
        .params = {},
        .paramCount = 0,
        .handler = handleM416,
    },
    {
        .name = "M417",
        .description = "List forbidden zones: M417",
        // Выводит количество и параметры всех запретных зон.
        // Используется для проверки текущих запретных зон.
        .params = {},
        .paramCount = 0,
        .handler = handleM417,
    },

    // ================================================================
    // M-команды: Безопасность звеньев (Link Safety)
    // Команды для установки индивидуальных ограничений по оси Z
    // для каждого звена манипулятора.
    // ================================================================
    {
        .name = "M420",
        .description = "Set link Z min: M420 L1 Z=30",
        // Параметры M420:
        //   L — номер звена манипулятора (обязательный, начиная с 1)
        //   Z — минимальная допустимая высота по оси Z для этого звена (мм)
        // Позволяет задать индивидуальные ограничения высоты для каждого звена,
        // что предотвращает столкновение звеньев друг с другом или со столом.
        .params = {
            {'L', PARAM_INT, 0, 0},
            {'Z', PARAM_FLOAT, 0, 0.0},
        },
        .paramCount = 2,
        .handler = handleM420,
    },
    {
        .name = "M425",
        .description = "Disable safety (alias)",
        // M425 — псевдоним (алиас) для M415. Отключает проверки безопасности.
        .params = {},
        .paramCount = 0,
        .handler = handleM425,
    },
    {
        .name = "M426",
        .description = "Enable safety (alias)",
        // M426 — псевдоним (алиас) для M416. Включает проверки безопасности.
        .params = {},
        .paramCount = 0,
        .handler = handleM426,
    },

    // ================================================================
    // M-команды: Стратегия интерполяции
    // Команды для выбора алгоритма интерполяции при движении
    // по траектории с несколькими промежуточными точками.
    // ================================================================
    {
        .name = "M430",
        .description = "Set interpolation strategy: M430 S=0 (0=linear,1=seq,2=groups,3=auto)",
        // Параметры M430:
        //   S — номер стратегии интерполяции (по умолчанию 3 = auto):
        //       0 = linear  — линейная интерполяция (все оси движутся одновременно)
        //       1 = seq     — последовательная интерполяция (оси движутся по очереди)
        //       2 = groups  — групповая интерполяция (ось группируются для синхронного движения)
        //       3 = auto    — автоматический выбор стратегии (по умолчанию)
        .params = {
            {'S', PARAM_INT, 0, 3},  // default AUTO
        },
        .paramCount = 1,
        .handler = handleM430,
    },
    {
        .name = "M450",
        .description = "Waypoint stream: M450 S=1 open, G1s, M450 S=0 drain, M450 S=2 abort",
        // Поток точек (стриминг): планировщик считает IK заранее, исполнитель
        // дренирует кольцо строгим кадансом — ШИМ не останавливается на счёт.
        //   S=1 — открыть (следующие G1 копятся; OK = принято+провалидировано,
        //         придерживается пока нет места — backpressure, не ERROR);
        //   S=0 — барьер: докачать, исполнить всё без остановок, встать;
        //   S=2 — сбросить без движения (идемпотентно).
        // Правила: кольцо 180 точек (~3 авто-чанка по 60); голод —
        // hold-and-resume со счётчиком; отказ точки = ERROR + сброс потока;
        // G0/M104/G28/M108 и jog при открытом/исполняемом потоке запрещены;
        // M112 — стоп + сброс всегда. Без потока G1 едет как раньше.
        .params = {
            {'S', PARAM_INT, 0, 0},
        },
        .paramCount = 1,
        .handler = handleM450,
    },

    // ================================================================
    // M-команды: EEPROM (постоянное хранилище)
    // Команды для управления сохранением и загрузкой конфигурации
    // в энергонезависимую память (EEPROM).
    // ================================================================
    {
        .name = "M500",
        .description = "Save config to EEPROM",
        // M500 не имеет параметров. Сохраняет текущую конфигурацию
        // (углы_HOME, люфты, ограничения, стратегию интерполяции и т.д.)
        // в EEPROM. Конфигурация сохраняется между циклами питания.
        .params = {},
        .paramCount = 0,
        .handler = handleM500,
    },
    {
        .name = "M501",
        .description = "Load config from EEPROM",
        // M501 не имеет параметров. Загружает конфигурацию из EEPROM
        // в оперативную память. Используется при старте контроллера
        // или для восстановления сохраненных настроек.
        .params = {},
        .paramCount = 0,
        .handler = handleM501,
    },
    {
        .name = "M502",
        .description = "Load factory defaults",
        // M502 не имеет параметров. Загружает заводские настройки по умолчанию.
        // Все пользовательские настройки (углы_HOME, люфты, ограничения и т.д.)
        // сбрасываются к заводским значениям.
        .params = {},
        .paramCount = 0,
        .handler = handleM502,
    },
    {
        .name = "?",
        .description = "Show help",
        // Символ "?" не является G/M-командой, но обрабатывается как команда помощи.
        // Выводит справку по всем доступным командам и их параметрам.
        .params = {},
        .paramCount = 0,
        .handler = handleHelp,
    },
};

// Вычисление количества команд в таблице на основе размера массива.
// Используется при переборе команд в парсере G-кода для поиска
// команды по имени.
const int COMMAND_COUNT = sizeof(COMMANDS) / sizeof(COMMANDS[0]);
