SpellcasterMom/test/src/ik_solver.h

/**
 * Project     : 6DOF arm
 * Codename    : CLAW
 * Author      : Vladimir V. Laykov aka Yago
 * Alma Mater  : Sevastopol State University
 * Group       : УТС/б-23-1-о
 * Mentor      : Lipko I.Y.
 * Date        : 2026-09-18
 * Last modify : 2026-10-01
 *
 * Описание   : Заголовочный файл решателя обратной кинематики (IK) для 6-DOF
 *              манипулятора. Класс IKSolver реализует двухэтапный алгоритм:
 *                1) Геометрическое решение позиции (суставы q1–q3)
 *                2) DH-декомпозиция ориентации (суставы q4–q6)
 *              Математика расписана в KINEMATICS.md (корень) — референс.
 */

#pragma once

#include "types.h"
#include "config.h"
#include "fk_solver.h"

/**
 * Метаданные численного уточнения IK-решения (damped least-squares).
 */
struct IKSolutionMeta {
    int iters = 0;          // выполнено итераций DLS
    bool converged = false; // сошлось по допускам (позиция + ориентация)
    float seedPos = 0;      // расхождение позиции у seed'а (мм)
    float seedOri = 0;      // расхождение ориентации у seed'а (град)
    float dbgDq0 = -1;      // норма первого dq (рад), -1 = не было итераций
    float dbgN1 = -1;       // норма ошибки после первого полного шага
};

/**
 * Класс IKSolver — решатель обратной кинематики.
 *
 * Алгоритм работы:
 *   1. По заданной целевой позе (x, y, z, roll, pitch, yaw) вычисляются
 *      углы поворота шести суставов манипулятора.
 *   2. Сначала методом solvePosition() определяются углы первых трёх
 *      суставов (q1, q2, q3) для достижения целевой позиции конца звена.
 *      Это делается геометрически — через проекцию задачи на плоскость
 *      и применение теоремы косинусов для двухзвенного манипулятора.
 *   3. Затем методом solveOrientation() вычисляются углы последних трёх
 *      суставов (q4, q5, q6). Геометрия НЕ предполагает сферическое запястье,
 *      поэтому дальше каждое решение доводится численным методом
 *      refineSolution() (damped least-squares по FK-якобиану, полная цепочка
 *      6 суставов + палец) — это устраняет ошибку несферического запястья.
 *      Используется матричный подход: из желаемой ориентации (R06) вычитается
 *      вклад первых трёх суставов (R03), полученная матрица R36 декомпозируется
 *      на углы Эйлера ZYX.
 *
 * ВАЖНО (Last modify: 2026-09-25):
 *   IK решает позицию ЗАПЯСТЬЯ, а не TCP. Длина пальца (fingerLength)
 *   вычитается из целевой позиции TCP перед вызовом solvePosition().
 *   Это устраняет ошибку ~20 мм, когда G0 X100 Y100 Z100 давало
 *   Position X=83 Y=127 Z=116.
 *
 * ВАЖНО (численное уточнение):
 *   Геометрические решения — только seed'ы. Финал доводит refineSolution()
 *   по полной FK-цепочке (включая вылеты запястья 3×25 мм и палец),
 *   поэтому TCP сходится к заданной цели и по позиции, и по ориентации.
 */
class IKSolver {
public:
    IKSolver();

    /** Установка DH-параметров (a, alpha, d) для шести звеньев */
    void setDHParams(const float dh[6][4]);

    /** Установка длин звеньев (используются для геометрического решения) */
    void setLinkLengths(const int lengths[6]);

    /** Установка механических ограничений сервоприводов */
    void setServoLimits(const ServoConfig servos[7]);

    /**
     * Установка длины пальца захвата.
     *
     * Длина пальца вычитается из целевой позиции TCP перед решением
     * задачи позиции (solvePosition). Так IK решает для ЗАПЯСТЬЯ,
     * а не для TCP. Без этой коррекции G0 X100 Y100 Z100 даёт ошибку
     * ~20 мм из-за смещения TCP относительно запястья.
     *
     * @param len — длина пальца в мм
     */
    void setFingerLength(float len) { fingerLength = len; fkSolver.setFingerLength(len); }

    /**
     * Основной метод решения обратной кинематики.
     *
     * @param target  — целевая поза (позиция + ориентация в Эйлерах ZYX)
     * @param result  — выходные углы суставов q1–q6
     * @return true, если решение найдено и находится в допустимых пределах
     */
    bool solve(const Pose &target, JointAngles &result);

    /**
     * Проверка достижимости целевой позиции.
     * Решает только задачу позиции (q1–q3) и проверяет, попадает ли
     * целевая точка в рабочее пространство манипулятора.
     */
    bool isReachable(const Pose &target);

    /**
     * Поиск всех возможных решений (elbow up / elbow down).
     *
     * Для задачи позиции существуют два решения (прямая и обратная конфигурация
     * двухзвенного манипулятора). Каждое решение дополняется решением задачи
     * ориентации, а затем доводится refineSolution() по полной FK-цепочке.
     *
     * @param target     — целевая поза
     * @param solutions  — массив найденных решений (максимум 4)
     * @param meta       — метаданные уточнения (может быть nullptr)
     * @return количество найденных решений
     */
    int solveAll(const Pose &target, JointAngles solutions[4],
                 IKSolutionMeta *meta = nullptr);

    /**
     * Численное уточнение решения (damped least-squares по FK-якобиану).
     *
     * Работает с ПОЛНОЙ цепочкой (все 6 суставов + палец через FK), поэтому
     * устраняет ошибку несферического запястья: TCP доводится к цели и по
     * позиции, и по ориентации. Seed (обычно геометрическое решение) задаётся
     * через q; захват (angles[6]) не трогается.
     *
     * @param target — целевая поза TCP
     * @param q      — seed на входе, уточнённое решение на выходе
     * @param meta   — iters/converged (может быть nullptr)
     * @return true если сошлось по допускам (см. setNumericParams)
     */
    bool refineSolution(const Pose &target, JointAngles &q,
                        IKSolutionMeta *meta = nullptr);

    /**
     * Численное уточнение по матричной цели (ядро DLS, см. .cpp).
     * @param pt — целевая позиция TCP (мм)
     * @param Rt — целевая ориентация (матрица 4x4, блок 3x3)
     */
    bool refineSolutionM(const Vec3 &pt, const Mat4 &Rt, JointAngles &q,
                         IKSolutionMeta *meta = nullptr);

    /** Настройка численного решателя: лимит итераций и допуски. */
    void setNumericParams(int maxIter, float tolPosMM, float tolOriDeg);

private:
    /* DH-параметры: a — длина звена, alpha — угол поворота, d — смещение */
    float a[6];
    float alpha[6];
    float d[6];

    /* theta_offset (математический ноль → DH-ноль), напр. J2: +90° = вертикаль */
    float thetaOff[6];

    /* Длины звеньев (для геометрического IK) */
    int   linkLen[6];

    /* Ограничения углов сервоприводов (мин/макс для каждого из 7 каналов) */
    ServoConfig servoLimits[7];

    /* Те же лимиты 0..5 в радианах (кэш для refineSolutionM, без 12 mults на вызов) */
    float qminRad[6];
    float qmaxRad[6];

    /* Длина пальца захвата (мм). Вычитается из TCP → запястье в solve(). */
    float fingerLength;

    /* Параметры численного решателя (см. setNumericParams) */
    int numMaxIter;
    float numTolPos;
    float numTolOri;

    /* Решатель прямой кинематики (используется для проверки решений) */
    FKSolver fkSolver;

    /** Протолкнуть DH/длина/палец во внутренний fkSolver. */
    void syncFk();

    /**
     * Вектор ошибки 6x1 для конфигурации q (радианы):
     * e[0..2] — позиция TCP минус цель (мм),
     * e[3..5] — ошибка ориентации × вес.
     */
    void ikError(const float qrad[6], const Mat4 &Rt, const Vec3 &pt, float e[6]);

    /** Решение СЛАУ 6x6 методом Гаусса с частичным выбором ведущего. */
    static bool solve6(const float A[6][6], const float b[6], float x[6]);

    /**
     * Геометрическое решение задачи позиции (суставы q1, q2, q3).
     *
     * Алгоритм:
     *   1) Вычисляется угол поворота основания q1 = atan2(y, x)
     *   2) Задача проецируется на 2D-плоскость (r, s), где:
     *      r = sqrt(x² + y²) - a0  (горизонтальное расстояние минус смещение основания)
     *      s = z - d0               (вертикальное расстояние минус высота основания)
     *   3) Для двухзвенного манипулятора (L1 = плечо, L2 = локоть) применяется
     *      теорема косинусов для нахождения угла q3:
     *        cos(q3) = (r² + s² - L1² - L2²) / (2·L1·L2)
     *   4) Угол плеча q2 вычисляется через разность углов:
     *        q2 = atan2(s, r) - atan2(L2·sin(q3), L1 + L2·cos(q3))
     *
     * ВНИМАНИЕ: (x, y, z) — это позиция ЗАПЯСТЬЯ, а не TCP.
     *
     * @param x, y, z — целевая позиция запястья
     * @param q1, q2, q3 — выходные углы суставов (в градусах)
     * @return true если точка достижима
     */
    bool solvePosition(float x, float y, float z, float &q1, float &q2, float &q3);

    /**
     * Общий мотор solvePosition/solvePositionClamped: геометрия руки
     * по (r,s). clamped=false — отказ при недостижимости (isReachable/solve),
     * clamped=true — зажать (r,s) в кольцо (сид для DLS).
     */
    bool solveArm(float x, float y, float z, bool clamped,
                  float &q1, float &q2, float &q3);

    /**
     * Зажатая версия solvePosition: вместо отказа (false) при недостижимости
     * возвращает решение с (r,s), зажатыми в достижимое кольцо
     * (рука максимально вытянута/сложена в сторону цели).
     * Это только СИД для DLS, не точное решение. Строгий solvePosition()
     * не трогаем — его использует isReachable().
     */
    bool solvePositionClamped(float x, float y, float z, float &q1, float &q2, float &q3);

    /**
     * Сид q1–q3 с компенсацией несферического запястья (fixed-point).
     * Чистый solvePosition(wx,wy,wz) кладёт J4 (конец звеньев 165+161)
     * в точку O6 (TCP − палец) — при несферическом запястье сид уходит
     * мимо и DLS не дотягивает. Итеративно переносим цель:
     *   J4t = O6t − (O6straight − J4), O6straight = FK(q123, 0,0,0).
     * Сустав 3 в getJointPosition = J4, сустав 6 = фланец O6.
     *
     * @return true если есть сид (строгий или зажатый), jx/jy/jz —
     *         скомпенсированная цель J4 (для elbow-up ветви)
     */
    bool seedArm(float wx, float wy, float wz,
                 float &q1, float &q2, float &q3,
                 float &jx, float &jy, float &jz);

    /**
     * Решение задачи ориентации (суставы q4, q5, q6) методом DH-декомпозиции.
     *
     * Алгоритм:
     *   1) Вычисляется матрица поворота R03 (от основания до 3-го сустава)
     *      как произведение DH-матриц трансформаций: R03 = T01 · T12 · T23
     *   2) Желаемая ориентация конца инструмента (ROLL, PITCH, YAW) преобразуется
     *      в матрицу поворота R06 с помощью функции eulerToMatrix()
     *   3) Вычисляется матрица ориентации запястья: R36 = R03⁻¹ · R06
     *   4) Матрица R36 декомпозируется на углы Эйлера ZYX методом decomposeRotation()
     *
     * @param A, B, C — целевые углы Эйлера (roll, pitch, yaw) в градусах
     * @param q1, q2, q3 — уже вычисленные углы первых трёх суставов
     * @param q4, q5, q6 — выходные углы запястья (в градусах)
     * @return true если декомпозиция выполнена
     */
    bool solveOrientation(float A, float B, float C, float q1, float q2, float q3,
                          float &q4, float &q5, float &q6);

    /**
     * То же, но целевая ориентация уже в матрице Rt (посчитана один раз
     * на цель в solve()/solveAll()). Экономит повторные eulerToMatrix
     * (6 sin/cos каждый) на каждый сид.
     */
    bool solveOrientationM(const Mat4 &Rt, float q1, float q2, float q3,
                           float &q4, float &q5, float &q6);

    /**
     * Ограничение угла углами механических ограничений сервопривода.
     * Если угол выходит за пределы [minAngle, maxAngle], он обрезается
     * до ближайшей допустимой границы.
     */
    float clampAngle(int servoId, float angle);

    /**
     * Преобразование углов Эйлера ZYX в матрицу поворота 4×4.
     *
     * R = Rz(yaw) · Ry(pitch) · Rx(roll)
     */
    Mat4 eulerToMatrix(float roll, float pitch, float yaw);

    /**
     * Декомпозиция матрицы поворота R36 на углы Эйлера ZYX.
     *
     * R36 = Rz(q5) · Ry(q4) · Rx(q6)
     *
     * Особый случай: замок кардана (gimbal lock), когда pitch = ±90°.
     */
    void decomposeRotation(const Mat4 &R, float &q4, float &q5, float &q6);

    /** 3×3: R36 = R03ᵀ · R06 (только блок вращения, без 4×4-накладных) */
    static void matMul3x3T(const Mat4 &R03, const Mat4 &R06, Mat4 &R36);
};
