SpellcasterMom/test/(commit log)

2026-09-17 6DOF arm controller: display ST7789, safety, IK/FK, G-code
2026-09-17 README: описание проекта 6DOF arm
2026-09-18 убраны иероглифы из комментариев всех файлов
2026-09-18 убраны иероглифы 肘 из ik_solver (12 штук)
2026-09-18 исправлена дата в заголовке main.cpp
    [main.cpp]
2026-09-18 дата 2026-09-18 во всех заголовках файлов
2026-09-21 ESP32-C6: board=esp32-c6-devkitc-1, порт ttyACM0, xTaskCreate (одноядерный)
2026-09-21 откат на esp32dev, 2 ядра, xTaskCreatePinnedToCore
2026-09-21 убрана лишняя зависимость eigen (не используется)
2026-09-21 фикс angleToPulse (убран *1000), M410 (6 параметров), убран мёртвый код
2026-09-21 аудит: исправлены 3 критических + 4 средних бага
    - ik_solver: пересчёт q2 при elbow-up
    - motion_interpolator: M112 не игнорируется в auto-fallback
    - config: correctionFactor float вместо uint8_t
    - main: displayMutex timeout 50мс вместо 5мс
    - platformio: убран -fexceptions (экономия ~50KB flash)
    - safety: fingerLength синхронизируется с внутренним FK
    - eeprom: стратегия сохраняется корректно
    [config.h, eeprom_storage.cpp, eeprom_storage.h, ik_solver.cpp, main.cpp, motion_interpolator.cpp, safety_checker.cpp]
2026-09-21 обновлены диапазоны сервоприводов: P1-P3 270°, P4-P7 180°
2026-09-21 добавлена демонстрация endpoint control (8 позиций) в комментарии main.cpp
2026-09-21 демо: убраны комментарии, добавлена инструкция ждать OK
2026-09-23 feat: display init before I2C, PCA9685 optional for debug
2026-09-24 fix: minReach=25 соответствует физической модели (плечо на 25мм от оси Z)
    [config.h]
2026-09-24 feat: echo команды в порт, убран прогресс-бар из дисплея
2026-09-24 fix: minReach=0, joints могут подходить к оси Z
    [config.h]
2026-09-24 fix: zMin[0]=0, база на уровне стола
    [config.h]
2026-09-24 fix: WORKSPACE.zMin=0, стол на уровне Z=0
    [config.h]
2026-09-24 fix: zMin[1]=0, плечо может опускаться ниже стола
    [config.h]
2026-09-25 убрар перезагрузку контролера
2026-09-25 оптимизация работы дисплея
2026-09-25 кинематика
2026-09-29 feat: M115 kinematics diagnostics + 30 deg/s limit on P1-P3
2026-09-29 fix: LM line-search IK refine (guaranteed descent) + seed residual in M115
    [ik_solver.cpp, ik_solver.h, main.cpp]
2026-09-29 fix: axis-angle ori error (no sin fold) + first-step dbg in M115
    [ik_solver.cpp, ik_solver.h, main.cpp]
2026-09-29 fix: active-set DLS (walled joints excluded) + ori weight 30
    [ik_solver.cpp]
2026-09-29 fix: DLS descent sign (dq = -Jt*y) — refine was climbing
    [ik_solver.cpp]
2026-09-29 fix: effPose stays in handleG0 scope (G28/MIXED eval lines)
    [main.cpp]
2026-09-29 fix: servo speed limits are hard ceiling (feedrate only slows down)
    [motion_interpolator.cpp, motion_interpolator.h]
2026-09-29 feat: keep LIN traj-fail reason in SEQ fallback mark (M115)
    [motion_interpolator.cpp, motion_interpolator.h]
2026-09-29 fix: sync interpolator start state (G0/G28/boot) — kills false SEQ fallback
    [main.cpp]
2026-09-29 fix: valid default home/park pose + G28 and boot home safety validation
    [config.h, main.cpp]
2026-09-30 feat: vertical zero (theta_offset J2 +90) + IK math-frame alignment
2026-10-01 feat: DH from robot1 drawing + kinematic finger 132 (27+105); M414 persists to config
2026-10-01 docs: group tag УТС/Б-23-1-О in all file headers
2026-10-01 docs: group tag case УТС/б-23-1-о, README repo link (masked key) + DH table
2026-10-01 fix(ik): wrist-compensated seeds + zeros seed + current-pose candidate; DH untouched
    [ik_solver.cpp, ik_solver.h, main.cpp]
2026-10-01 fix(safety): workspace box to true robot1 extents (was rejecting zeros TCP z=514)
    [config.h]
2026-10-01 fix(display): M104 pushes state to sharedState (screen was stale on direct moves)
    [main.cpp]
2026-10-01 feat(M104): route direct joint moves via interpolator (ease-in-out, speed limits, safety)
2026-10-01 fix(motion): clamp moveTo targets to servo limits (single choke point for G0/M104/G28)
    [motion_interpolator.cpp]
2026-10-01 fix(gcode): working G91 relative + per-axis hold; refuse moves with bad residual
    [gcode_parser.cpp, main.cpp, types.h]
2026-10-01 Revert "fix(gcode): working G91 relative + per-axis hold; refuse moves with bad residual"
    This reverts commit f54122a69b773bd5c826c4f0971be149a8fb685d.
    [gcode_parser.cpp, main.cpp, types.h]
2026-10-01 fix(ik): default tool orientation +X (90,0,90) — matches zeros, keeps wrist straight
    [config.h, main.cpp]
2026-10-01 fix(display): status bar layout — ABS/REL mid line1, bare last command line3
    [main.cpp]
2026-10-01 fix(display): ABS/REL to mid-line x=128 per layout
    [main.cpp]
2026-10-01 fix(display): ABS over PCA column x=110, PCA one char right
    [main.cpp]
2026-10-01 fix(display): redraw ABS/REL and last command only on change (flicker)
    [main.cpp]
2026-10-01 fix(display): gate status text on change, 8-char field — stops clipping ABS
    [main.cpp]
2026-10-01 Reapply "fix(gcode): working G91 relative + per-axis hold; refuse moves with bad residual"
    This reverts commit 850e182df3284ce8a523ad79431b329c0e1f2fed.
    [gcode_parser.cpp, main.cpp, types.h]
2026-10-01 docs: command reference, pinout, kinematics, safety, FAQ, version + robot1 drawing
2026-10-01 feat: cad/ directory for STEP 3D models (+naming convention)
2026-10-01 feat(fw-version): EEPROM version stamp + auto factory-reset+reboot on mismatch; home=zeros
    [config.h, eeprom_storage.cpp, eeprom_storage.h, main.cpp]
2026-10-01 feat(display): firmware version line under gripper row (drawn once)
2026-10-01 fix(display): ST77XX_BLACK on Adafruit branch (was TFT_BLACK)
    [main.cpp]
2026-10-01 feat(display): ST7789 via LovyanGFX (DMA, built-in fonts)
2026-10-01 fix(display): cast VSPI to spi_host_device_t for LovyanGFX
    [main.cpp]
2026-10-01 fix(display): SPI2_HOST directly — VSPI macro rejected by spi_bus_initialize
    [main.cpp]
2026-10-01 fix(display): rotation 0 + panel inversion on for this ST7789
    [main.cpp]
2026-10-01 fix(display): ST77XX_BLACK leftover from Adafruit branch merge
    [main.cpp]
2026-10-01 fix(diag): preserve threshold failReason instead of stomping with generic text
    [main.cpp]
2026-10-01 fix(safety): link zMin 20->10mm (was rejecting valid poses); FW_VERSION 2
    [config.h]
2026-10-01 feat(jog): manual pendant — handwheel + NEXT (P1-P7 incl gripper) + E-stop via ISR
2026-10-01 feat(jog): E-STOP on dedicated pin, always armed even with JOG_ENABLED=false
2026-10-01 feat(dh-v2): J6 = tool roll axis (P6 spins gripper in place); finger 105; FW 3
2026-10-01 feat(demo): endpoint-control runner — fixed TCP, tool +X to down, 10xG1
    [demo_endpoint.py]
2026-10-01 feat(demo): 5 big steps (~22deg tool, ~50deg joints) instead of 10
2026-10-01 feat(demo): 12 steps (~7.5deg tool, ~20deg joints), all converged
2026-10-01 docs: endpoint demo block = 12-step fixed-TCP script
    [main.cpp]
2026-10-01 docs: расхождение instead of невязка in comments
2026-10-01 docs: расхождение instead of невязка
2026-10-01 docs: расхождение in ik_solver.cpp comment
2026-10-01 docs: расхождение in demo comment
2026-10-02 feat(servo): PCA9685 via janelia-arduino (microseconds, no ticks)
2026-10-02 docs(servo): purge Adafruit/ticks leftovers from comments
2026-10-02 fix(servo): stray braces + unclosed doc comment
    [servo_controller.cpp]
2026-10-02 docs: branch status — servo bertos + adafruit-old snapshot
2026-10-02 feat(motion): Cartesian G1 — TCP straight line via per-step IK (endpoint holds)
2026-10-02 fix(cartesian): correct gimbal extraction (yaw=atan2(-R01,±R02))
    [motion_interpolator.cpp]
2026-10-02 fix(cartesian): per-step IK budget 25 + compute-aware pacing
    [motion_interpolator.cpp]
2026-10-02 fix(demo): flush stale input before send, 120s timeout
    [demo_endpoint.py]
2026-10-02 fix(demo): line-buffered stdout (no more silent hangs in pipes)
    [demo.py, demo_endpoint.py]
2026-10-02 fix(demo): auto-detect serial port (was hardcoded ttyUSB1)
    [demo_endpoint.py]
2026-10-02 fix(demo): M114/M115/M105 have no OK — accept non-empty output
    [demo.py]
2026-10-02 fix(demo): idle-timeout for no-OK commands (M115 ate full 30s)
    [demo.py]
2026-10-02 fix(cartesian): time estimate from nearest end-IK branch (was crawling on far branch)
    [motion_interpolator.cpp]
2026-10-02 fix(diag): Cartesian CHOSEN = nearest safe sol to actual + cart-tracked tag
    [main.cpp]
2026-10-02 revert: continuity bias out (demo-only scope)
    [main.cpp]
2026-10-02 feat(ik): continuity bias in selection (anchor near current pose)
2026-10-02 fix(demo): open serial without ESP32 reset (DTR/RTS before open, 15s wait)
    [demo_circle.py, demo_endpoint.py]
2026-10-02 feat(cad): reach.stl — envelope of reachable TCP volume
    [reach.stl]
2026-10-02 feat(cad): smooth reach.stl via marching cubes (numpy+skimage); no closed inner voids
    [reach.stl]
2026-10-02 feat(cad): mushroom workspace (column subtracted) + twin validation
    [base_column.stl, reach.stl]
2026-10-02 feat(cad): dexterous cores dex_x/dex_down (only 27%/12% of positions)
    [dex_down.stl, dex_x.stl]
2026-10-03 docs: KINEMATICS.md — reference of the math pipeline (do not touch lightly)
2026-10-03 fix(ik): height penalty 0.15 capped at 15 (low branch loses)
    [main.cpp]
2026-10-04 feat(safety): skip static link0 + per-zone link mask (construct skips 0-2)
    [config.h, safety_checker.cpp, safety_checker.h]
2026-10-04 feat(twin): RRT detour in joint space (multi-box, smoothed)
2026-10-04 feat(detour): planner module — face vias + joint RRT + waypoint execution
2026-10-04 fix(detour): qs->qstart in fast path
    [detour_planner.cpp]
2026-10-04 chore(fw): FW 6 — re-migrate (construct zone mask was missing in stored v5)
    [config.h]
2026-10-04 fix(safety): preserve zone skipLinks through runtime sync (mask was dropped)
    [main.cpp, safety_checker.cpp, safety_checker.h]
2026-10-04 fix(display): full Roll/Pitch/Yaw labels, tightened right column
    [main.cpp]
2026-10-04 fix(display): RPY labels +12, P4-P6/RPY values right-aligned to x=232
    [main.cpp]
2026-10-04 fix(display): drop stray unit args in drawFieldR calls
    [main.cpp]
2026-10-04 fix(display): no label/value overlap — drop padding space, widen columns
    [main.cpp]
2026-10-04 feat(gripper): M108 S<%> — захват в процентах через interpolator
2026-10-04 docs: FLOW.md — блок-схемы тракта G0, ядра IK, отказов
2026-10-05 docs(todo): техдолг самоколлизий (капсулы, сферы, объезд)
2026-10-05 кинематик в док
2026-10-05 chore: убрать .py из корня, свежие версии живут в tools/
2026-10-05 docs: MATH.md — записка по кинематике/планировщику/ограничениям с формулами
2026-10-05 docs(math): явно развести сиды-геометрию и матричную доводку DLS
2026-10-05 docs(math): полная записка — выводы формул, 2 метрики dOri, сервы, RRT, сэмплинг
2026-10-05 docs(math): сквозная нумерация 1-31, ссылки по номерам, ортант без артефактов
2026-10-05 docs(math): невязка -> расхождение
2026-10-05 docs(math): рубеж -> ограничение
2026-10-05 docs(math): §0 введение для читателя со стороны + фикс ссылки на §2.2
2026-10-05 перевод с русского на русский
2026-10-05 docs(math): опечатки + RS232->USB-UART
2026-10-05 docs(math): USB-CDC/UART, сквозные принципы вместо нарративов
2026-10-05 docs(math): оглавление вместо карты записки
2026-10-05 docs(math): нумерация глав с 1 (1-8), оглавление синхронно
2026-10-05 docs(math): расшифровка p*/R*/q в постановке задачи
2026-10-05 docs(math): расшифровки символов где-строками у всех формул
2026-10-05 docs: MATH.docx (pandoc, уравнения OMML), FLOW.vdx (схемы для Visio), фикс ссылки (32)->(31)
2026-10-05 docs: codename CLAW in main.cpp header
2026-10-05 docs(todo): техдолг IMU — сверка ориентации и guard соударений
2026-10-05 docs(todo): IMU GY-80 чипы, логгер, гиро на Core1, baud 921600
2026-10-05 docs(readme): полная легенда M115 (KIND/INTERP/wrist/minZ/dq0/WPS/FAIL)
2026-10-05 fix невязка
2026-10-05 ссылка на исходники 3d моделей
2026-10-05 Альма матер
2026-10-05 docs: Codename CLAW + Alma Mater во все заголовки (даты не тронуты)
2026-10-05 feat(tools): jogger.py — джог серв с клавиатуры (qa/ws/…/uj, ~ = M105)
2026-10-05 fix(jogger): пустая строка после каждой команды, drain клавиш, шапка Last modify
    [jogger.py]
2026-10-05 fix(jogger): вернуть OPOST/ONLCR после setraw — лесенка в выводе
    [jogger.py]
2026-10-05 feat(jogger): клавиша 0 — все сервы в 0
2026-10-05 fix(jogger): зажим целей в лимиты серв (±135/±90/0-100)
    [jogger.py]
2026-10-05 feat(display): GYR-кружок GY-80 + PCA-кружок вместо ON/OFF, скан I2C
2026-10-05 feat(display): FW 6(1.5) в шапку TCP POS справа, убран дубль из JOINTS
2026-10-05 fix(tools): принимать OK: префикс (G90/G91/M108 отвечали так, был ложный TIMEOUT)
    [demo_circle.py, demo_endpoint.py]
2026-10-05 feat(tools): demo_circle пресеты tilt/plusx + лог M115 в файл
2026-10-05 docs(tools): факт tilt-прогона 24/24 OK пик 0.3 в шапку demo_circle
2026-10-05 тесты прошлию лог удалил
2026-10-05 feat(deps): либы GY-80 (ADXL345, L3G, HMC5883L, BMP085) + Unified Sensor
2026-10-05 deps: убрать Adafruit (тяжёлые), оставить pololu/L3G; остальное своим драйвером
2026-10-05 deps: +sparkfun ADXL345 на аксель (лёгкая, без зависимостей)
2026-10-05 feat(display): GYR зелёный при гиро+аксель (магнит/баро опциональны), маска в Serial
2026-10-05 feat(display): GYR трёхцветный — зелёный гиро+магнит, жёлтый только гиро, красный нет гиро
2026-10-05 fix(display): GYR по акселю (зелёный=гиро+аксель), магнит не участвует
    [main.cpp]
2026-10-05 hw: ревизия железа 1.1 (показывает ?)
2026-10-05 docs(todo): IMU (д) резонансы — tap/sweep/АЧХ/shaper после сборки
2026-10-05 docs: Alma Mater -> Almamater везде (28 файлов)
2026-10-05 docs: Almamater -> Alma Mater везде (28 файлов)
2026-10-05 feat(imu): логгер GY-80 — драйвер, калибровка в home, кольцо, M119, i2cMutex
2026-10-05 fix(imu): CALIB в setup литералами — дефайны дисплея ниже по файлу
    [main.cpp]
2026-10-05 refactor(imu): стартовый заезд через handleG28 вместо прямого moveTo
2026-10-05 fix(imu): инит ADXL регистрами напрямую — powerOn() вешал шину повторным Wire.begin()
    [imu_logger.cpp]
2026-10-05 fix(imu): bounded I2C (timeout 20мс/100мс) + самовосстановление шины и чипов
    [imu_logger.cpp, imu_logger.h, servo_controller.cpp]
2026-10-05 fix(imu): backoff опроса при дохлой шине, счётчики fails/recovers в M119
    [imu_logger.cpp, imu_logger.h, main.cpp]
2026-10-05 fix(i2c): 400кГц->100кГц — замеренные подтяжки 11к не тянут фронт
    [imu_logger.cpp, servo_controller.cpp]
2026-10-05 docs(todo): проводка GY-80 ≤20см + 4.7к (факт клина на 50см/11к)
2026-10-06 feat(imu): голый транспорт регистров, либы выкинуты, возврат 400кГц
2026-10-06 docs: agent.md соглашения + CAD коннекторы/приводы (STEP+STL)
    [connector_corner.stl, connector_corner.stp, connector_straight-shift.stp, connector_straight.stl, connector_straight.stp, connector_straight_shift.stl, drivebig.stl, drivebig.stp]
2026-10-06 Dir change
    [connector_corner.stl, connector_corner.stp, connector_straight-shift.stp, connector_straight.stl, connector_straight.stp, connector_straight_shift.stl, drivebig.stl, drivebig.stp]
2026-10-06 fix(cad): дефис в подчёркивание connector_straight_shift.stp
    [connector_straight_shift.stp]
2026-10-06 feat(imu): метки старта/вейпоинтов в сэмплах кольца (f=1/2)
2026-10-07 feat(tools): tcp_console.py — G-code по TCP-мосту (интерактив/команда)
2026-10-07 feat: Serial 115200->921600 везде (SERIAL_BAUD в config.h)
2026-10-07 feat(boot): заезд в home всегда, калибровка IMU только при датчике
2026-10-07 feat(boot): старт из парка (DEFAULT_PARK_ANGLES), G28 с подачей F
2026-10-07 docs(todo): несброшенный INTERP в M115 после ERROR
2026-10-07 fix(diag): INTERP NONE после отказа без движения (G0x2, G28)
    [main.cpp]
2026-10-07 docs(todo): закрыт пункт про INTERP-след (починено)
2026-10-07 fix: setMark публичный (вызовы из обработчиков)
    [motion_interpolator.h]
2026-10-07 docs: Last modify 2026-10-07 (потерялась в мёрже usb1)
2026-10-07 cad: base_rotor правильная модель (переделка)
    [base_rotor.stl, base_rotor.stp]
2026-10-07 fix(servo): зеркало инверсии вокруг центра + P1-P3 inverted + FW 7
    [config.h, servo_controller.cpp]
2026-10-07 fix(servo): P2 direct (флаг снят), FW 8, зеркало в MATH §6
    [config.h]
2026-10-07 chore: FW_VERSION_STR 1.5->1.6 + правило бампа в agent.md
2026-10-07 docs: мок FW 8(1.6) в шапке и комментарии
2026-10-07 fix(servo): верные флаги F,T,F по M502-тестам + FW 9
    [config.h]
2026-10-08 docs: README под факт мастера + tools/cad README + люфты в TODO
2026-10-08 docs: процедура выключения M112+сброс питания и просадка
2026-10-08 docs(math): §3.9 дрейф/ворота, §6.6 капсулы, §8 факты, §9 IMU (32-34)
2026-10-08 docs(math): аксель/гиро -> акселерометр/гироскоп везде
2026-10-08 docs(math): §8 подробно по-дипломному (8.1-8.6, без жаргона)
2026-10-08 docs(math): §5 академически гладко (факты и цифры те же)
2026-10-08 docs(math): §4 академически + зачистка жаргона везде + MATH.docx
2026-10-08 docs: MATH.docx вашей командой pandoc (tex_math_dollars+single_backslash)
2026-10-08 docs(math): абзац про эйлеры подробно + инструмент vs запястье
2026-10-08 docs(math): §2 строго академически
2026-10-08 заголофок исправлен
2026-10-08 Заголовки коррекировка
2026-10-08 docs(math): §3.6 подробно — вывод LM, расписание λ, сложность, чтение сходимости
2026-10-08 docs: невязка->расхождение везде + опечатка расчёта
2026-10-08 docs: биас->штраф везде + пояснения за что каждый штраф
2026-10-08 docs(math): оглавление под правленые заголовки
2026-10-08 docs: MATH.docx пересобран из обновлённого md (37 формул)
2026-10-09 docs(math): §6 подробно академически
2026-10-09 обновление описания
2026-10-09 docs(math): штраф за низость — точная формулировка
2026-10-09 docs(math): §7 подробно самодостаточно (7.1-7.5), флаги как открытый вопрос
2026-10-09 docs(agent): статус направлений P1-P3, точка продолжения
2026-10-09 docs(agent): уплотнить статус P1-P3
2026-10-09 docs: INFRA.md — карта инфраструктуры (робот/helper/сеть/репо/песочница)
2026-10-09 feat(prompts): промт презентации CLAW для Gamma + бренд СевГУ
2026-10-09 opt: eeprom cache + checksum без бранча, safety/detour без sqrt в горячем пути
2026-10-09 opt: FK за один проход (getPose) + перевод safety/ik/diag/interp, зеркало в двойнике
2026-10-09 opt: IK дешевле (Rt раз на цель, solveArm общий, квадраты норм, R36 3x3, FK кэш trig + rad-путь)
2026-10-09 opt: сервы пакетно (computePulseUs, кэш corrK/ranges, один мьютекс на setAngles)
2026-10-11 opt: G-code parser single pass without String (fix X catches MAX)
    [gcode_parser.cpp, gcode_parser.h]
2026-10-11 fix: trailing newline at end of parser files
    [gcode_parser.cpp, gcode_parser.h]
2026-10-11 fix: P4 inversion flag + FW 10 (P4 jog sign check)
    [config.h]
2026-10-11 fix: стартовый refresh home-PWM на все 7 серв (не только движущиеся)
    [main.cpp]
2026-10-11 fix: парковочные углы от владельца (35,-120,135,65,0,0,0)
    [config.h]
2026-10-11 feat: блендинг G1 цепочкой Q1 (трапеция, без рестарта, пост-гейт 10/15)
2026-10-11 fix: PI -> CHAIN_PI (коллизия с макросом Arduino.h)
    [motion_interpolator.cpp]
2026-10-11 fix: вход в круг через G28 H1+G28, дешёвая оценка времени в цепочке
    [demo_circle.py, motion_interpolator.cpp]
2026-10-12 feat: пакет точек M450 (план отдельно, исполнение без остановок)
2026-10-12 fix: батч 64 точки + авто-чанкинг демо (fail-fast контракт)
    [commands.h, demo_circle.py, main.cpp, motion_interpolator.h]
2026-10-12 feat: стриминг точек M450 (кольцо, backpressure, исполнитель Core1)
2026-10-12 fix: убрать задвоенный хвост записи M450 (некомпиляция)
    [commands.h]
2026-10-12 fix: дубли execTrampoline и streamPlanned_, декларации задачи
    [motion_interpolator.cpp, motion_interpolator.h]
2026-10-12 fix: вернуть определение batchProfFor (линковка execLoop)
    [motion_interpolator.cpp]
2026-10-12 fix: CHAIN_RAMP_FRAC выше пользователей (порядок определений)
    [motion_interpolator.cpp]
2026-10-12 fix: вернуть opener комментария chainEase (stray-ошибки)
    [motion_interpolator.cpp]
2026-10-12 ref: app.h - общий хаб extern для распила main (без логики)
2026-10-12 ref: дисплей в display_ui (перенос 1:1, без логики)
2026-10-12 ref: диагностика M115 в kin_diag (перенос 1:1, без логики)
2026-10-12 ref: хендлеры движения в handlers_motion (перенос 1:1, без логики)
2026-10-12 ref: системные хендлеры в handlers_system (перенос 1:1, без логики)
2026-10-12 ref: setup нарезан на фазники (порядок тот же, без логики)
2026-10-12 fix: форварды фазников setup до использования
    [main.cpp]
2026-10-12 docs: README про новые команды (Q1, M450-поток, STREAM/CHUNKS в M115)
2026-10-12 feat: IMU-кольцо 2048 сэмплов — гиро пишется весь поток M450 целиком
2026-10-12 feat: метки вейпоинтов/hold в гиро + живой режим M119 S=2
2026-10-12 docs: структура проекта в README приведена к master
2026-10-12 chore: FW 11 / 1.8 (парк, boot-home, Q1-блендинг после FW 10)
2026-10-13 fix: ендпойнт по аналогии с кругом — boot-sync, G28-старт, M115, финал в парке
    [demo_endpoint.py]
2026-10-13 fix: 180/π в toolEulerZYX — одна константа DEG_PER_RAD
    [display_ui.cpp]
2026-10-13 fix: единый DEG_PER_RAD/RAD_PER_DEG из types.h (display, motion, IMU)
    [display_ui.cpp, imu_logger.cpp, motion_interpolator.cpp, types.h]
2026-10-13 opt: float-константы вместо double-макросов (39 мест) + пики IMU без sqrt
2026-10-13 docs: структура проекта в README — распил, стрим, IMU, INFRA, prompts
2026-10-13 feat: IMU-кольцо 4096 сэмплов (~20 с, ~72 КБ статики)
2026-10-13 feat: MCP-сервер робота (mcp/, 11 тулов, Serial+TCP)
2026-10-13 fix: mcp-сервер в порядок — импорт без тени, move_stream M450, шапки
    [commands.py, server.py, transport.py]
2026-10-13 файл
2026-10-13 fix: пины I2C+SPI централизованы в config.h (переразводка = один блок)
    [config.h, display_ui.h, imu_logger.cpp, main.cpp, servo_controller.cpp, servo_controller.h]
2026-10-13 fix: подъём I2C в один хелпер bringUpI2CBus (i2c_bus.h)
    [i2c_bus.h, imu_logger.cpp, servo_controller.cpp]
2026-10-14 chore: FW 12 / 1.9 (стрим M450, IMU-20с/live, MCP, пины, константы после FW 11)
2026-10-15 feat: тексты под BMI160 (HW 1.3), драйвер пока GY-80 — см. TODO(bmi160)
2026-10-15 feat: GYR-кружок двухцветный (чип есть/нет — один BMI160, жёлтого нет)
2026-10-15 feat: драйвер BMI160 вместо GY-80 (CHIP_ID, PMU, ranges, burst 12Б)
2026-10-15 fix: в справке ? — S=2 у M119 и строка про батч M450
    [handlers_system.cpp]
2026-10-15 feat: зонд люфтов backlash_probe.py (треугольник + гиро, R_mount=I)
    [backlash_probe.py]
2026-10-15 fix: цепочка люфтов M400→config→M500→компенсатор (FW 13/2.0, float)
    [commands.h, config.h, handlers_system.cpp, handlers_system.h, main.cpp]
2026-10-15 fix: зонд читает M400, шлёт полные наборы, P7 сохраняет
    [backlash_probe.py]
2026-10-15 feat: зонд ±5°/F10 + sanity пика гиро
2026-10-15 chore: FW 14 / 2.1 (минор после BMI160-драйвера)
2026-10-15 feat: ендпойнт пачкой M450/F20 без диагностики (гладкость вместо M115)
2026-10-15 32у3
2026-10-15 feat: ендпойнт — запястье на максимум B83.6 (предел ворот −5°)
2026-10-15 fix: ендпойнт без возвратной ноги (bulge 117мм через смену ветви)
    [demo_endpoint.py]
2026-10-15 feat: P7 в реальных градусах 7..38 (замер), проценты маппятся (FW 15/2.2)
2026-10-15 feat: IMU-кольцо ×2 слота (single/batch) + T-селектор M119 (FW 16/2.3)
2026-10-15 fix: слоты IMU 4096→2048 (DRAM не тянет 2×72КБ)
    [imu_logger.h]
2026-10-15 docs: M119 подробно (слоты, T-селектор, S=2)
2026-10-15 feat: метка вида движения f.3 (декарт/суставы), кольцо одно 20с (FW 17/2.4)
2026-10-15 fix: стартовая метка не затирает бит3 (f=9 вместо f=1)
    [imu_logger.cpp]
2026-10-16 feat: ендпойнт качает P1-P3 (TCP 180,0,280, связный маршрут, F30)
2026-10-21 feat: M108 S=50 [T=sec] — хватка P7 7..20°, время движения 0.5-3.0 с
    - GRIP_OPEN_DEG 38 -> 20 градусов (src/config.h)
    - M108 S=pct [T=sec]: опциональная длительность движения захвата
    (src/commands.h, src/handlers_motion.cpp)
    - T зажимается в [0.5, 3.0] сек; feedrate считается через
    interpolator.legMs() для точного времени хода
    - Обновлена справка M108 и комментарии jog_pendant.h (7-20°)
2026-10-21 fix: legMs public — нужен M108 T=sec для расчёта feedrate
    [motion_interpolator.h]
2026-10-21 fix: legMs перенесён в public — handleM108 вычисляет feedrate
    [motion_interpolator.h]
2026-10-21 feat: E-STOP на пине 26 теперь как M112 — stop + servoCtrl.disable() + imuLogger.setLive(false)
2026-10-21 fix: E-STOP ISR не делает I2C — servoCtrl.disable() перенесён в poll()
    [jog_pendant.cpp]
2026-11-08 feat: сервы P4–P6 заменены на 270° — диапазон ±135°, homeOffset 135°, FW_VERSION 17→18
2026-11-08 feat: защита от самопересечения кисти с плечом/локтем
    - LinkSafety: новое поле minLinkDistance (дефолт 20 мм), FW_VERSION 18->19
    - safety_checker: checkLinkDistances() — попарная дистанция между
    непротиворечащими звеньями (отрезки J0..J6->TCP, аналитически)
    - IK-путь (G0/G1): checkAllLinks AND checkLinkDistances -> жёсткий отказ
    - M104 (DIRECT_MODE): жёсткие проверки блокируют, самопересечение —
    только предупреждение WARN в Serial, движение не блокируется
    - docs/MATH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
2026-11-08 feat: zMin звеньев 2-5上げн с 10 до 25 мм (зазор предплечья со столом), FW_VERSION 19->20
2026-11-08 fix: EPS макрос из ESP32 SDK конфликтовал с локальной константой, переименовано в kEps
    [safety_checker.cpp]
2026-11-08 fix: IK-гейт теперь отбрасывает ветки с самопересечением звеньев (checkLinkDistances в diagEvalSol), чтобы solveAll подбирал безопасную ветку вместо жёсткого отказа
    [kin_diag.cpp]
2026-11-08 revert: FW_VERSION 20->17 (откатить бамп версии, чтобы EEPROM не сбрасывался при перепрошивке)
    [config.h]
2026-11-08 feat: FW_VERSION 17->20 (новые дефолты серв 270°, zMin 25 мм, защита самопересечения)
2026-11-08 feat: DEFAULT_PARK_ANGLES обновлены по железу: P4=65->100, P5=0->-100 (P1=35 P2=-120 P3=135 P6=0 P7=7 без изменений)
2026-11-08 feat: DEFAULT_PARK_ANGLES P5=-100->-130 (угол с железа)
2026-11-08 fix: самопересечение звеньев — предупреждение, не отказ (IK-гейт)。checkLinkDistances не блокирует движение, только WARN в Serial
    [handlers_motion.cpp, kin_diag.cpp]
2026-11-08 fix: самопересечение только для звеньев 3-6 (запястье), плечо/локоть не проверяются
    [safety_checker.cpp]
2026-11-08 fix: IK_ORI_TOL 15->20 grados (демо endpoint падал на dOri=15.7° при dPos=2.3мм; DH железа немного отличается от модели)
    [handlers_motion.cpp]
2026-11-08 docs: порог годности IK 15° -> 20° (в резон с кодом)
2026-11-08 fix: скорость запястья P4–P6 180->60°/с (270° сервы, не MG90S)
    [config.h]
