SpellcasterMom/test/docs/robot1.jpg

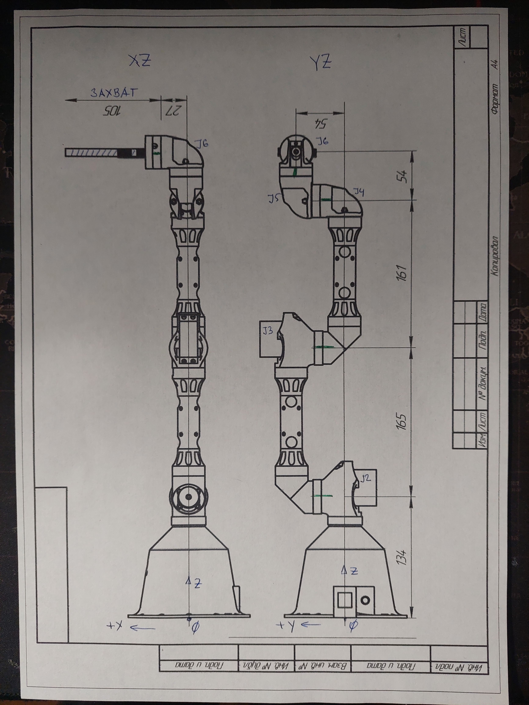
docs/robot1.jpg
